qaessafty-arch/Plc/DOCUMENTATION/REPORTS/budget.md

# Estimated budget

> Generated by `ELECTRICAL/BOM/budget.py` from `bom.csv`. **Every unit price is an estimate** made without supplier quotations, except two items whose range was taken from public supplier listings seen on 2026-11-11 (marked in the `price_basis` column). No price in this project is a verified purchase price. Freight, customs, VAT and local distributor margins for Iraq are covered only by the contingency line.

Exchange rate: 1 USD = 1320 IQD (Central Bank of Iraq cash selling rate, checked 2026-11-11; the parallel market rate may differ).

| Group | 1 Educational prototype | 2 Semi-industrial machine | 3 Industrial machine |
|---|---:|---:|---:|
| Structure | 722 | 5,872 | 5,872 |
| Film | 1,115 | 2,015 | 2,805 |
| Pull | 610 | 1,980 | 1,980 |
| Seal | 1,077 | 1,127 | 1,127 |
| Pneumatic | 1,095 | 1,170 | 1,170 |
| Control | 1,320 | 2,280 | 3,160 |
| Safety | 425 | 860 | 560 |
| Power | 1,925 | 2,301 | 2,301 |
| Sensors | 374 | 694 | 694 |
| Weighing | 205 | 9,000 | 45,000 |
| Conveying | 150 | 4,400 | 4,400 |
| Options | 0 | 0 | 20,900 |
| Services | 3,150 | 14,900 | 22,600 |
| **Subtotal USD** | **12,168** | **46,599** | **112,569** |
| Contingency + freight/customs allowance | 15% = 1,825 | 20% = 9,320 | 20% = 22,514 |
| **Total USD** | **13,993** | **55,919** | **135,083** |
| **Total IQD** | **18,471,024** | **73,812,816** | **178,309,296** |
| Expected accuracy of this estimate | +/-40 % | +/-30 % | +/-35 % |

## What each configuration is

| | 1 Educational prototype | 2 Semi-industrial | 3 Industrial |
|---|---|---|---|
| Purpose | teach/prove the VFFS sequence | small factory production | continuous production with QA records |
| Frame | aluminium profile, bench size | welded 304 stainless | welded 304, hygienic detailing, documented materials |
| Film / bag | <= 250 mm web, 60-110 mm bags | 420 mm web, 80-200 mm bags | same + gusset / hole-punch options |
| Weighing | single weigh bucket + vibratory tray (self-built) | economy 10-head multihead (bought) | branded 10/14-head, approvable for trade |
| Film drive | closed-loop stepper | 0.4 kW servo | servo; servo jaws as later option |
| Control | S7-1200 1214C + 4" panel | S7-1200 1215C + KTP700 + safety relays | fail-safe S7-1200 F + KTP700 + monitoring PC |
| Quality devices | none | none (manual sampling) | checkweigher, metal detector, coder, N2 |
| Expected speed | 8-15 bags/min (theoretical) | 30-45 bags/min (theoretical) | 40-60 bags/min (theoretical) |
| Suitable for selling food? | no | only after safety validation and hygiene review | yes, after conformity assessment |

## Operating cost outline (semi-industrial, theoretical)

Energy and film per hour are in `DOCUMENTATION/ENGINEERING/03_ENGINEERING_CALCULATIONS.md` section 8. Add: 1 operator + shared loader; product give-away (simulated ~1.4 % at 40 g, see `SIMULATION/weigher_results.json`); wear parts per year - PTFE tape, 2 knives, 1 pair pull belts, 2 heater sets, thermocouples: roughly 400-700 USD [estimate]; annual weigher calibration service.

BOM lines: 77. Items with `model_status` = *verified* had their order number and key data checked against manufacturer data on 2026-11-11; *from memory - confirm* must be checked in the manufacturer catalogue before ordering; *generic* means the specification is binding and the brand is free; *to quote/select* needs a supplier offer.
