qaessafty-arch/Plc/DOCUMENTATION/ENGINEERING/03_ENGINEERING_CALCULATIONS.md

# 03 - Engineering calculations (SPM-420, rev P1 (preliminary - not released for manufacture))

> Generated by `engineering_calcs.py` from `machine_params.py`. Do not edit by hand.
> **Every number below is a theoretical design value.** Inputs marked [ASM] in `machine_params.py` are assumptions that must be replaced by measurements before the design is released.

## 1. Bag, film and forming-tube geometry

Tube circumference = 2 x flat bag width, so `D = 2W/pi`. Film width = `2W + overlap`. Maximum pillow volume uses Robin's paper-bag approximation with the unsealed length `L - 2 x seal land`. Fill ratio = product bulk volume / maximum pillow volume; the design limit is 0.65 so the jaws never close on product.
| Product | Target g | Bulk density g/L [ASM] | Bag W x L mm | Tube OD mm | Film width mm | Product L | Max pillow L | Fill ratio | Check |
|---|---|---|---|---|---|---|---|---|---|
| Potato chips 40 g | 40.0 | 60.0 | 160 x 230 | 101.9 | 340 | 0.67 | 1.13 | 0.59 | OK |
| Extruded puffs 30 g | 30.0 | 45.0 | 160 x 240 | 101.9 | 340 | 0.67 | 1.20 | 0.55 | OK |
| Crackers 100 g | 100.0 | 250.0 | 140 x 200 | 89.1 | 300 | 0.40 | 0.73 | 0.55 | OK |
| Mini biscuits 150 g | 150.0 | 350.0 | 140 x 200 | 89.1 | 300 | 0.43 | 0.73 | 0.59 | OK |
| Coated nuts / mix 200 g | 200.0 | 600.0 | 140 x 190 | 89.1 | 300 | 0.33 | 0.67 | 0.50 | OK |

Maximum bag width from the 420 mm web: (420 - 20)/2 = **200 mm**; largest forming tube OD = 127.3 mm. Each bag width needs its own forming set (collar + tube): they are format parts.

## 2. Machine cycle and theoretical speed (intermittent motion)

| Bag length mm | Pull time s | Peak film speed m/s | Mechanical cycle s | Mechanical limit bags/min |
|---|---|---|---|---|
| 100 | 0.258 | 0.77 | 1.058 | 56.7 |
| 150 | 0.321 | 0.80 | 1.121 | 53.5 |
| 200 | 0.383 | 0.80 | 1.183 | 50.7 |
| 230 | 0.421 | 0.80 | 1.221 | 49.1 |
| 300 | 0.508 | 0.80 | 1.308 | 45.9 |

Cycle = jaw close 0.15 + seal dwell 0.45 + jaw open 0.15 + film pull + settle 0.05 s. Pull uses a trapezoidal profile, a = 6.0 m/s2, vmax = 0.8 m/s [ASM: limited by belt/film friction].

**Product transfer.** Drop from weigh-hopper gate to jaw plane = 1.90 m. Leading-edge free-fall time = sqrt(2h/g) = 0.62 s (air drag ignored, so the real value is longer). Chips arrive as a string; string duration is assumed 0.35 s [ASM - measure with high-speed video]. Tail arrival = 0.97 s after the dump command. The dump is commanded when the jaws start closing, so the tail must arrive before the *next* jaw-close starts, i.e. within one cycle minus jaw-close time: 1.07 s at the mechanical limit -> OK.

Theoretical limit for the reference bag = min(mechanical 49.1, weigher 70, product string 53.5) = **49.1 bags/min**. Rated design point: **40 bags/min** (19 % margin). Validated speed: *none yet*.

## 3. Film-pull servo sizing

| Quantity | Value |
|---|---|
| Film drag (collar + unwind) [ASM] | 60 N |
| Accelerated mass (film + 2 belts) | 0.62 kg |
| Peak belt force | 63.7 N |
| Torque at drive pulleys | 1.91 N.m |
| Load inertia reflected to motor | 0.404 kg.cm2 |
| Peak motor torque (gearbox eff. 0.9) | 0.47 N.m |
| RMS motor torque at rated speed | 0.25 N.m |
| Peak motor speed | 1273 rpm |
| Selected motor rated torque / speed [VER] | 1.27 N.m / 3000 rpm |
| Torque utilisation (peak / rated) | 37 % |
| Speed utilisation | 42 % |

One 0.4 kW servo drives both pull belts through a 5:1 planetary gearbox and a cross shaft with two bevel/timing stages, so the belts cannot run at different speeds. The 0.4 kW frame is the smallest V90 PROFINET size and is deliberately oversized: the unknown is film drag, and margin costs little. Inertia ratio must be checked against the motor rotor inertia in the Siemens data sheet (not transcribed here).

Length resolution with the 2500 ppr TTL encoder (x4): 3.8 um of film per count - three orders finer than the +/-1 mm bag-length target, so accuracy is governed by belt slip and registration, not by the drive.

## 4. Sealing forces and pneumatic sizing

| Actuator | Required force N | ISO cylinder | Force at 0.6 MPa, eff. 0.9 N | Safety factor | Free air per cycle NL | NL/min at 40 bpm |
|---|---|---|---|---|---|---|
| Horizontal jaws | 2304 | dia 63 x 60 | 1683 | 0.73 | 2.46 | 98 |
| Vertical seal bar | 640 | dia 40 x 30 | 679 | 1.06 | 0.48 | 19 |
| Knife | 150 | dia 25 x 20 | 265 | 1.77 | 0.13 | 5 |

Jaw seal area counts both transverse seals (top of the finished bag and bottom of the next) = 240 x 24 mm. Knife force 150 N is an assumption for 50 um laminate with a serrated blade. Actuators total 123 NL/min; adding 30 % for leakage/tubing and 30 NL/min for the optional bag-deflate/air-blast gives **189 NL/min (0.19 m3/min) at 0.6 MPa**. Specify a compressor of at least 0.28 m3/min FAD with dryer and 0.01 um oil-removal filtration (ISO 8573-1 class 1.4.1 where air can contact product or film inside).

Maximum jaw closing force 1870 N is a crushing hazard: see the safety file - guard interlock, not force limitation, is the protective measure.

## 5. Heating

| Zone | Mass kg | Heater W | Energy to 150 C kJ | Warm-up min (80 % to metal) |
|---|---|---|---|---|
| Z1 front jaw (steel) | 2.26 | 500 | 138 | 5.8 |
| Z2 rear jaw (steel) | 2.26 | 500 | 138 | 5.8 |
| Z3 vertical bar (aluminium) | 0.65 | 300 | 73 | 5.1 |

Steady state: heat carried away by the film in the seal lands = 116 W at 40 bpm (c = 1900 J/kg.K); convective/radiative loss estimated at ~131 W (3 bars, h = 10 W/m2K, ~0.035 m2 each [ASM]). Installed 1300 W gives a duty cycle of roughly 19 %, which leaves PID authority for recovery after a stop. Each zone has a type-K thermocouple in the jaw, time-proportioned SSR control from the PLC, and an independent bimetal cut-out (manual reset, 250 C) in series with the heater contactor coil.

## 6. Throughput, elevator and weigher capacity

| Product | kg/h at 40 bpm | L/h | Elevator utilisation |
|---|---|---|---|
| Potato chips 40 g | 96 | 1600 | 31 % |
| Extruded puffs 30 g | 72 | 1600 | 31 % |
| Crackers 100 g | 240 | 960 | 19 % |
| Mini biscuits 150 g | 360 | 1029 | 20 % |
| Coated nuts / mix 200 g | 480 | 800 | 16 % |

Z-bucket elevator: 1.8 L buckets at 152.4 mm pitch, filled to 60% (fragile product must not be heaped), chain speed 0.2 m/s -> **5102 L/h**. The elevator runs on demand from the weigher infeed level sensor, so utilisation above ~70 % means the speed (VFD) must be raised for that product.

Combination count for a 10-head weigher: C(10,3) = 120, C(10,4) = 210, C(10,5) = 252; all subsets = 1023. Accuracy is evaluated by Monte-Carlo in `SIMULATION/weigher_sim.py`, not asserted here.

Per-head target charge for 40 g = target / 3.5 = 11.4 g = 0.19 L -> 12 % of the 1.6 L hopper (must stay below ~70 % for chips so gates close cleanly).

## 7. Electrical load, protection and cable sizing

| Load | Input kW | Phase | PF [ASM] | Current A | Note |
|---|---|---|---|---|---|
| Multihead weigher (OEM cabinet) | 1.50 | L1 | 0.9 | 7.2 | own internal protection |
| Heaters Z1+Z2+Z3 | 1.30 | L2 | 1.0 | 5.7 | 3 SSR zones |
| 24 V DC power supply 240 W | 0.27 | L2 | 0.95 | 1.2 | PLC, HMI, valves, sensors |
| Film servo drive 0.4 kW | 0.47 | L3 | 0.7 | 2.9 | peak 3x for <0.3 s |
| Elevator VFD 0.37 kW | 0.49 | L3 | 0.7 | 3.1 | 1AC in / 3AC 230 V out |
| Take-off VFD 0.18 kW | 0.26 | L3 | 0.7 | 1.6 |  |
| Infeed vibratory feeder | 0.10 | L1 | 0.6 | 0.7 | thyristor controller |
| Date coder / service socket allowance | 0.30 | L1 | 0.9 | 1.4 |  |

Connected load **4.69 kW**; phase currents L1 9.4 A, L2 6.9 A, L3 7.6 A (arithmetic sum, conservative). Estimated running demand at 0.7 diversity: 3.3 kW.

* Main protective device: 16 A 4-pole C-curve MCB (>= 1.25 x 9.4 A), 10 kA; upstream short-circuit level must be confirmed on site.
* Supply disconnector: 4-pole, lockable in OFF, AC-23 >= 25 A, red/yellow handle (IEC 60204-1 5.3).
* Supply cable: 5G4 mm2 Cu (PVC, 30 C, method B2 ~ 27 A) for a 16 A device; voltage drop at 30 m = 2.8 V (0.69 %).
* Residual-current protection: servo drive and VFDs produce DC-component leakage; if an RCD is required by the installation use type B, 300 mA, and keep the 30 mA type A device for the service socket only.
| 24 V DC consumer | A |
|---|---|
| CPU 1215C + SM 1223 + SM 1231 logic | 0.75 |
| KTP700 HMI [VER 0.23 A] | 0.23 |
| Sensors, 16 x 25 mA | 0.40 |
| Solenoid valves, 6 x 2.5 W simultaneous | 0.63 |
| SSR inputs 3 x 15 mA | 0.05 |
| Safety relays 2 x 2.5 W | 0.21 |
| Stack light + buzzer | 0.20 |
| Interface relays 8 x 0.4 W | 0.14 |
| Ethernet switch | 0.25 |
| Servo/VFD control 24 V | 1.00 |
| **Total** | **3.86** |

Selected supply 24 V / 10 A (load 39 %). Split into fused branches: F10 PLC/HMI 4 A, F11 sensors 2 A, F12 outputs via safety relay 4 A, F13 drives control 2 A.

## 8. Consumables and operating cost (theoretical)

| Item | Value |
|---|---|
| Net output at 85 % efficiency [ASM] | 2040 bags/h = 82 kg/h |
| Film per bag | 782 cm2 = 3.56 g |
| Film per hour | 7.26 kg |
| Length on a full 400 mm roll | 2397 m |
| Running time per roll | 261 min |
| Electrical energy incl. compressor share | 4.4 kWh/h |
| Energy + film cost | 25.84 USD/h = 34,114 IQD/h |
| Energy + film per 1000 bags | 12.67 USD = 16,722 IQD |

Tariff 0.1 USD/kWh and film 3.5 USD/kg are placeholders [ASM]. Labour, product give-away, maintenance and depreciation are in `DOCUMENTATION/REPORTS/budget.md`.

## 9. Footprint derivation

| Bagger dimension | Build-up | Result mm | Adopted mm |
|---|---|---|---|
| Width (X) | roller face 450 + side plates/bearings 110 + frame tubes 100 + drive bay 140 + pneumatic/cable bay 200 | 1000 | 1000 |
| Depth (Y) | front guard-to-tube 350 + pull-belt carriage 200 + dancer/festoon 250 + roll 400 + 100 | 1300 | 1300 |
| Height (Z) | jaw plane 700 (take-off conveyor 350 + max bag 300 + 50) ; belts 800-1050 ; collar top 1450 ; frame top | 1500 | 1500 |

| Line envelope | mm | Governed by |
|---|---|---|
| Length (X) | 4450 | elevator infeed hopper to end of take-off conveyor |
| Width (Y) | 1900 | weigher access platform |
| Height (Z) | 3900 | weigher base + weigher + elevator discharge head |
| Bagger only | 1000 x 1300 x 1700 | frame + infeed funnel |

| Clearance | mm | Reason |
|---|---|---|
| Front (operator, HMI, jaw doors) | 1200 | operator zone, door swing 600 + 600 standing |
| Rear (film roll change) | 1000 | roll trolley / lift access |
| Left and right ends | 800 | product loading at elevator hopper, bag collection |
| Cabinet door | 800 | IEC 60204-1 access, door 600 wide opens >= 95 deg |
| Overhead | 500 | weigher hopper removal for cleaning |

**Required floor area: 6050 x 4100 mm = 24.8 m2; minimum clear ceiling 4400 mm.** These are PRELIMINARY dimensions derived from the selected components; none is a validated manufacturing dimension until the weigher and elevator supplier drawings are frozen.

## 10. Structural checks (first order)

| Check | Value |
|---|---|
| Platform design load (weigher + deck + 2 persons) | 7161 N |
| Leg section | SHS 80 x 80 x 3, 1.4301 (304) |
| Axial stress per leg, load factor 1.5 | 2.9 MPa (yield 210 MPa) |
| Slenderness (K=1) | 64 |
| Euler buckling load per leg, K=2 (unbraced cantilever) | 109 kN vs demand 2.7 kN |

Stress is not the governing criterion; **stiffness is**. A multihead weigher needs a platform whose first natural frequency is well above the feeder excitation and the weigh-cell filter band (suppliers typically ask for > 15 Hz and floor vibration < 0.1 g). The platform therefore gets diagonal bracing on three sides and floor anchors, and the bagger is NOT bolted to it - the jaw impact must not reach the load cells. A modal FEA of the welded platform is an open action before release.
