qaessafty-arch/Plc/CAD/DRAWINGS/GA-002_floor_layout.pdf

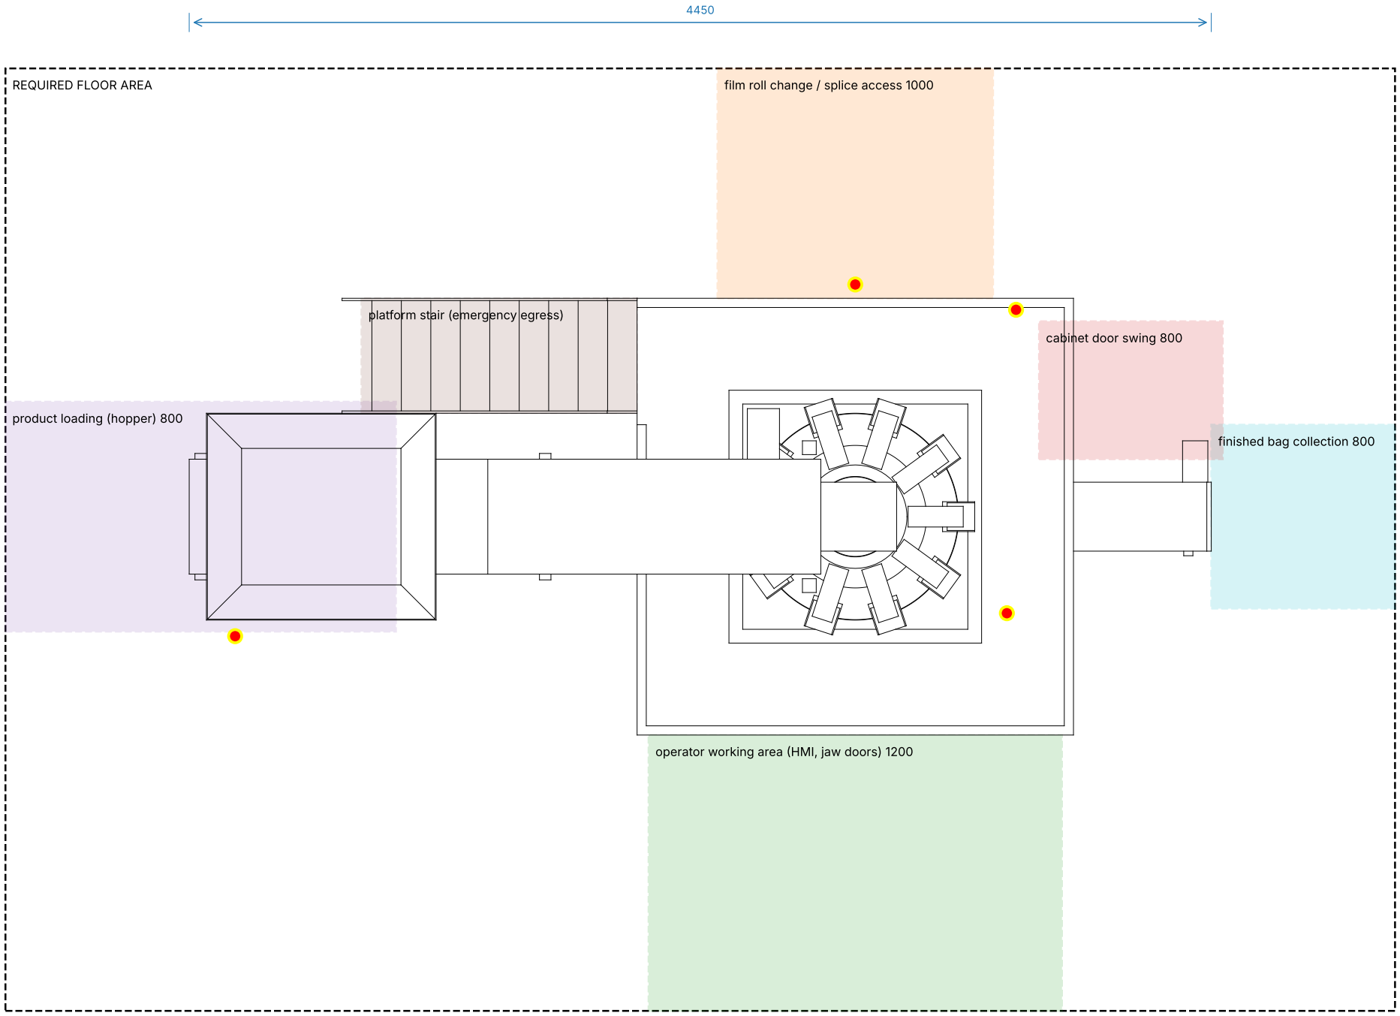
[picture p16: figure]
REQUIRED FLOOR AREA; film roll change / splice access 1000; product loading (hopper) 800; finished bag collection 800; cabinet door swing 800; platform stair (emergency egress)

operator working area (HMI, jaw doors) 1200

6050

4100

1900

FLOOR LAYOUT required area 6050 x 4100 mm = 24.8 m2, min. clear ceiling 4400 mm. Emergency stops: HMI station, rear film side, platform, elevator infeed.

PRELIMINARY - NOT FOR MANUFACTURE | SPM-420 | GA-002 | Floor layout and access zones | rev P1 (preliminary - not released for manufacture) | units mm | red dots = E-stop devices
