qaessafty-arch/Plc/CAD/EXPLODED/SPM-420_exploded.png

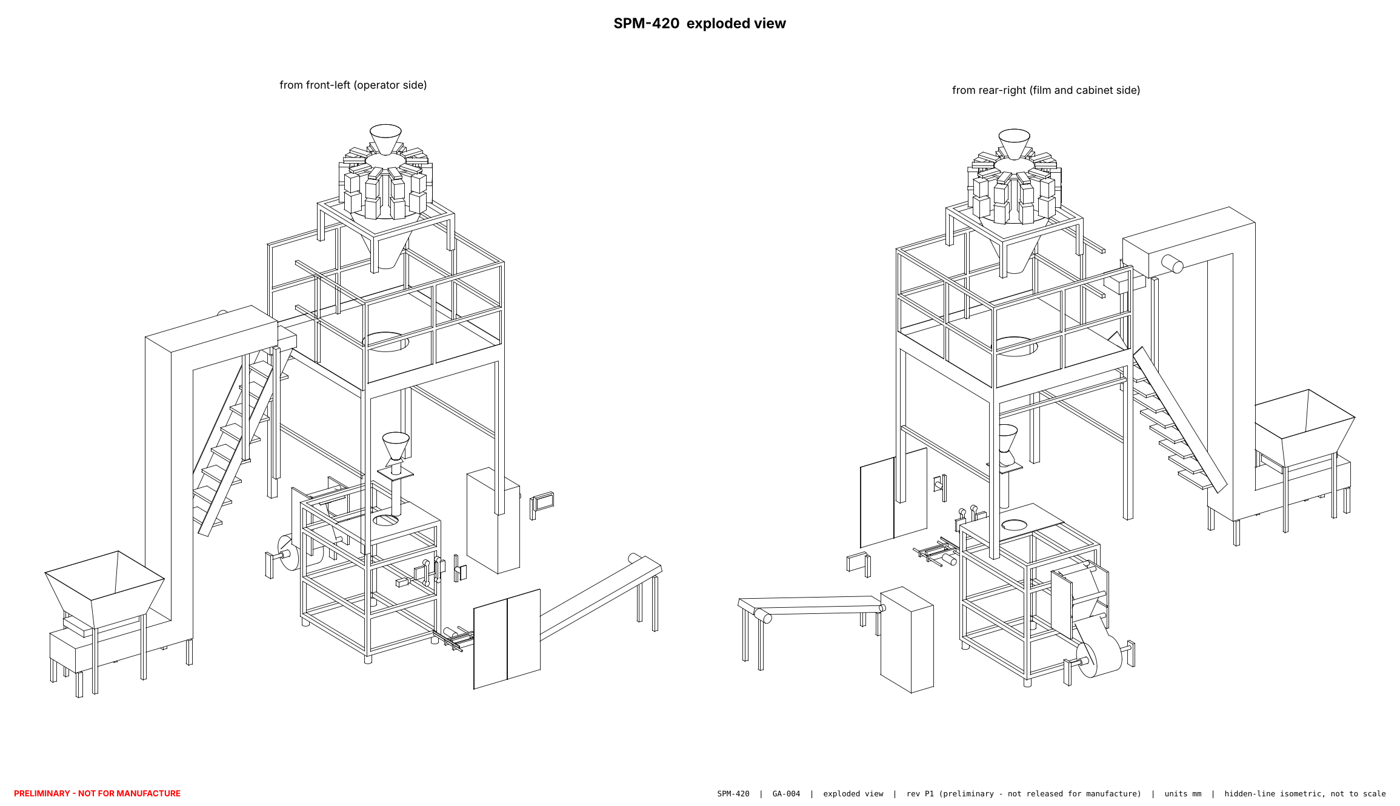
CAD/EXPLODED/SPM-420_exploded.png
