qaessafty-arch/Plc/WEB3D/downloads/CD-000_component_drawings.pdf

## B01_main_frame

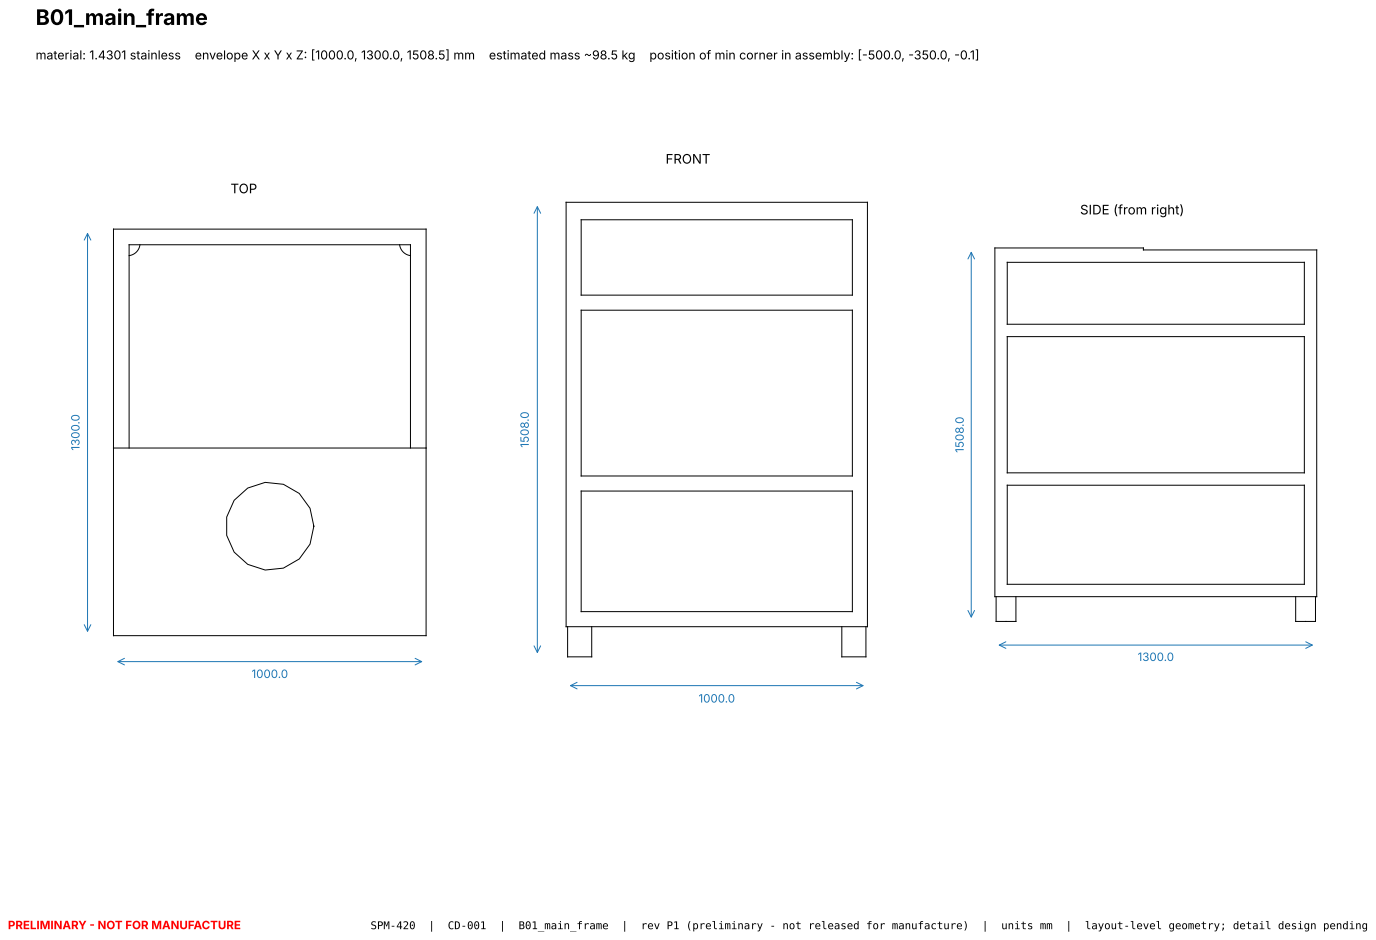
[picture p18: page 1]
TOP; FRONT; PRELIMINARY - NOT FOR MANUFACTURE; SPM-420 | CD-001 | B01_main_frame | rev P1 (preliminary - not released for manufacture) | units mm | layout-level geometry; detail design pending

material: 1.4301 stainless envelope X x Y x Z: [1000.0, 1300.0, 1508.5] mm estimated mass ~98.5 kg position of min corner in assembly: [-500.0, -350.0, -0.1]

SIDE (from right)

## B02_film_roll

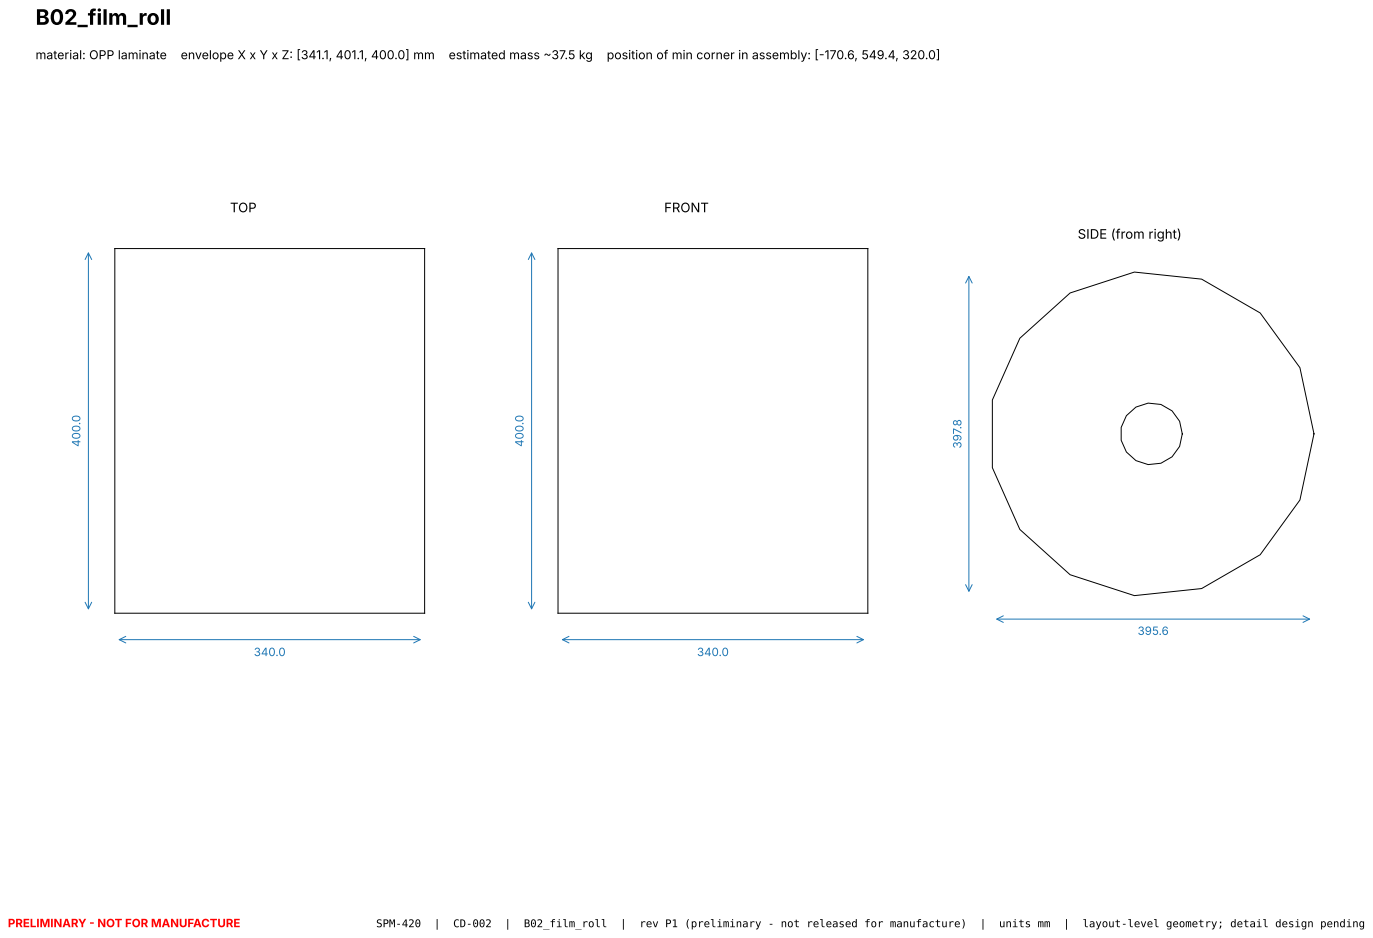
[picture p19: page 2]
TOP; FRONT; PRELIMINARY - NOT FOR MANUFACTURE; SPM-420 | CD-002 | B02_film_roll | rev P1 (preliminary - not released for manufacture) | units mm | layout-level geometry; detail design pending

material: OPP laminate envelope X x Y x Z: [341.1, 401.1, 400.0] mm estimated mass ~37.5 kg position of min corner in assembly: [-170.6, 549.4, 320.0]

SIDE (from right)

## B03_unwind_shaft

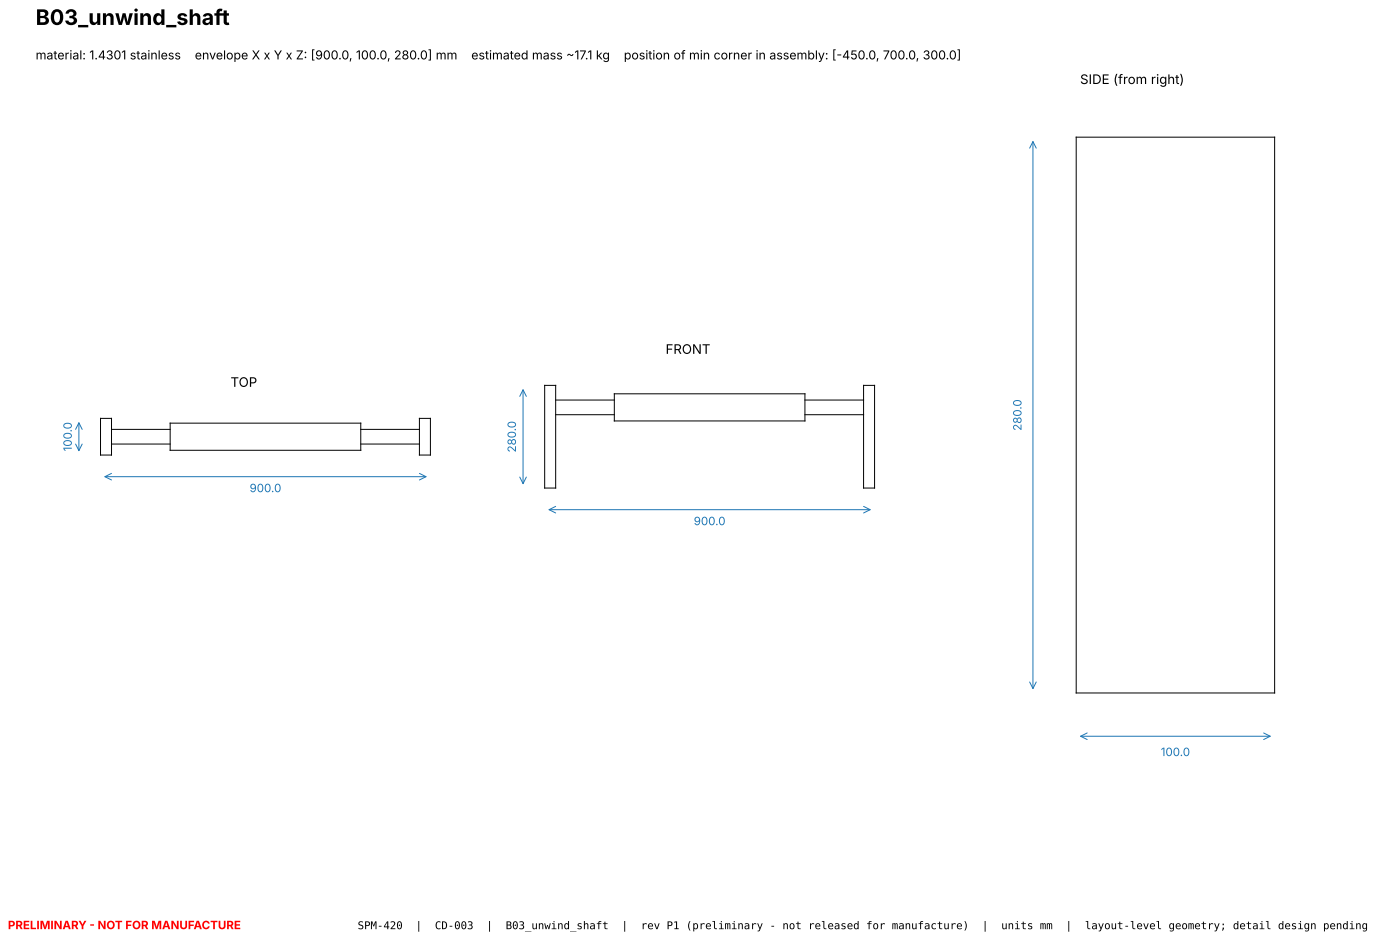
[picture p20: page 3]
TOP; FRONT; PRELIMINARY - NOT FOR MANUFACTURE; SPM-420 | CD-003 | B03_unwind_shaft | rev P1 (preliminary - not released for manufacture) | units mm | layout-level geometry; detail design pending

material: 1.4301 stainless envelope X x Y x Z: [900.0, 100.0, 280.0] mm estimated mass ~17.1 kg position of min corner in assembly: [-450.0, 700.0, 300.0]

SIDE (from right)

## B04_guide_rollers

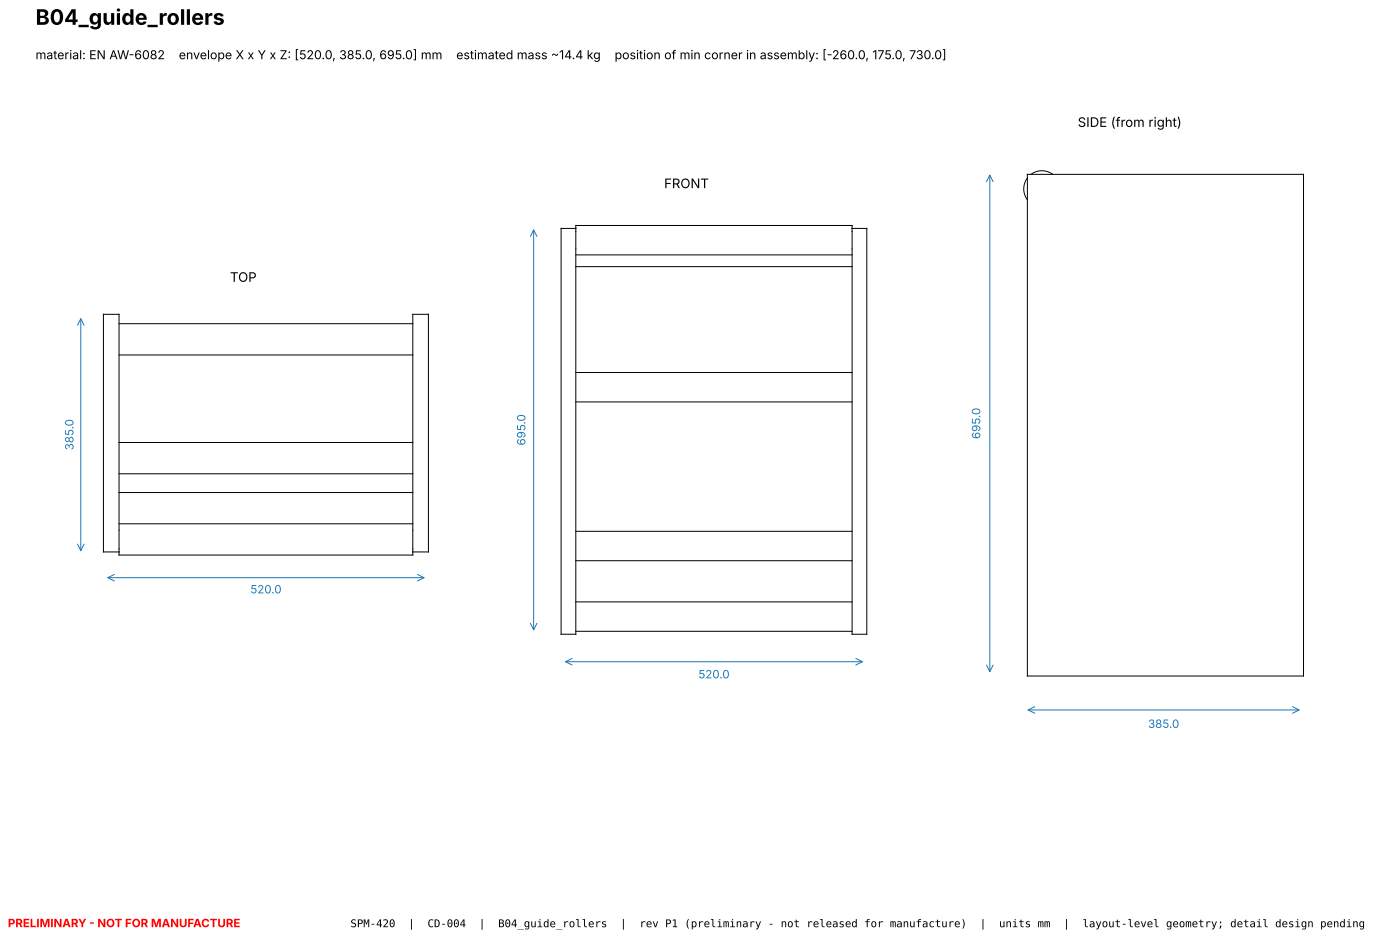
[picture p21: page 4]
TOP; FRONT; PRELIMINARY - NOT FOR MANUFACTURE; SPM-420 | CD-004 | B04_guide_rollers | rev P1 (preliminary - not released for manufacture) | units mm | layout-level geometry; detail design pending

material: EN AW-6082 envelope X x Y x Z: [520.0, 385.0, 695.0] mm estimated mass ~14.4 kg position of min corner in assembly: [-260.0, 175.0, 730.0]

SIDE (from right)

## B05_dancer_arm

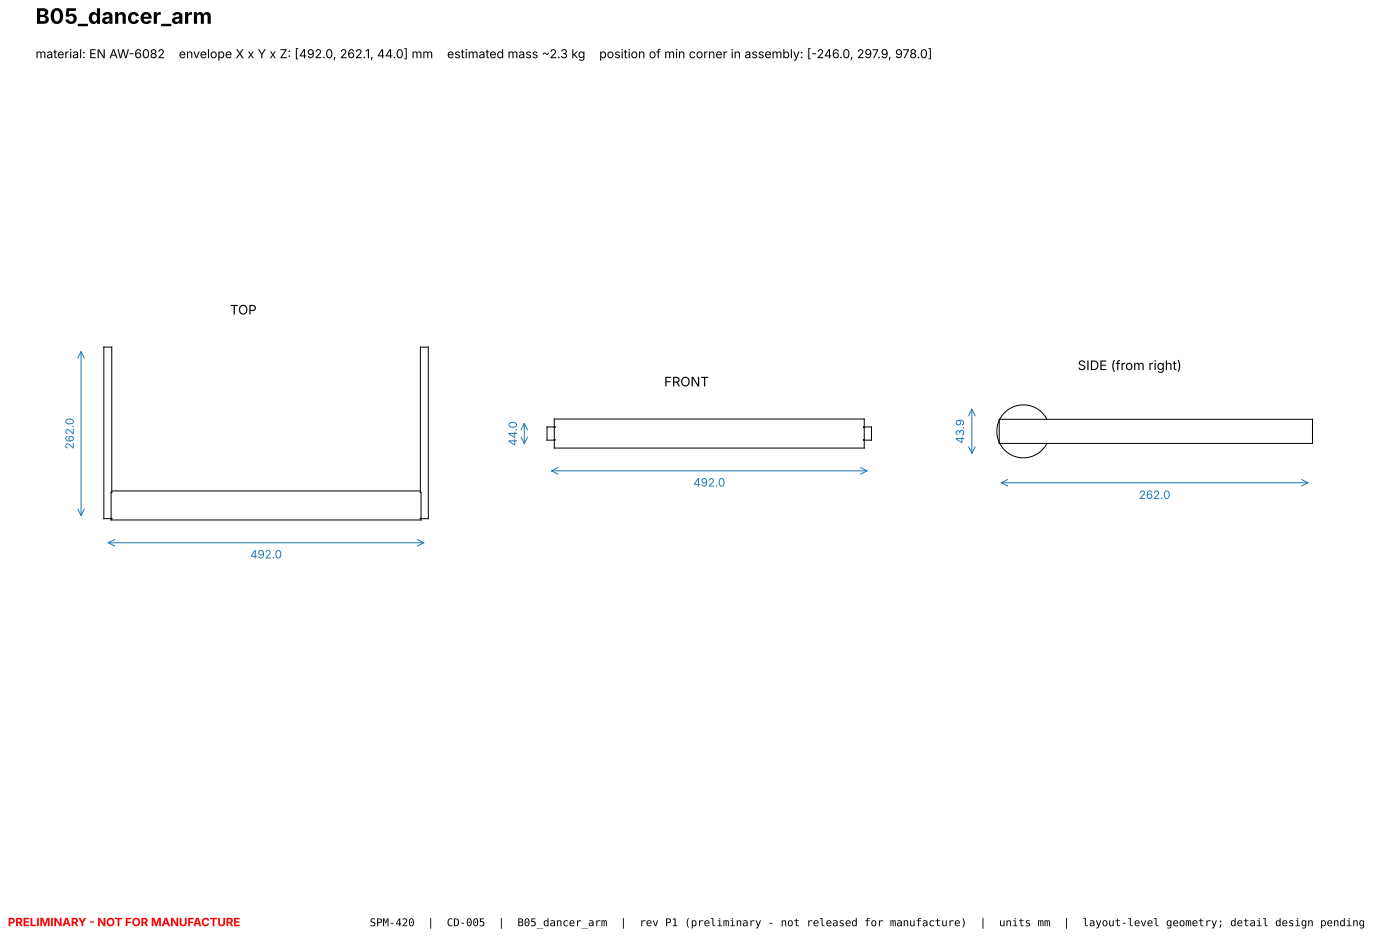
[picture p22: page 5]
TOP; FRONT; PRELIMINARY - NOT FOR MANUFACTURE; SPM-420 | CD-005 | B05_dancer_arm | rev P1 (preliminary - not released for manufacture) | units mm | layout-level geometry; detail design pending

material: EN AW-6082 envelope X x Y x Z: [492.0, 262.1, 44.0] mm estimated mass ~2.3 kg position of min corner in assembly: [-246.0, 297.9, 978.0]

SIDE (from right)

## B06_forming_tube

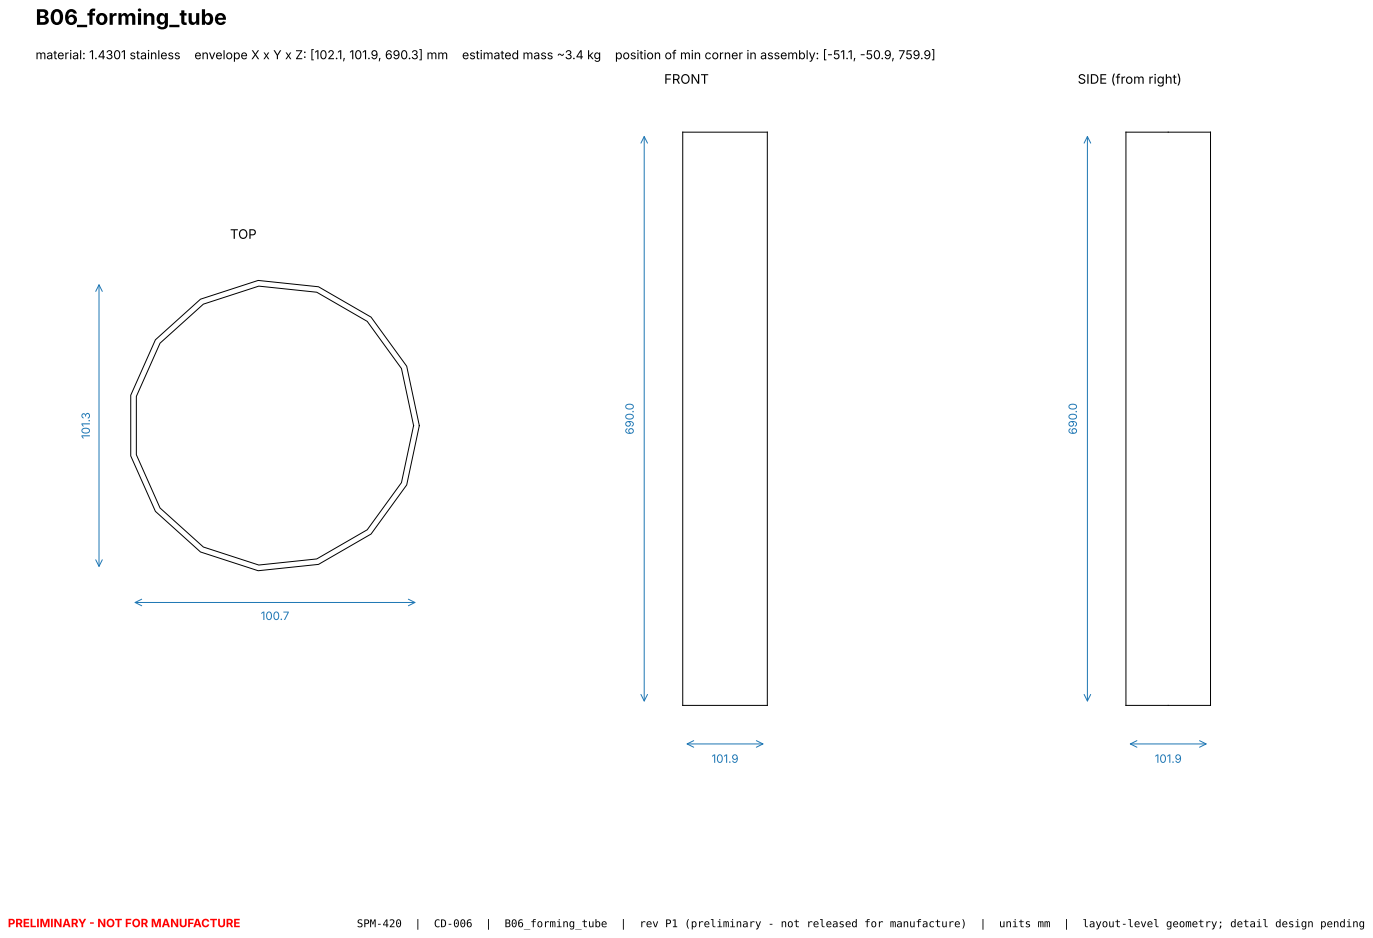
[picture p23: page 6]
TOP; FRONT; PRELIMINARY - NOT FOR MANUFACTURE; SPM-420 | CD-006 | B06_forming_tube | rev P1 (preliminary - not released for manufacture) | units mm | layout-level geometry; detail design pending

material: 1.4301 stainless envelope X x Y x Z: [102.1, 101.9, 690.3] mm estimated mass ~3.4 kg position of min corner in assembly: [-51.1, -50.9, 759.9]

SIDE (from right)

## B07_forming_collar

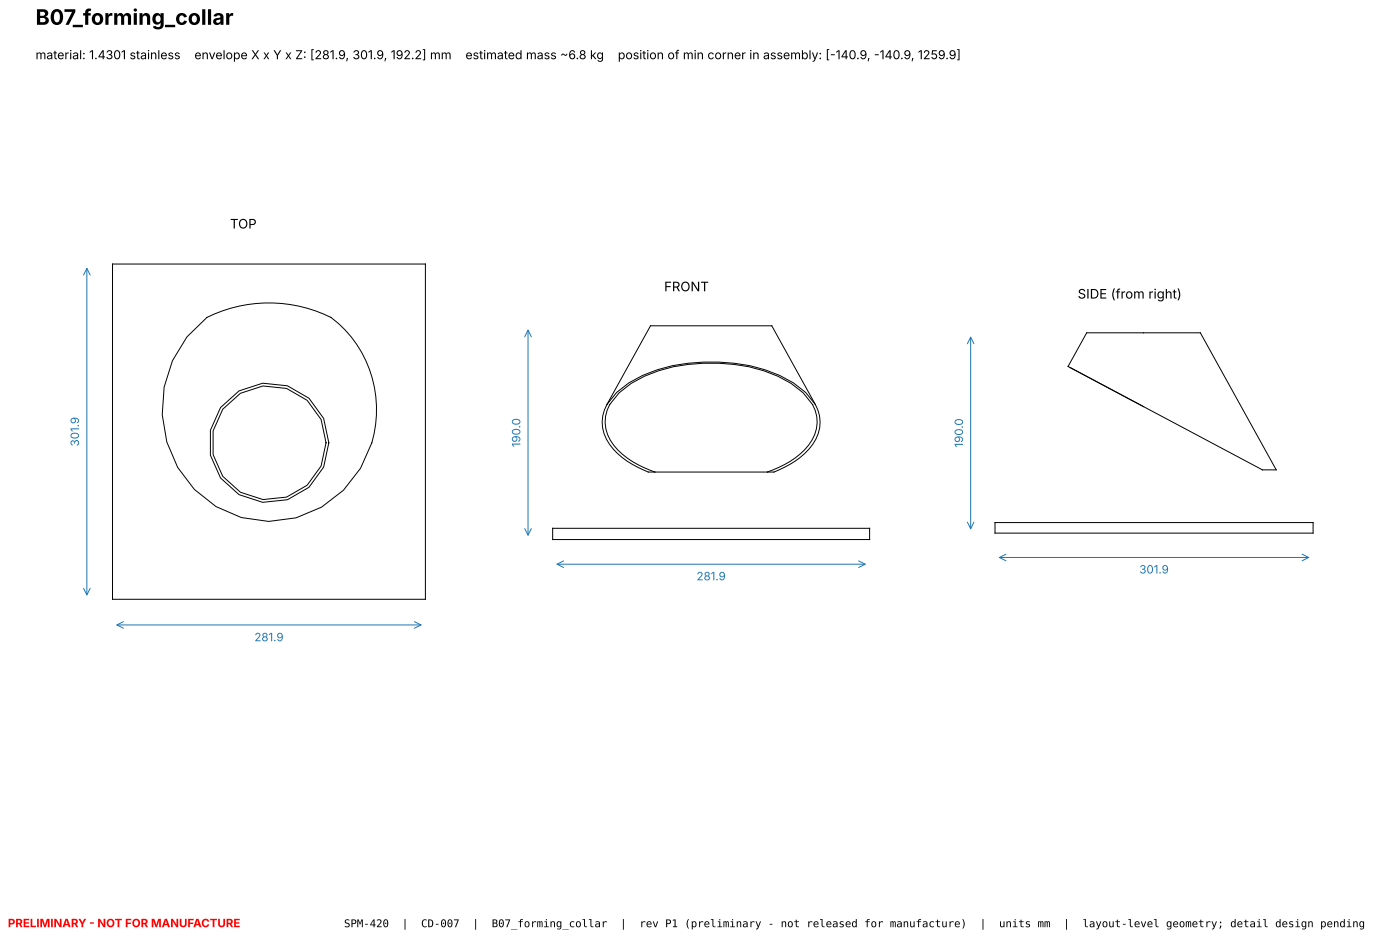
[picture p24: page 7]
TOP; FRONT; PRELIMINARY - NOT FOR MANUFACTURE; SPM-420 | CD-007 | B07_forming_collar | rev P1 (preliminary - not released for manufacture) | units mm | layout-level geometry; detail design pending

material: 1.4301 stainless envelope X x Y x Z: [281.9, 301.9, 192.2] mm estimated mass ~6.8 kg position of min corner in assembly: [-140.9, -140.9, 1259.9]

SIDE (from right)

## B08_infeed_funnel

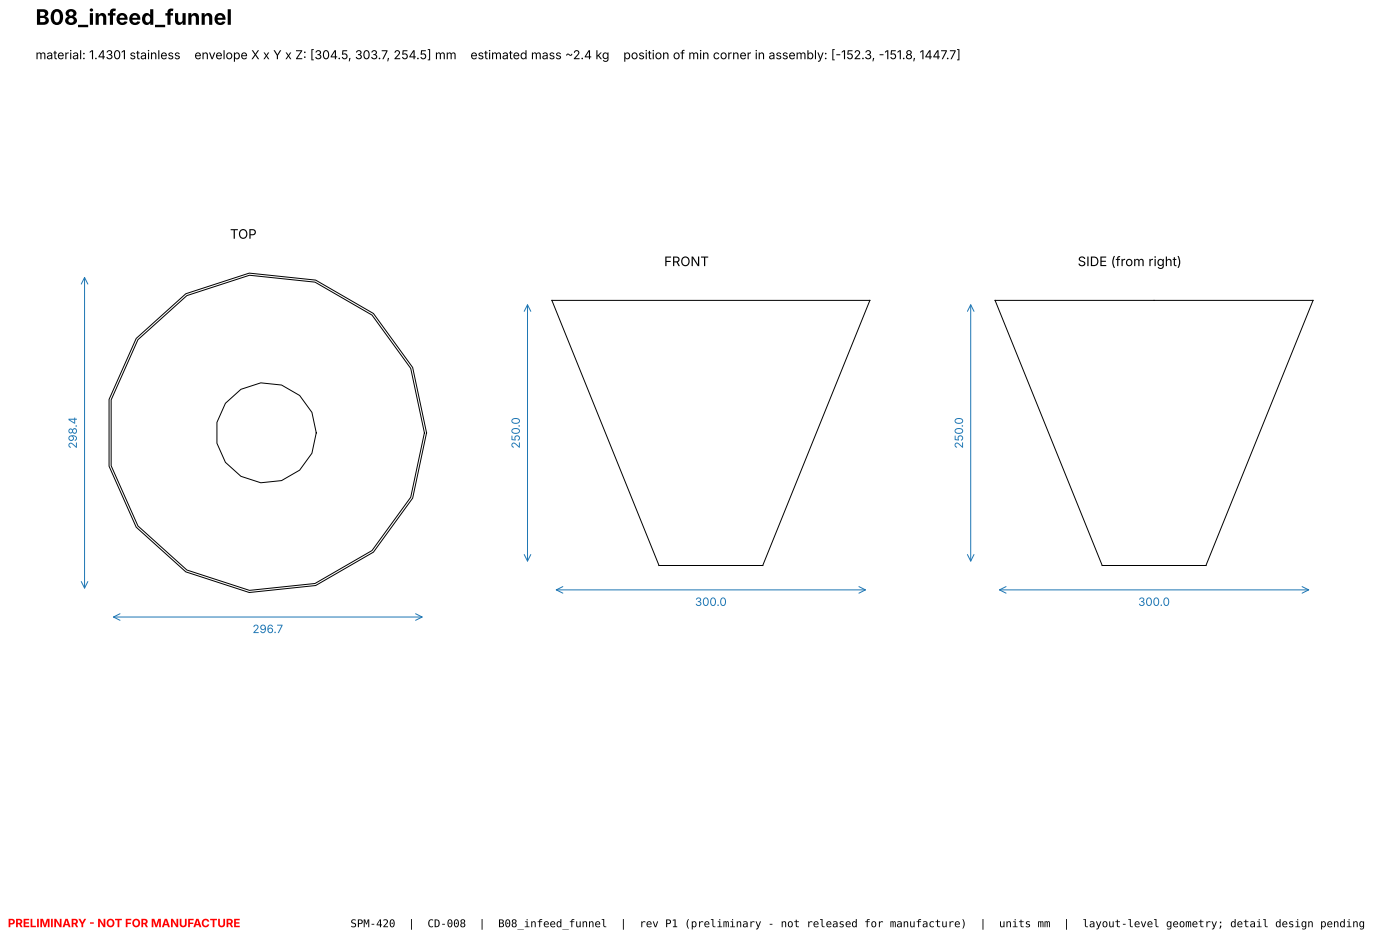
[picture p25: page 8]
TOP; FRONT; PRELIMINARY - NOT FOR MANUFACTURE; SPM-420 | CD-008 | B08_infeed_funnel | rev P1 (preliminary - not released for manufacture) | units mm | layout-level geometry; detail design pending

material: 1.4301 stainless envelope X x Y x Z: [304.5, 303.7, 254.5] mm estimated mass ~2.4 kg position of min corner in assembly: [-152.3, -151.8, 1447.7]

SIDE (from right)

## B09_pull_belt_left

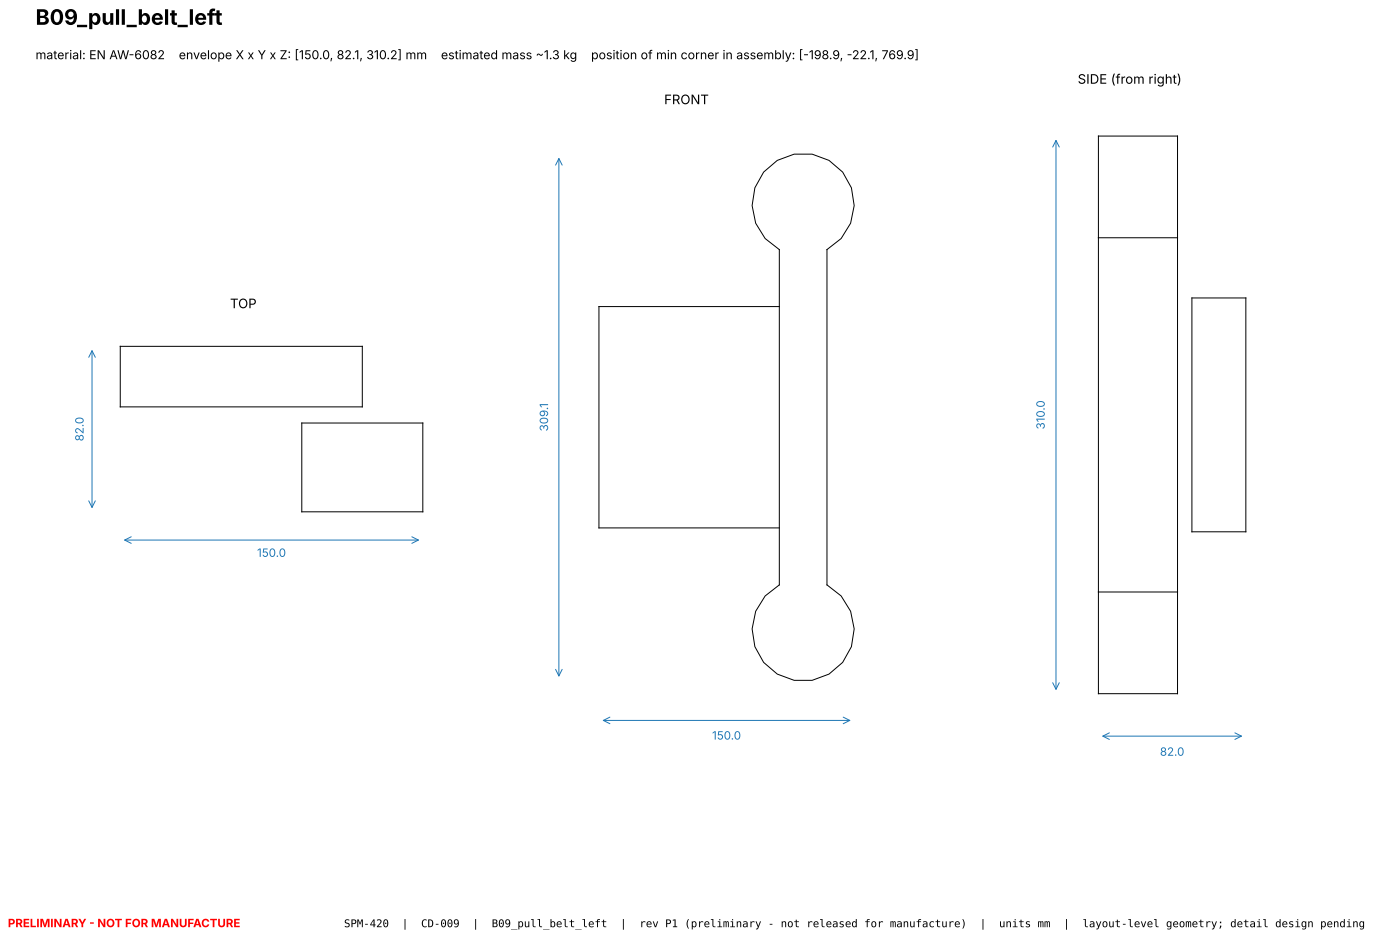
[picture p26: page 9]
TOP; FRONT; PRELIMINARY - NOT FOR MANUFACTURE; SPM-420 | CD-009 | B09_pull_belt_left | rev P1 (preliminary - not released for manufacture) | units mm | layout-level geometry; detail design pending

material: EN AW-6082 envelope X x Y x Z: [150.0, 82.1, 310.2] mm estimated mass ~1.3 kg position of min corner in assembly: [-198.9, -22.1, 769.9]

SIDE (from right)

## B10_pull_belt_right

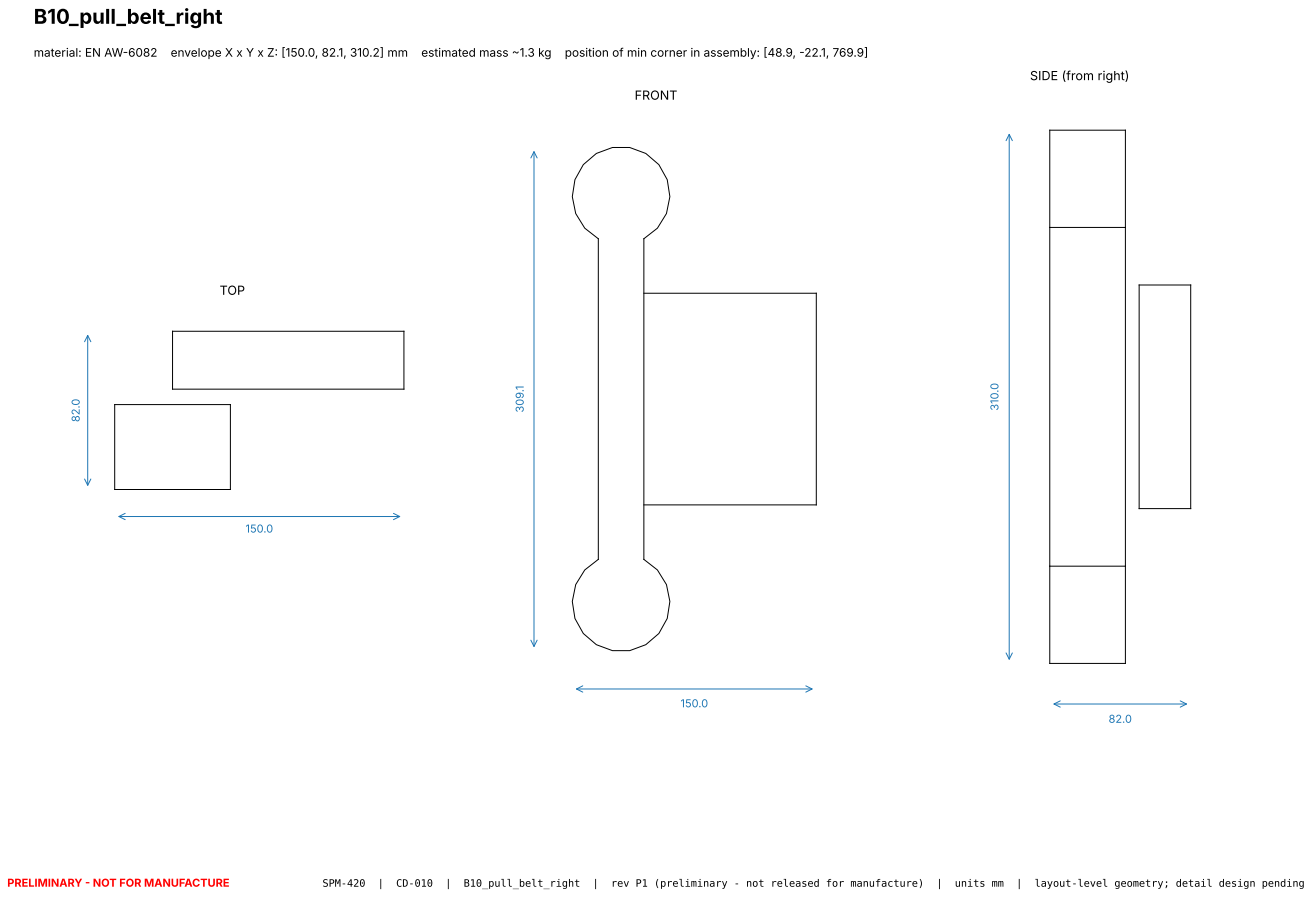
[picture p27: page 10]
TOP; FRONT; PRELIMINARY - NOT FOR MANUFACTURE; SPM-420 | CD-010 | B10_pull_belt_right | rev P1 (preliminary - not released for manufacture) | units mm | layout-level geometry; detail design pending

material: EN AW-6082 envelope X x Y x Z: [150.0, 82.1, 310.2] mm estimated mass ~1.3 kg position of min corner in assembly: [48.9, -22.1, 769.9]

SIDE (from right)

## B11_belt_servo_drive

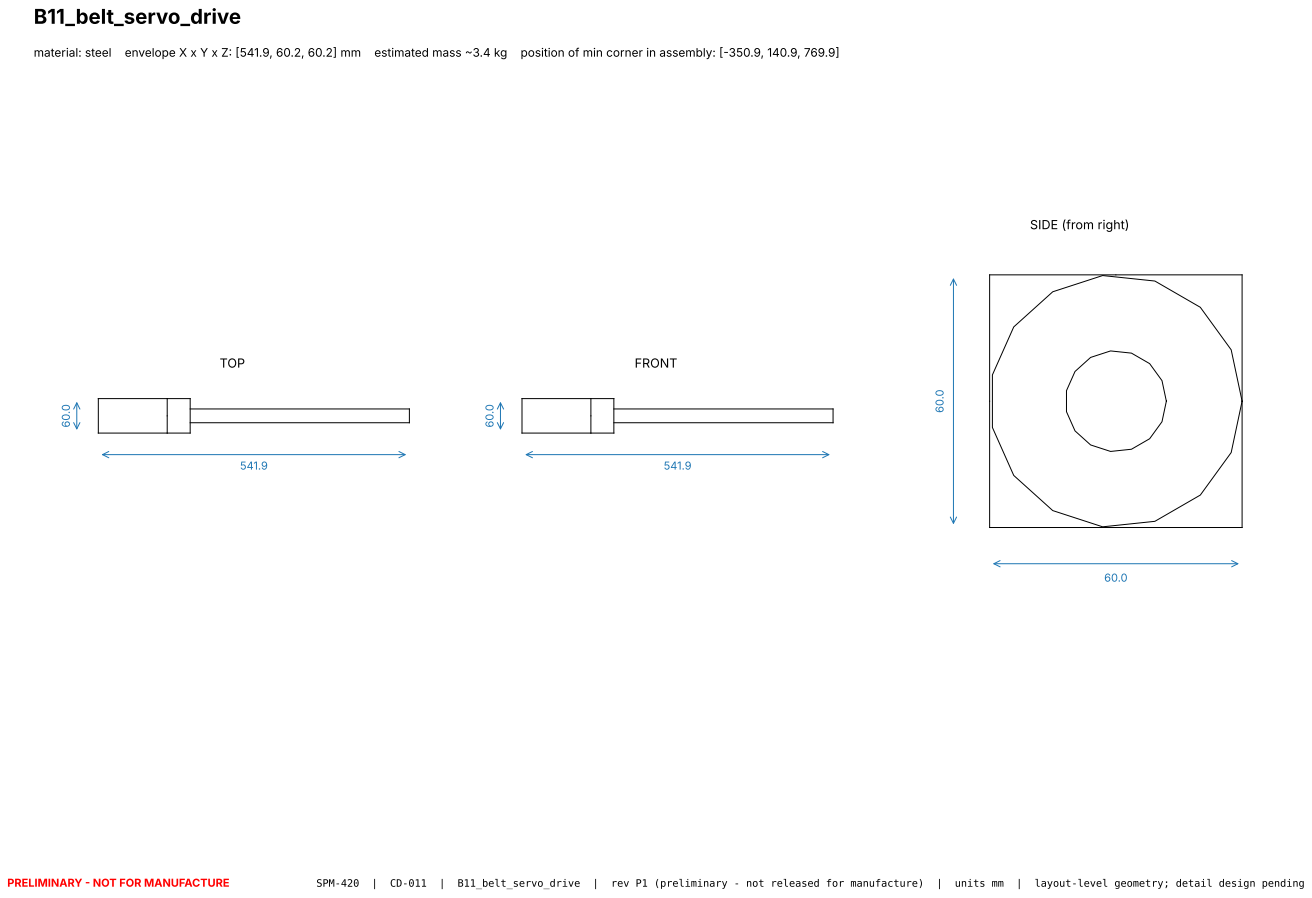
[picture p28: page 11]
TOP; FRONT; PRELIMINARY - NOT FOR MANUFACTURE; SPM-420 | CD-011 | B11_belt_servo_drive | rev P1 (preliminary - not released for manufacture) | units mm | layout-level geometry; detail design pending

material: steel envelope X x Y x Z: [541.9, 60.2, 60.2] mm estimated mass ~3.4 kg position of min corner in assembly: [-350.9, 140.9, 769.9]

SIDE (from right)

## B12_vertical_seal

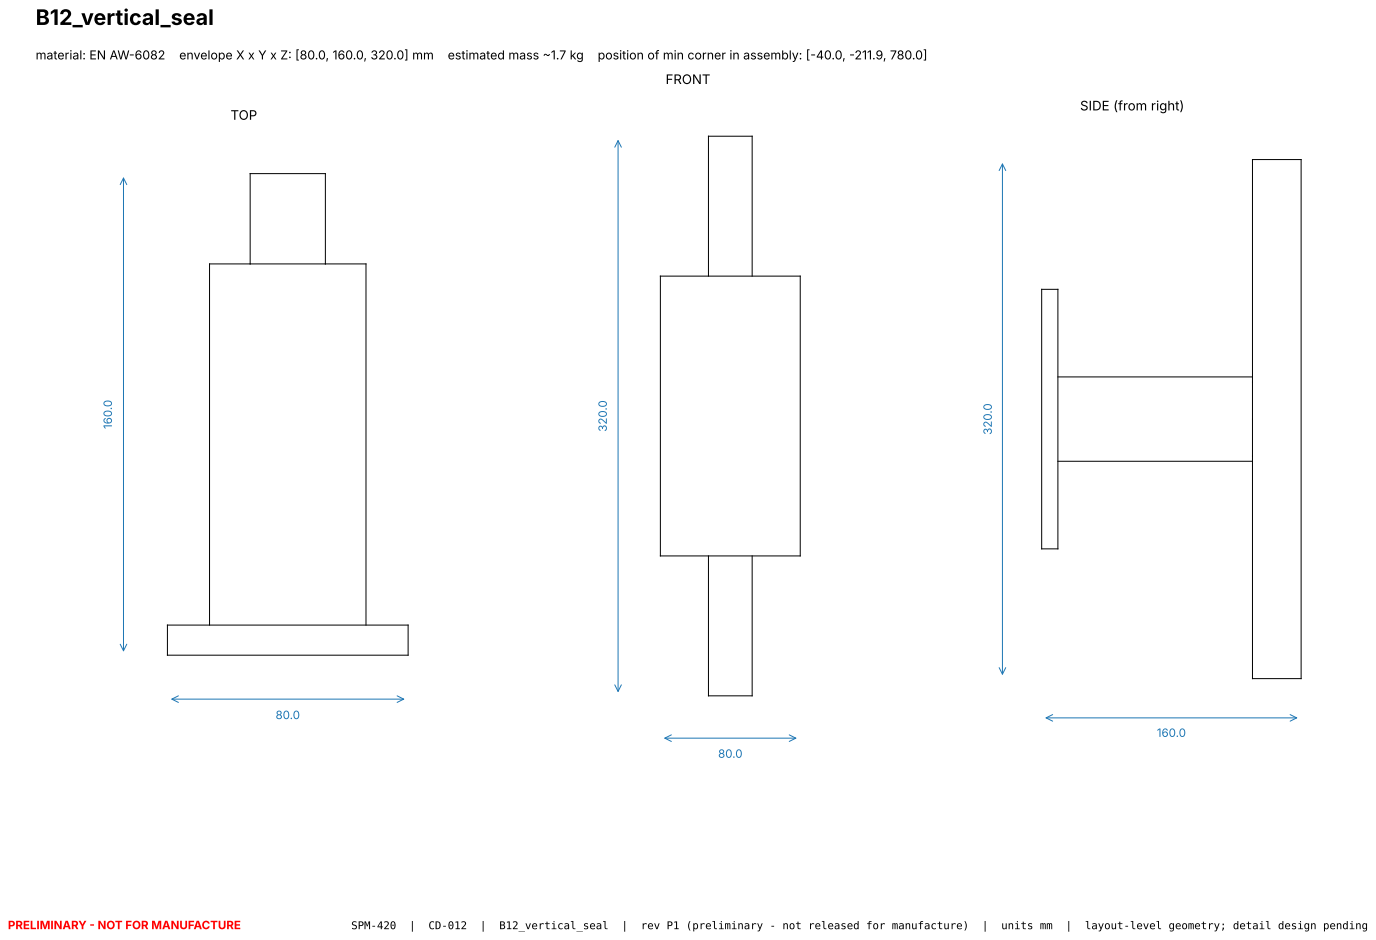
[picture p29: page 12]
TOP; FRONT; PRELIMINARY - NOT FOR MANUFACTURE; SPM-420 | CD-012 | B12_vertical_seal | rev P1 (preliminary - not released for manufacture) | units mm | layout-level geometry; detail design pending

material: EN AW-6082 envelope X x Y x Z: [80.0, 160.0, 320.0] mm estimated mass ~1.7 kg position of min corner in assembly: [-40.0, -211.9, 780.0]

SIDE (from right)

## B13_jaw_assembly

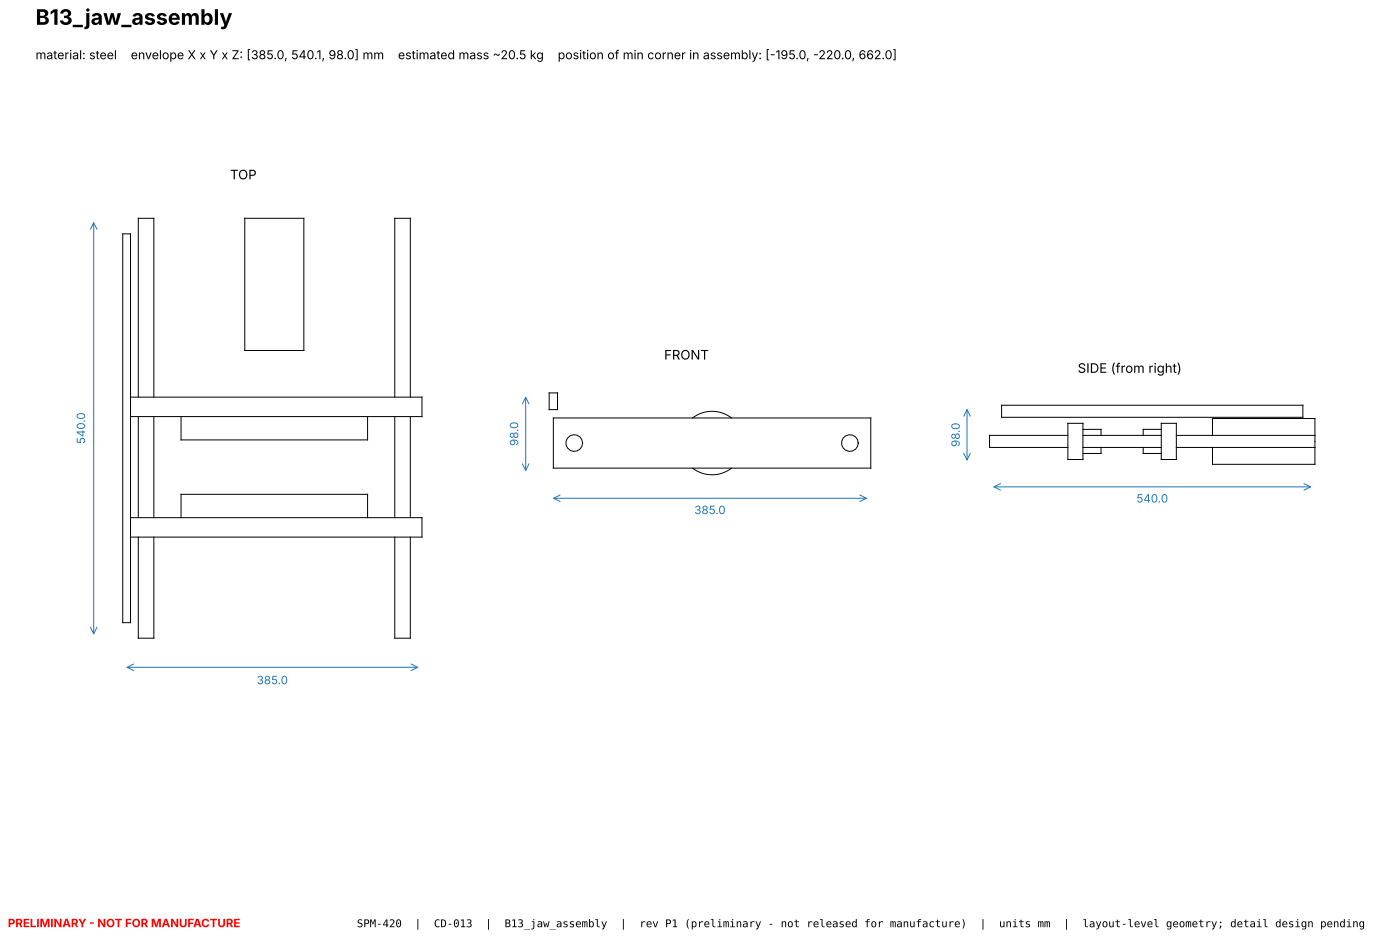
[picture p30: page 13]
TOP; FRONT; PRELIMINARY - NOT FOR MANUFACTURE; SPM-420 | CD-013 | B13_jaw_assembly | rev P1 (preliminary - not released for manufacture) | units mm | layout-level geometry; detail design pending

material: steel envelope X x Y x Z: [385.0, 540.1, 98.0] mm estimated mass ~20.5 kg position of min corner in assembly: [-195.0, -220.0, 662.0]

SIDE (from right)

## B14_guard_doors

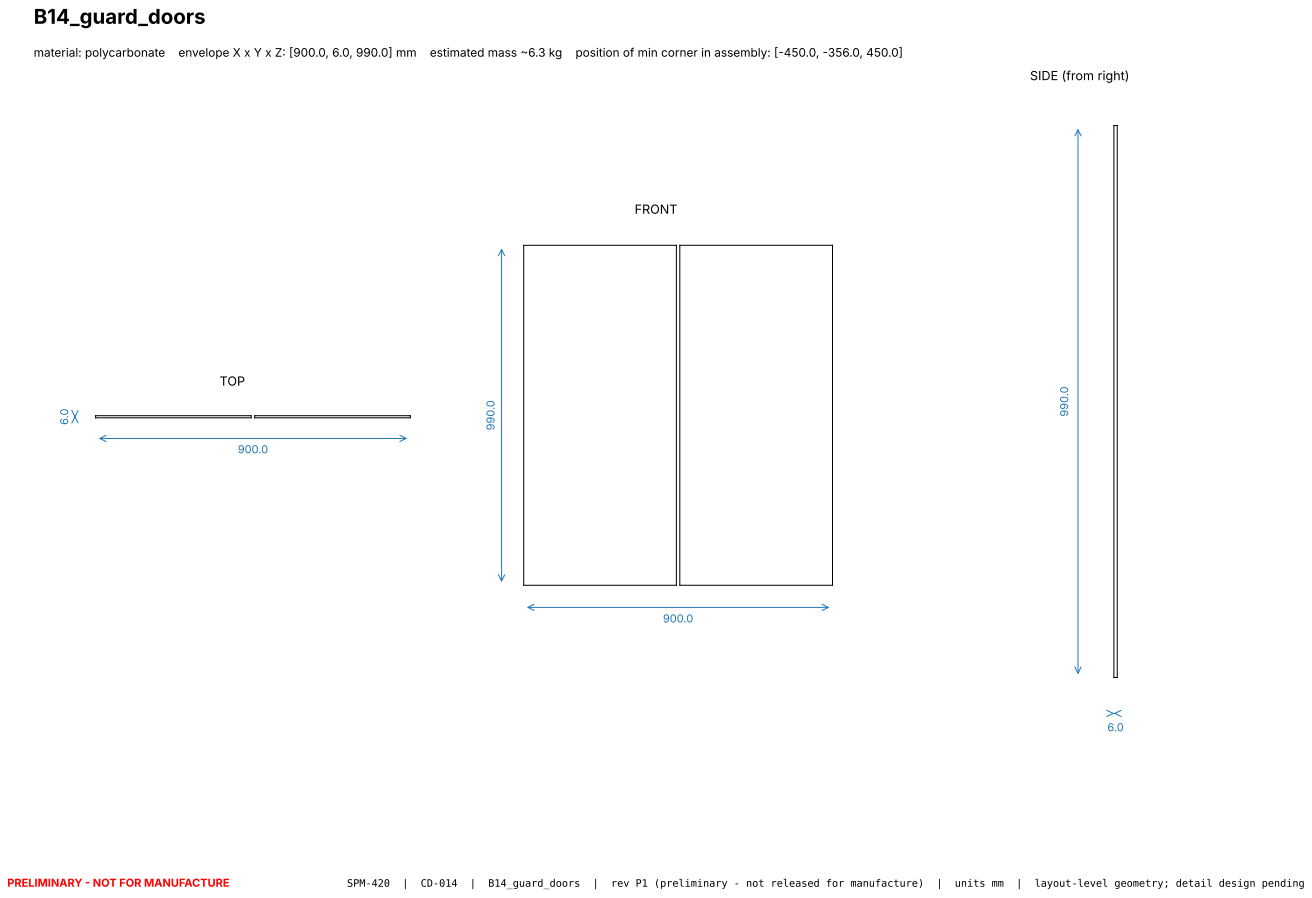
[picture p31: page 14]
TOP; FRONT; PRELIMINARY - NOT FOR MANUFACTURE; SPM-420 | CD-014 | B14_guard_doors | rev P1 (preliminary - not released for manufacture) | units mm | layout-level geometry; detail design pending

material: polycarbonate envelope X x Y x Z: [900.0, 6.0, 990.0] mm estimated mass ~6.3 kg position of min corner in assembly: [-450.0, -356.0, 450.0]

SIDE (from right)

## B15_electrical_cabinet

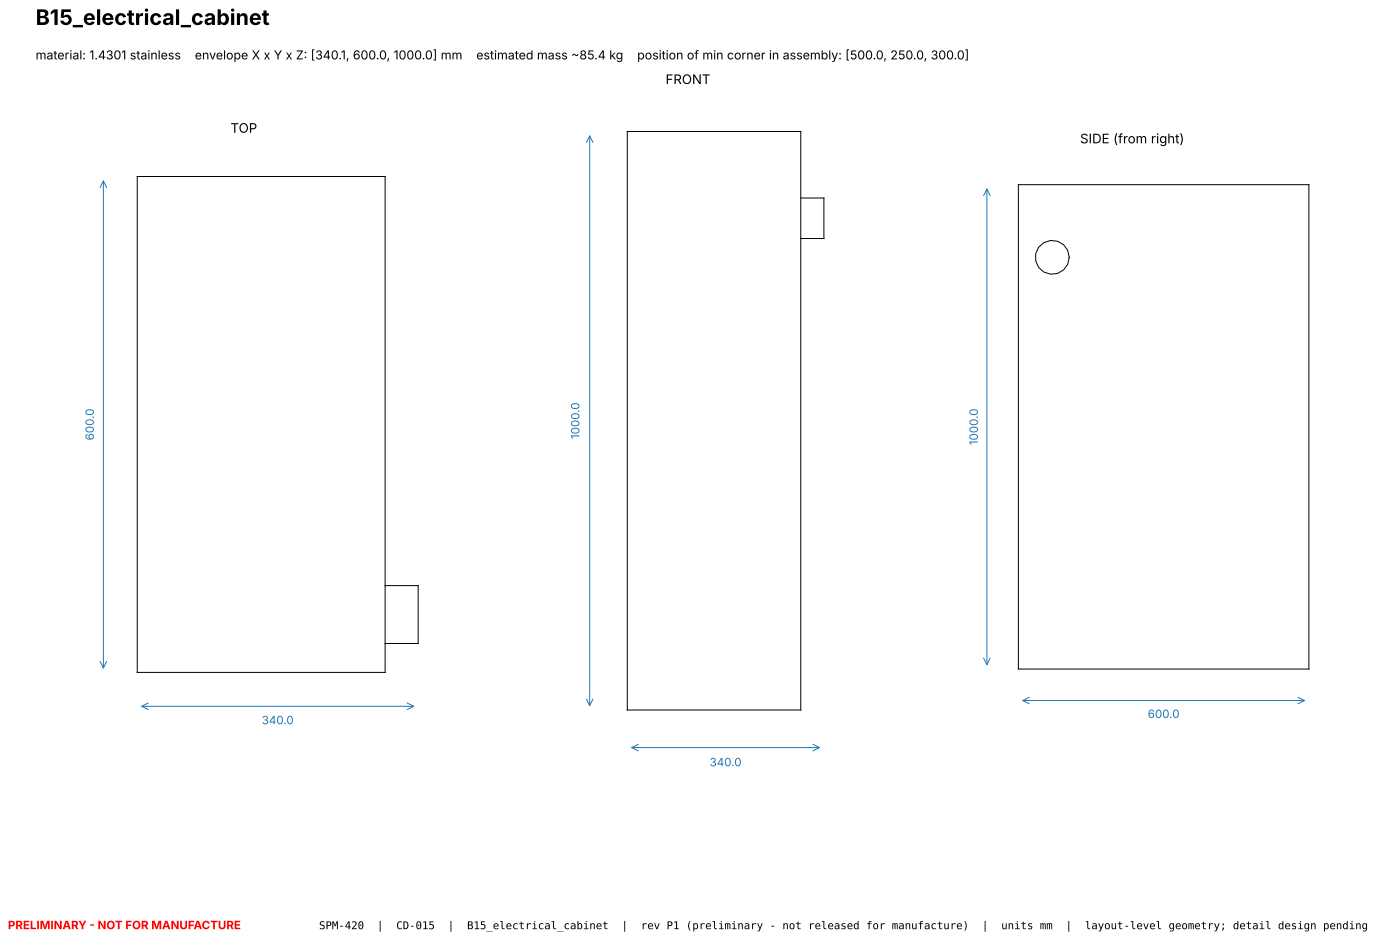
[picture p32: page 15]
TOP; FRONT; PRELIMINARY - NOT FOR MANUFACTURE; SPM-420 | CD-015 | B15_electrical_cabinet | rev P1 (preliminary - not released for manufacture) | units mm | layout-level geometry; detail design pending

material: 1.4301 stainless envelope X x Y x Z: [340.1, 600.0, 1000.0] mm estimated mass ~85.4 kg position of min corner in assembly: [500.0, 250.0, 300.0]

SIDE (from right)

## B16_hmi_station

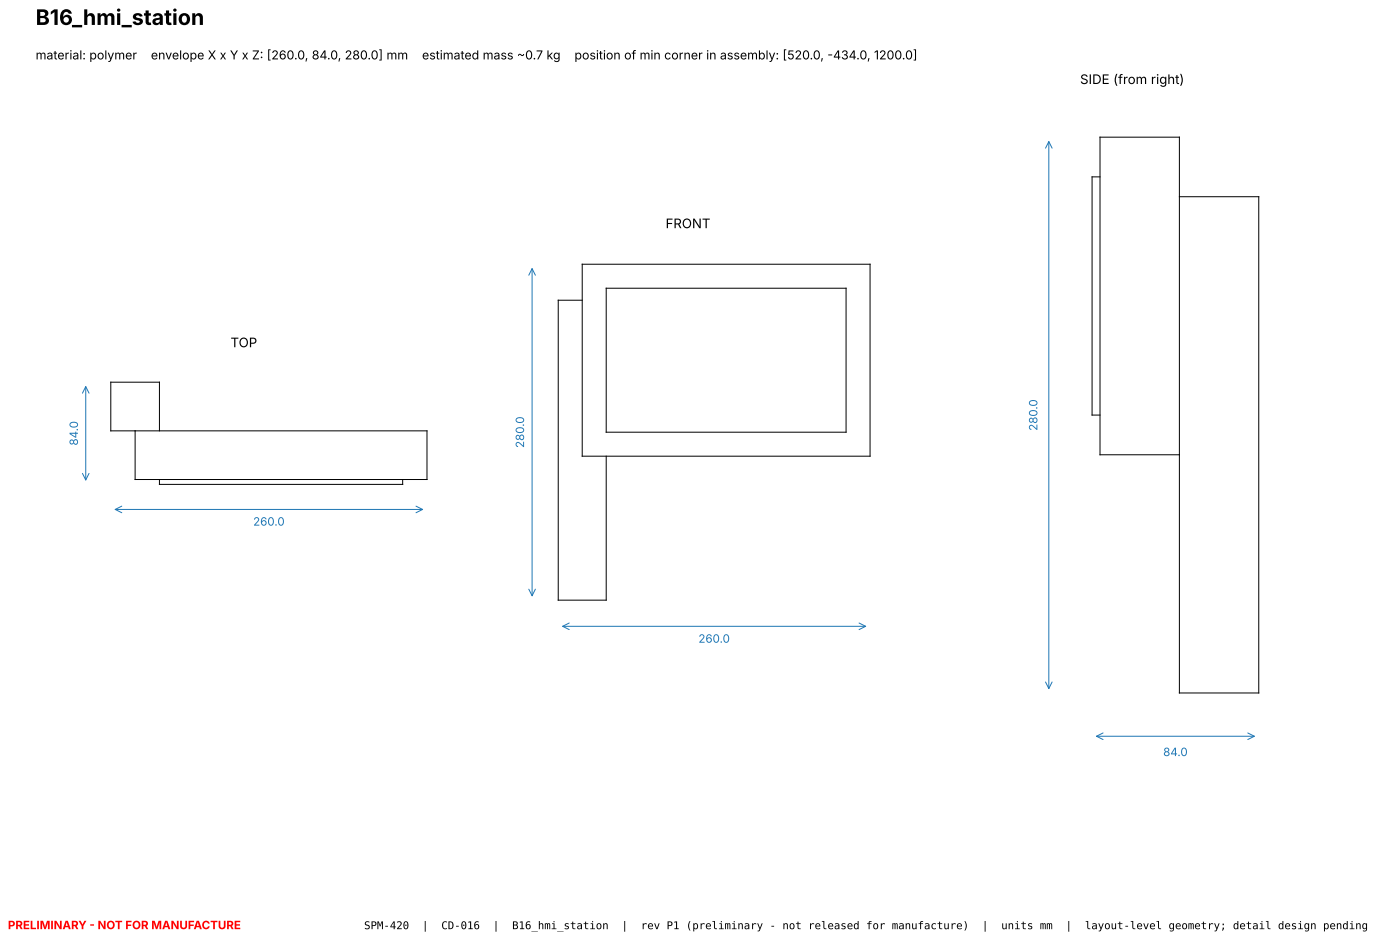
[picture p33: page 16]
TOP; FRONT; PRELIMINARY - NOT FOR MANUFACTURE; SPM-420 | CD-016 | B16_hmi_station | rev P1 (preliminary - not released for manufacture) | units mm | layout-level geometry; detail design pending

material: polymer envelope X x Y x Z: [260.0, 84.0, 280.0] mm estimated mass ~0.7 kg position of min corner in assembly: [520.0, -434.0, 1200.0]

SIDE (from right)

## B17_film_web

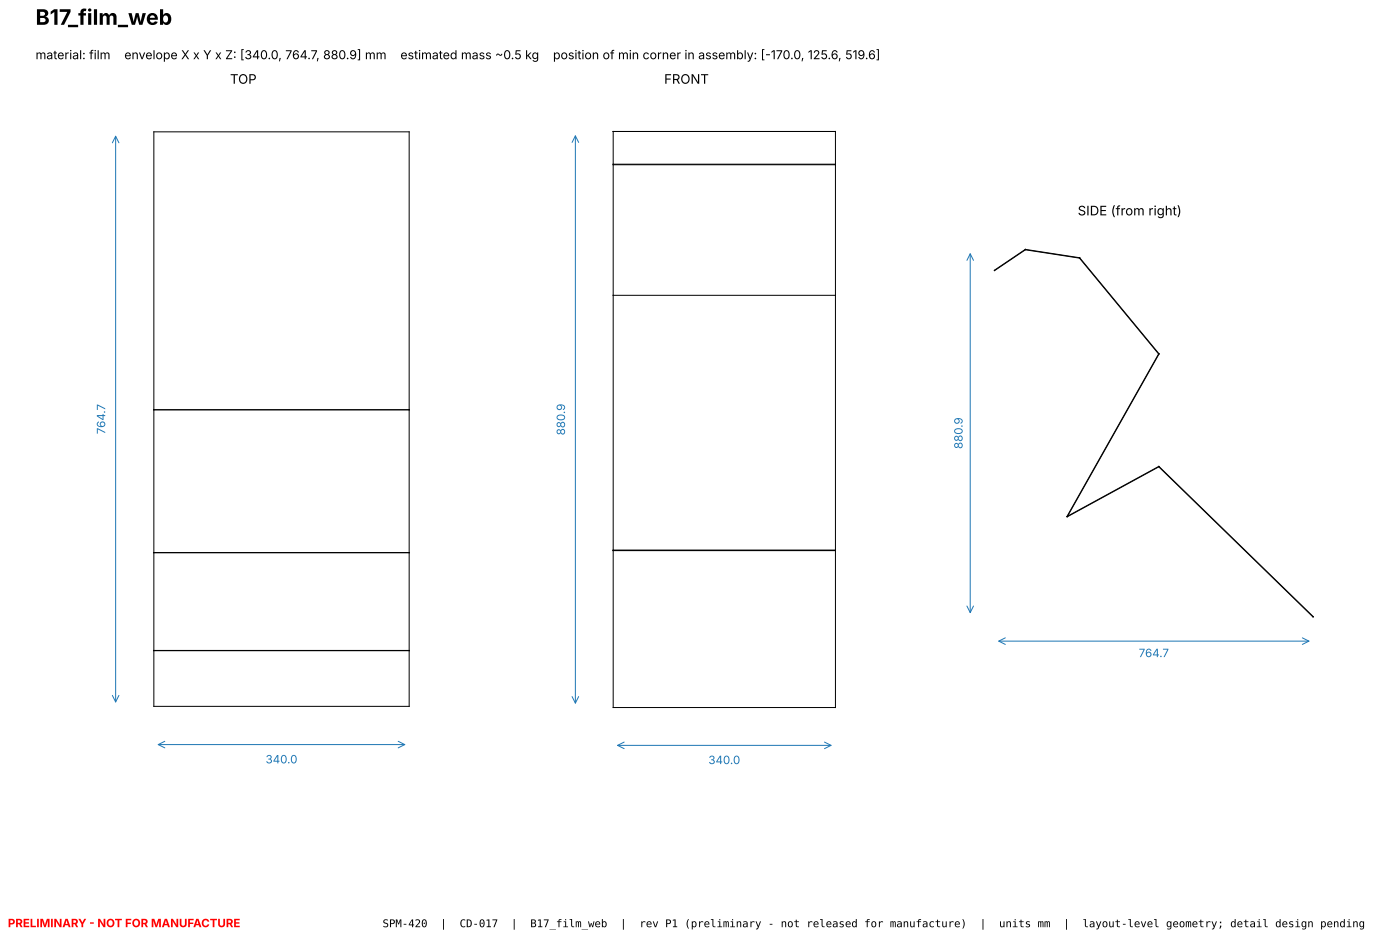
[picture p34: page 17]
TOP; FRONT; PRELIMINARY - NOT FOR MANUFACTURE; SPM-420 | CD-017 | B17_film_web | rev P1 (preliminary - not released for manufacture) | units mm | layout-level geometry; detail design pending

material: film envelope X x Y x Z: [340.0, 764.7, 880.9] mm estimated mass ~0.5 kg position of min corner in assembly: [-170.0, 125.6, 519.6]

SIDE (from right)

## C01_takeoff_conveyor

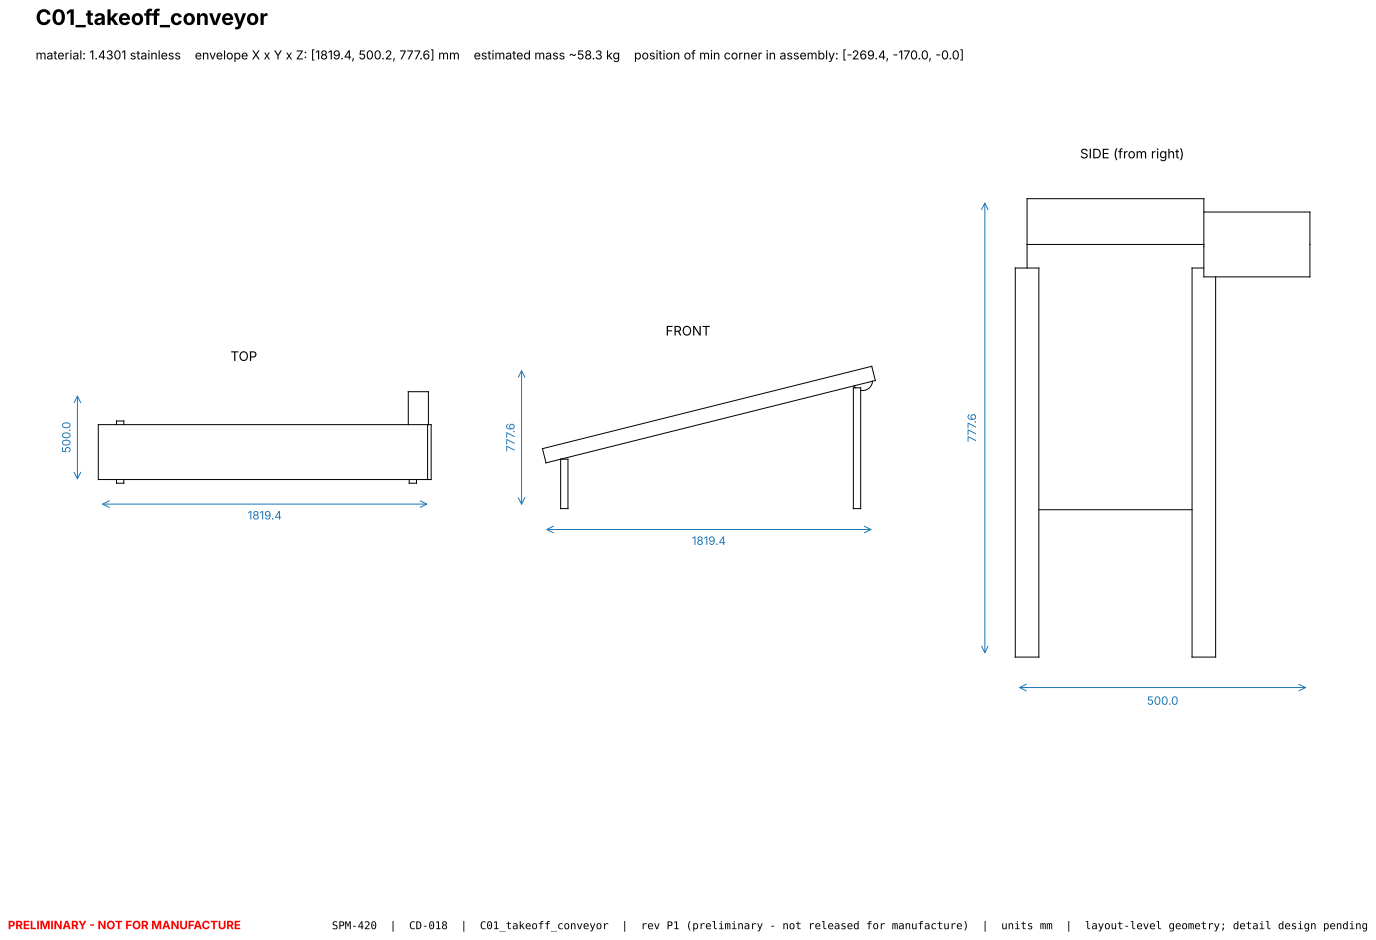
[picture p35: page 18]
TOP; FRONT; PRELIMINARY - NOT FOR MANUFACTURE; SPM-420 | CD-018 | C01_takeoff_conveyor | rev P1 (preliminary - not released for manufacture) | units mm | layout-level geometry; detail design pending

material: 1.4301 stainless envelope X x Y x Z: [1819.4, 500.2, 777.6] mm estimated mass ~58.3 kg position of min corner in assembly: [-269.4, -170.0, -0.0]

SIDE (from right)

## P01_weigher_platform

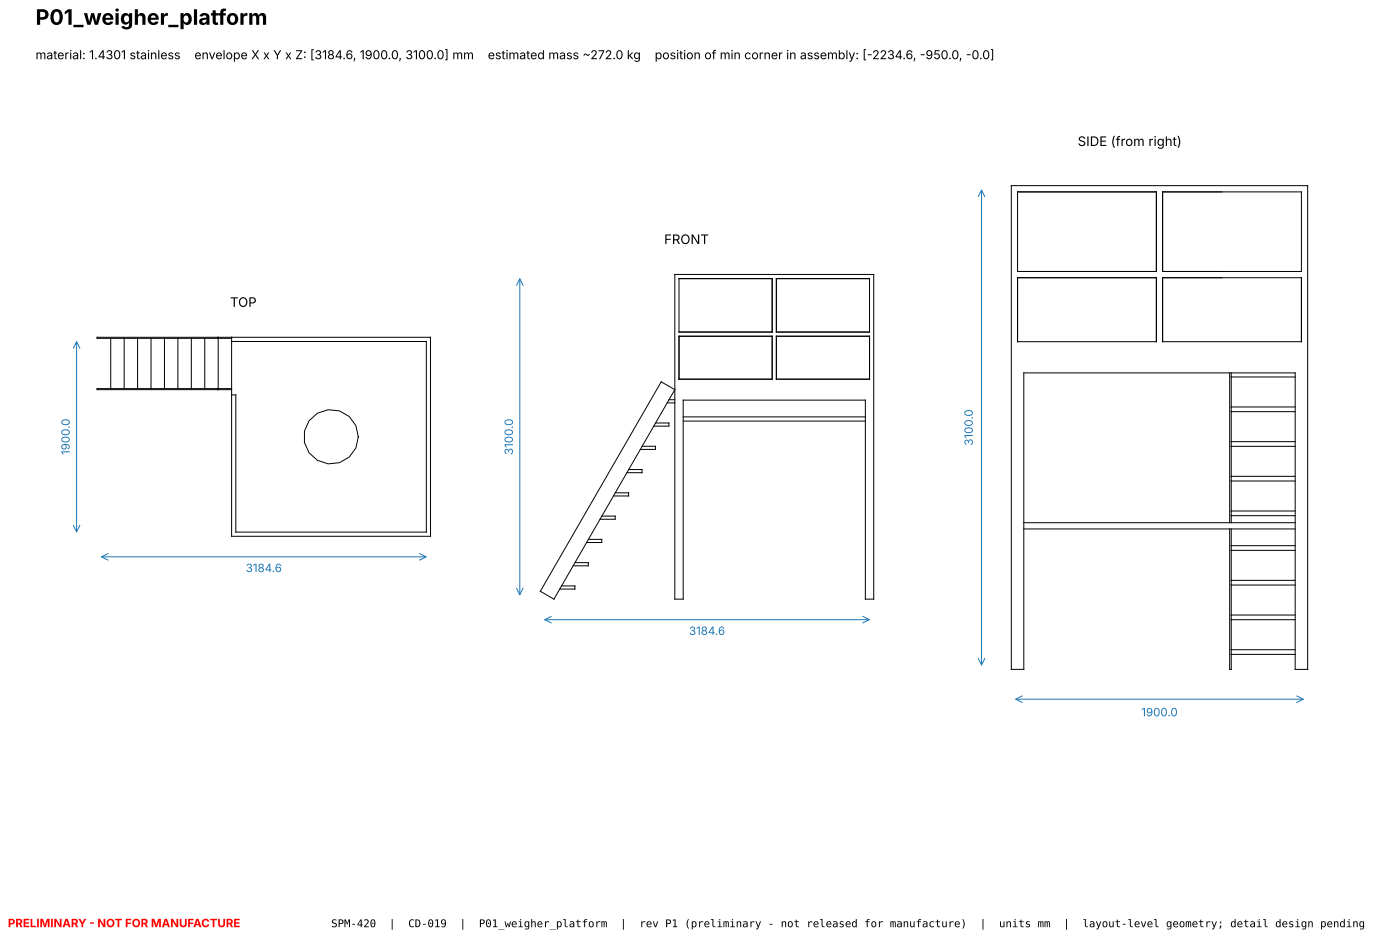
[picture p36: page 19]
TOP; FRONT; PRELIMINARY - NOT FOR MANUFACTURE; SPM-420 | CD-019 | P01_weigher_platform | rev P1 (preliminary - not released for manufacture) | units mm | layout-level geometry; detail design pending

material: 1.4301 stainless envelope X x Y x Z: [3184.6, 1900.0, 3100.0] mm estimated mass ~272.0 kg position of min corner in assembly: [-2234.6, -950.0, -0.0]

SIDE (from right)

## W01_multihead_weigher

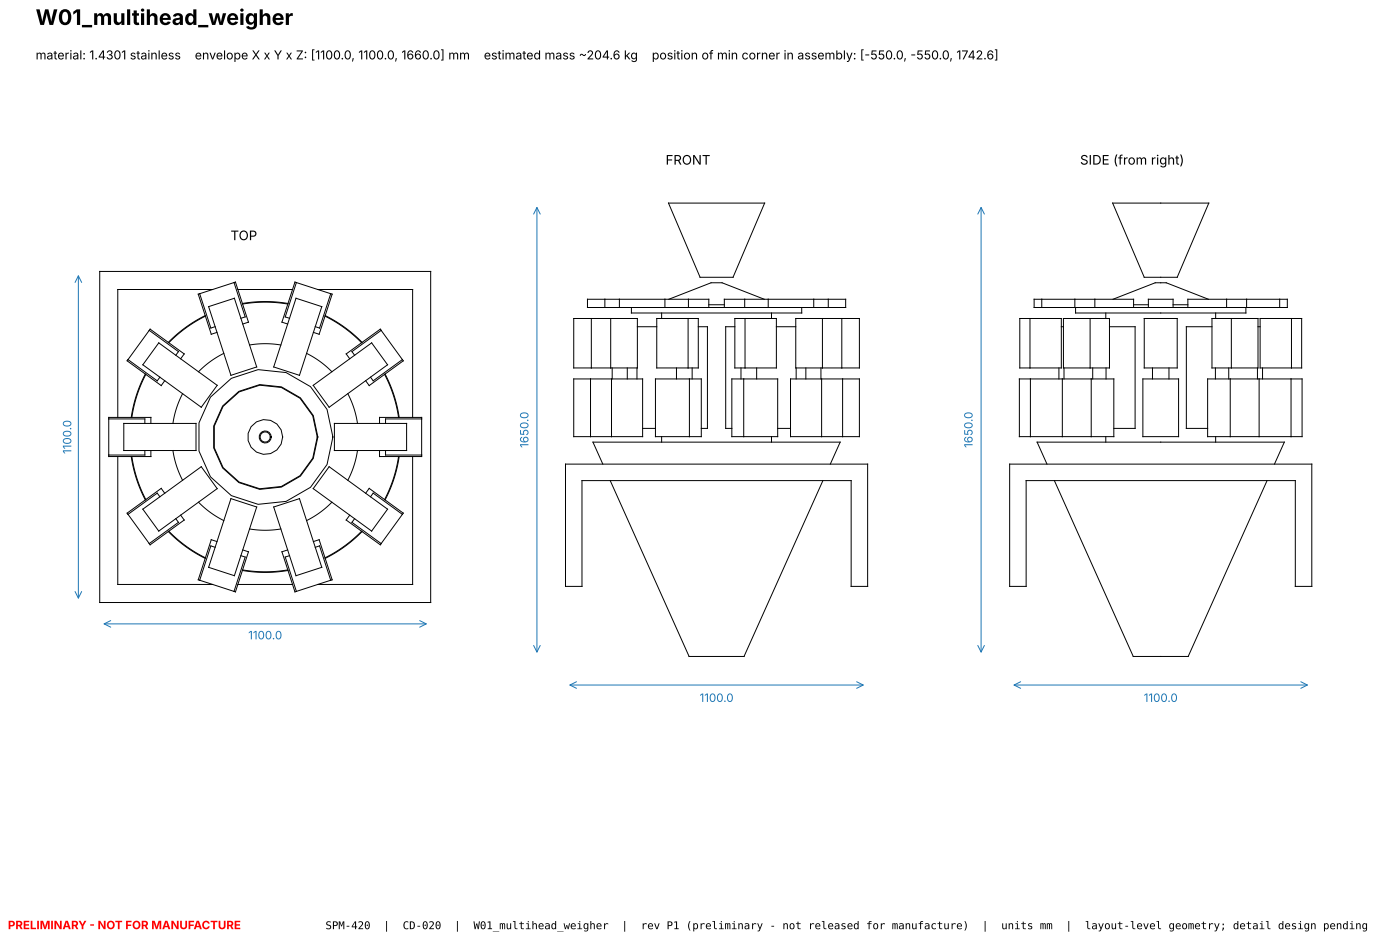
[picture p37: page 20]
TOP; FRONT; PRELIMINARY - NOT FOR MANUFACTURE; SPM-420 | CD-020 | W01_multihead_weigher | rev P1 (preliminary - not released for manufacture) | units mm | layout-level geometry; detail design pending

material: 1.4301 stainless envelope X x Y x Z: [1100.0, 1100.0, 1660.0] mm estimated mass ~204.6 kg position of min corner in assembly: [-550.0, -550.0, 1742.6]

SIDE (from right)

## E01_z_bucket_elevator

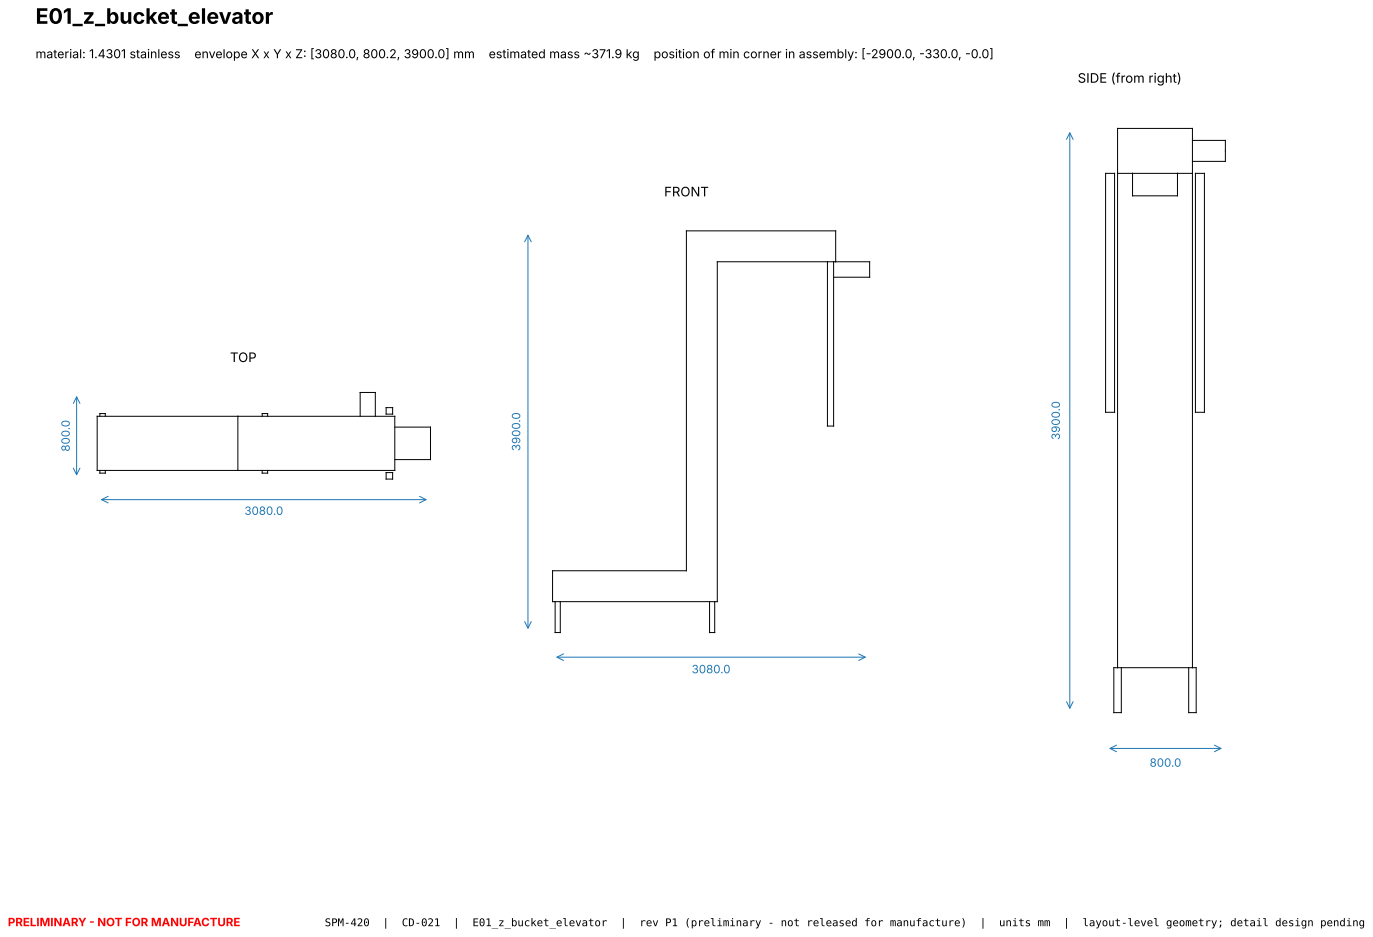
[picture p38: page 21]
TOP; FRONT; PRELIMINARY - NOT FOR MANUFACTURE; SPM-420 | CD-021 | E01_z_bucket_elevator | rev P1 (preliminary - not released for manufacture) | units mm | layout-level geometry; detail design pending

material: 1.4301 stainless envelope X x Y x Z: [3080.0, 800.2, 3900.0] mm estimated mass ~371.9 kg position of min corner in assembly: [-2900.0, -330.0, -0.0]

SIDE (from right)

## E02_infeed_hopper

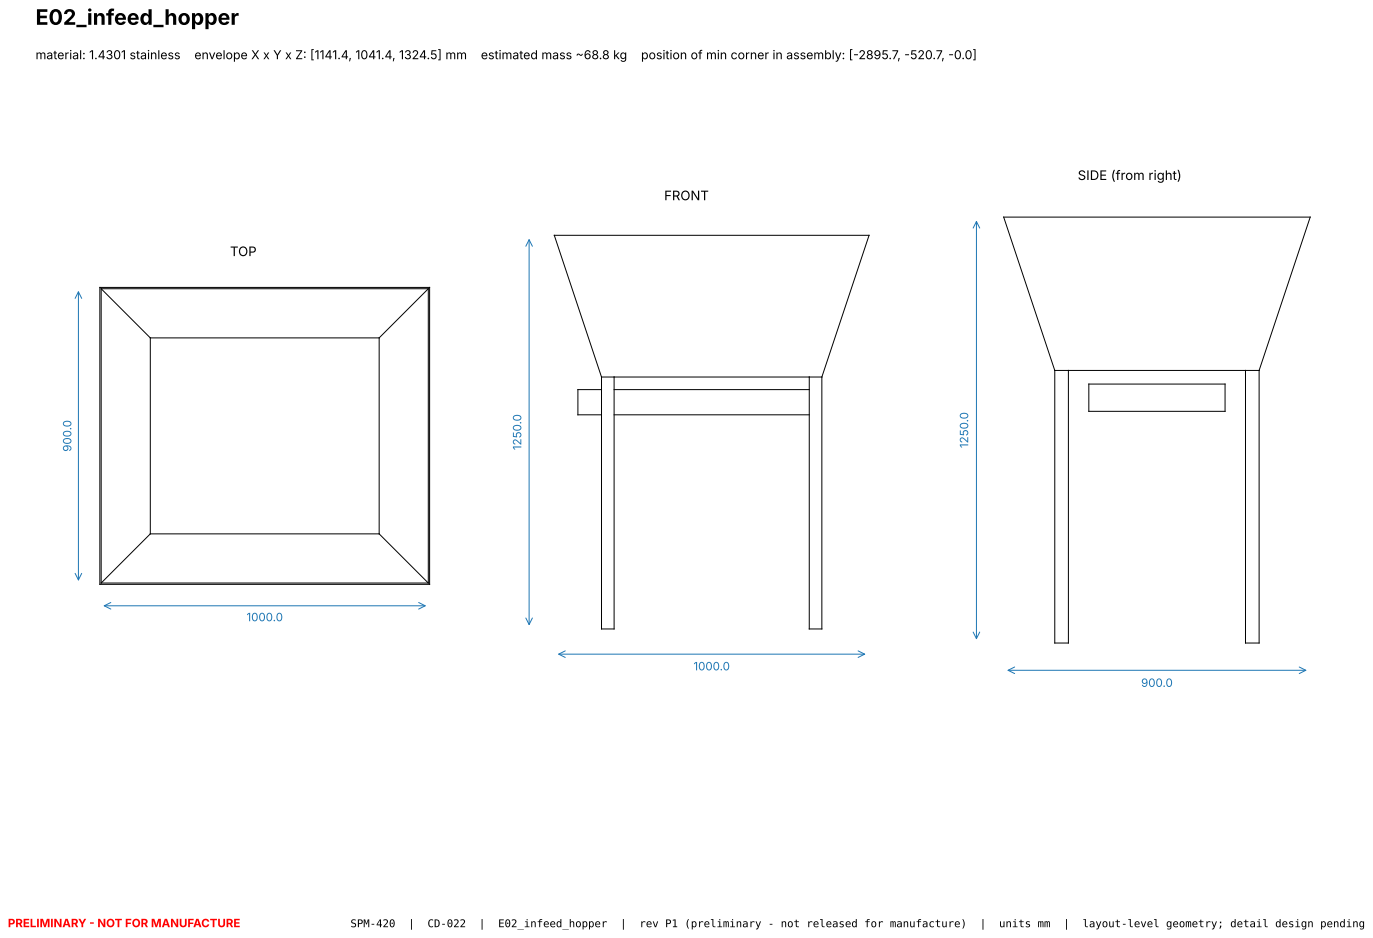
[picture p39: page 22]
TOP; FRONT; PRELIMINARY - NOT FOR MANUFACTURE; SPM-420 | CD-022 | E02_infeed_hopper | rev P1 (preliminary - not released for manufacture) | units mm | layout-level geometry; detail design pending

material: 1.4301 stainless envelope X x Y x Z: [1141.4, 1041.4, 1324.5] mm estimated mass ~68.8 kg position of min corner in assembly: [-2895.7, -520.7, -0.0]

SIDE (from right)
