qaessafty-arch/Plc/CAD/ASSEMBLY/SPM-420_assembly.step

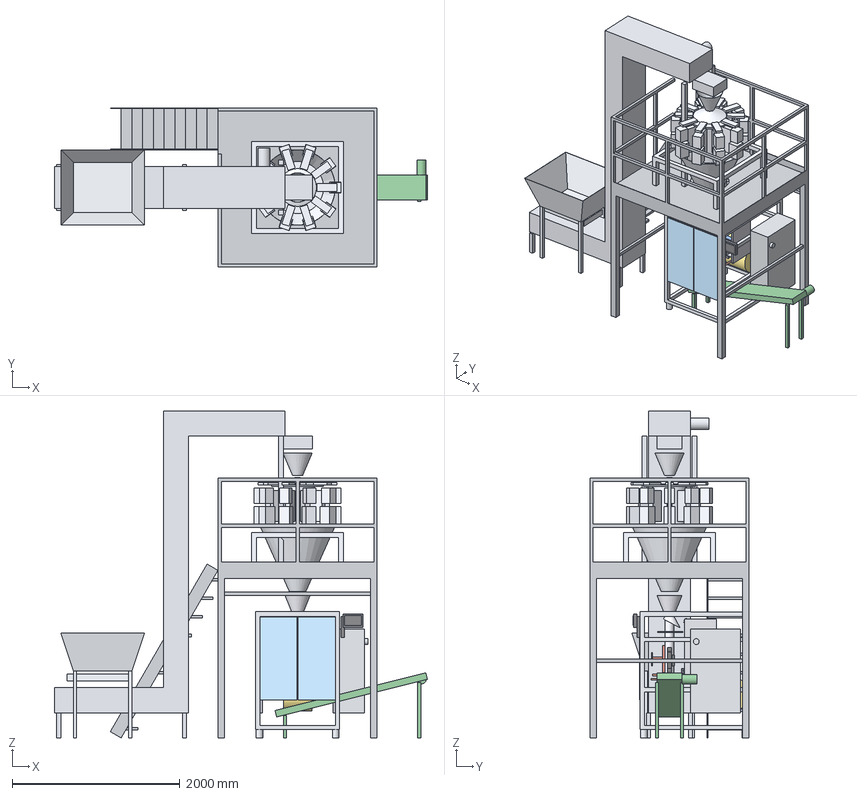
[picture p40: CAD file, 2026-11-11]
CAD/ASSEMBLY/SPM-420_assembly.step
4450.0 x 1900.0 x 3900.0 mm
B01_main_frame
B02_film_roll
B03_unwind_shaft
B04_guide_rollers
B05_dancer_arm
B06_forming_tube
B07_forming_collar
B08_infeed_funnel
B09_pull_belt_left
B10_pull_belt_right
B11_belt_servo_drive
B12_vertical_seal
B13_jaw_assembly
B14_guard_doors
B15_electrical_cabinet
B16_hmi_station
B17_film_web
C01_takeoff_conveyor
P01_weigher_platform
W01_multihead_weigher
E01_z_bucket_elevator
E02_infeed_hopper
