qaessafty-arch/Plc/CAD/DRAWINGS/components/B01_main_frame.dxf

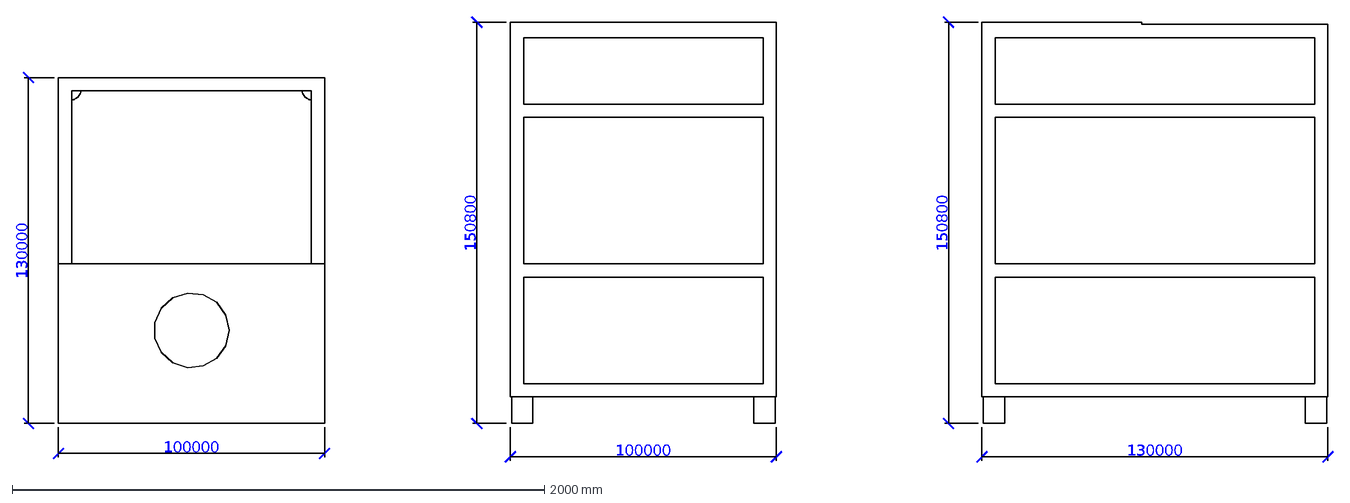
[picture p41: CAD file, 2026-11-11]
CAD/DRAWINGS/components/B01_main_frame.dxf
100000
130000
150800
