qaessafty-arch/Plc/CAD/COMPONENTS/B13_jaw_assembly.step

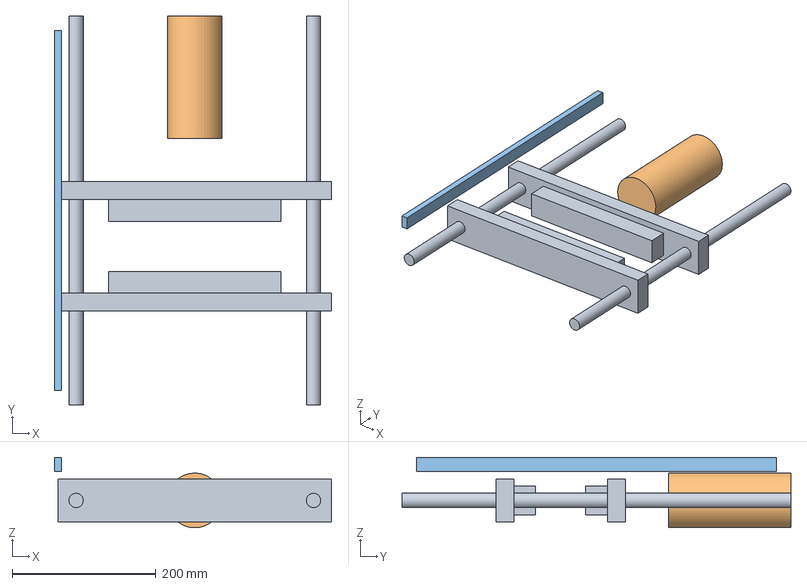
[picture p42: CAD file, 2026-11-11]
CAD/COMPONENTS/B13_jaw_assembly.step
385.0 x 540.0 x 98.0 mm
