qaessafty-arch/Plc/CAD/COMPONENTS/B01_main_frame.step

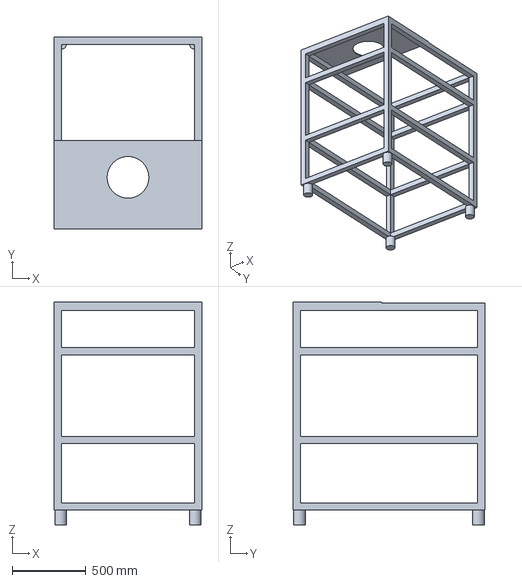
[picture p43: CAD file, 2026-11-11]
CAD/COMPONENTS/B01_main_frame.step
1000.0 x 1300.0 x 1508.0 mm
