qaessafty-arch/Plc/CAD/DRAWINGS/components/B13_jaw_assembly.dxf

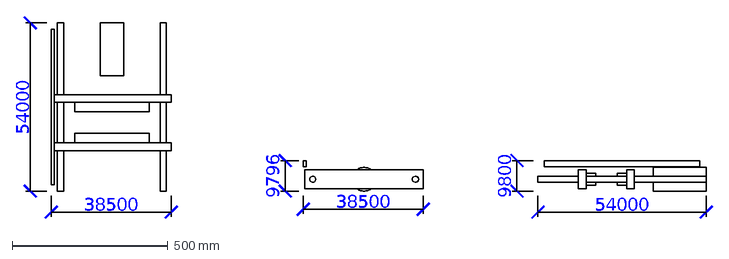
[picture p44: CAD file, 2026-11-11]
CAD/DRAWINGS/components/B13_jaw_assembly.dxf
38500
54000
9796
9800
