qaessafty-arch/Plc/CAD/COMPONENTS/B12_vertical_seal.step

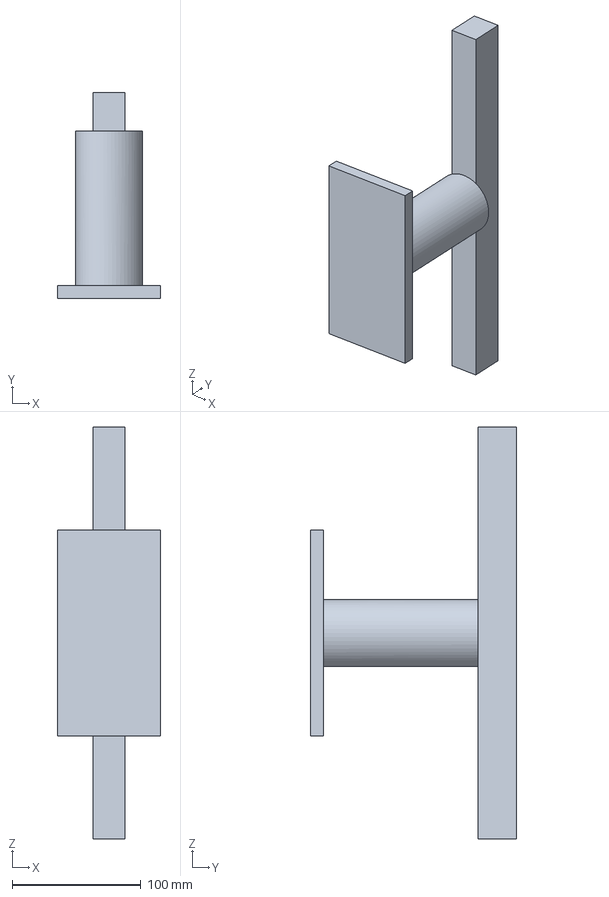
[picture p45: CAD file, 2026-11-11]
CAD/COMPONENTS/B12_vertical_seal.step
80.0 x 160.0 x 320.0 mm
