qaessafty-arch/Plc/CAD/DRAWINGS/components/B04_guide_rollers.dxf

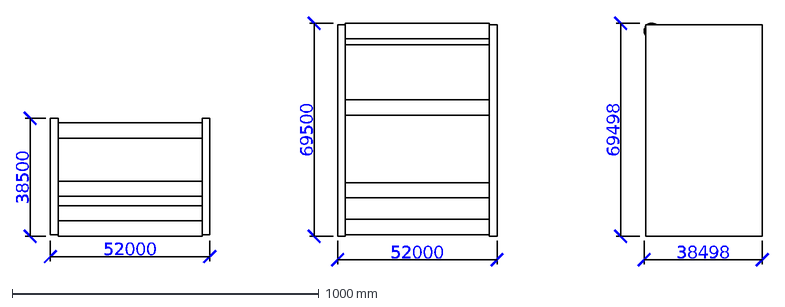
[picture p46: CAD file, 2026-11-11]
CAD/DRAWINGS/components/B04_guide_rollers.dxf
52000
38500
69500
38498
69498
