qaessafty-arch/Plc/CAD/DRAWINGS/GA-001_general_arrangement.dxf

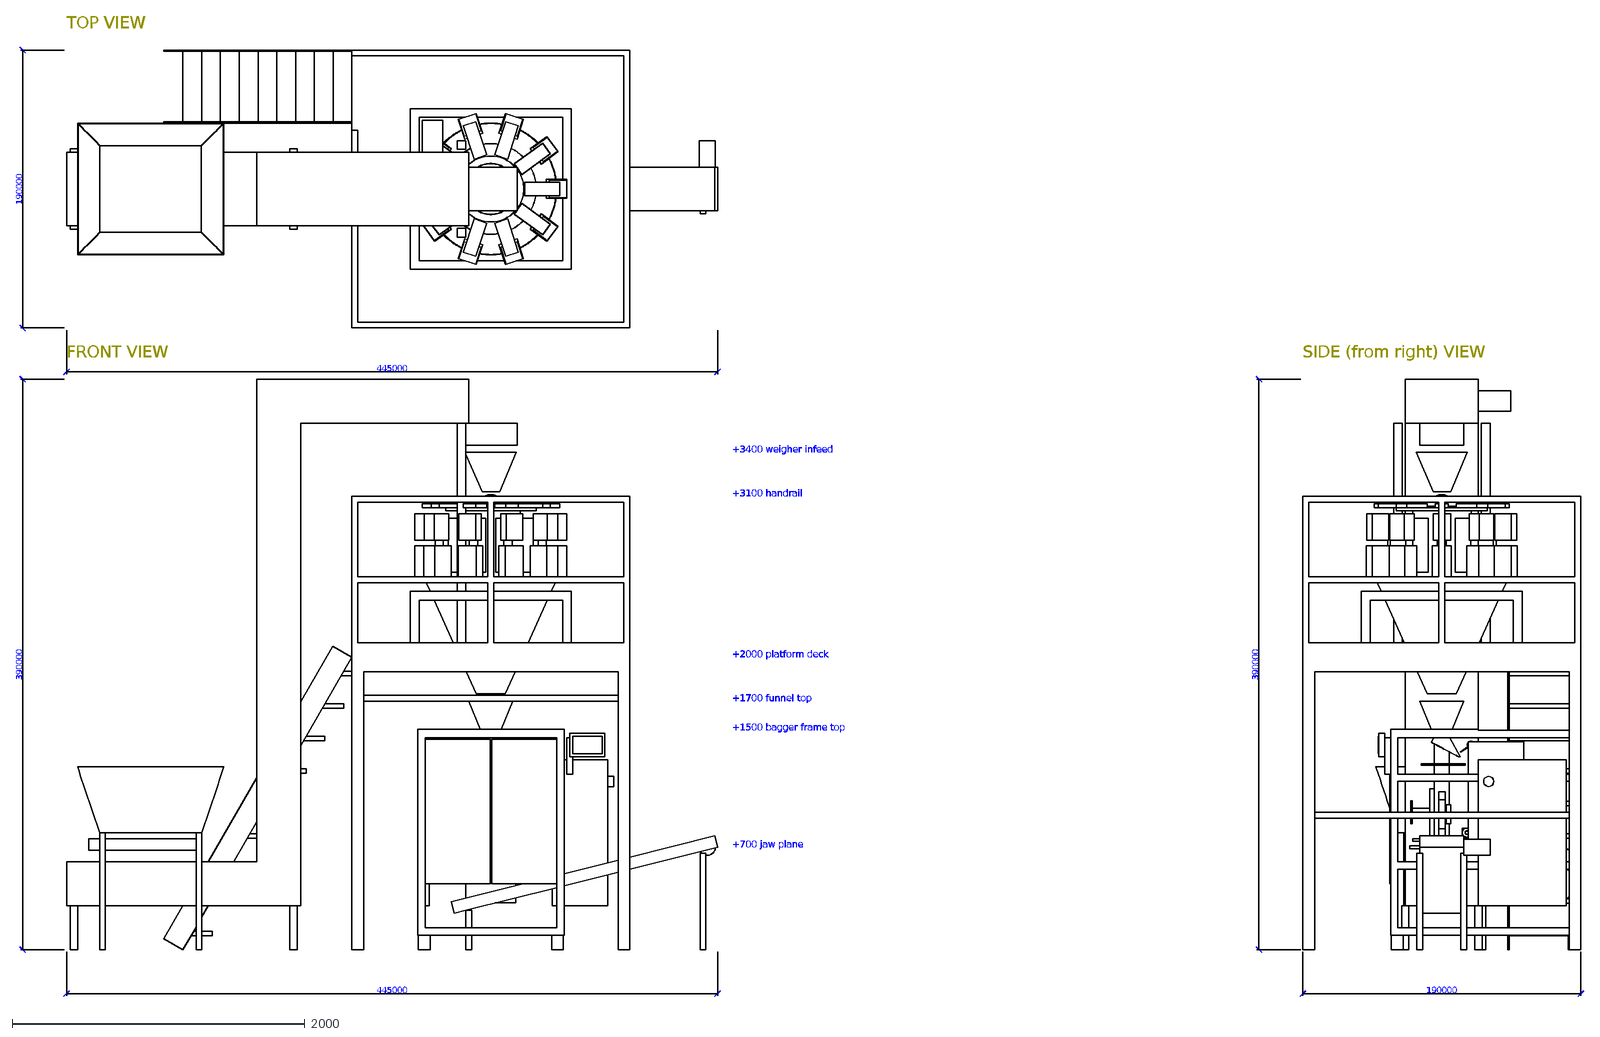
[picture p47: CAD file, 2026-11-11]
CAD/DRAWINGS/GA-001_general_arrangement.dxf
445000
190000
TOP VIEW
390000
FRONT VIEW
+700 jaw plane
+1500 bagger frame top
+1700 funnel top
+2000 platform deck
+3100 handrail
+3400 weigher infeed
SIDE (from right) VIEW
