qaessafty-arch/Plc/CAD/COMPONENTS/B04_guide_rollers.step

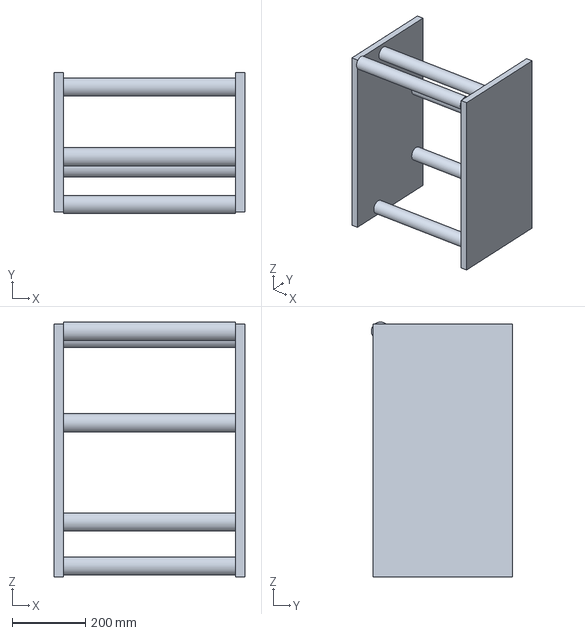
[picture p49: CAD file, 2026-11-11]
CAD/COMPONENTS/B04_guide_rollers.step
520.0 x 385.0 x 695.0 mm
