qaessafty-arch/Plc/CAD/DRAWINGS/components/B12_vertical_seal.dxf

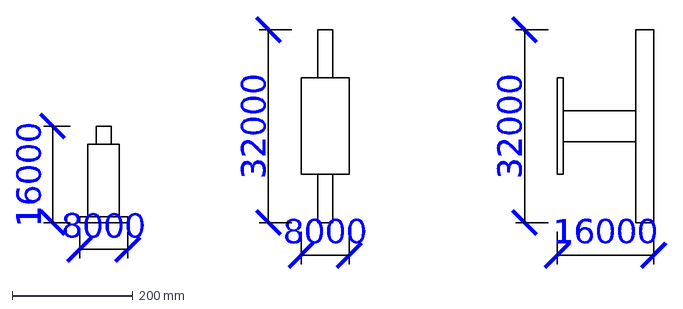
[picture p50: CAD file, 2026-11-11]
CAD/DRAWINGS/components/B12_vertical_seal.dxf
8000
16000
32000
