qaessafty-arch/Plc/CAD/DRAWINGS/GA-002_floor_layout.dxf

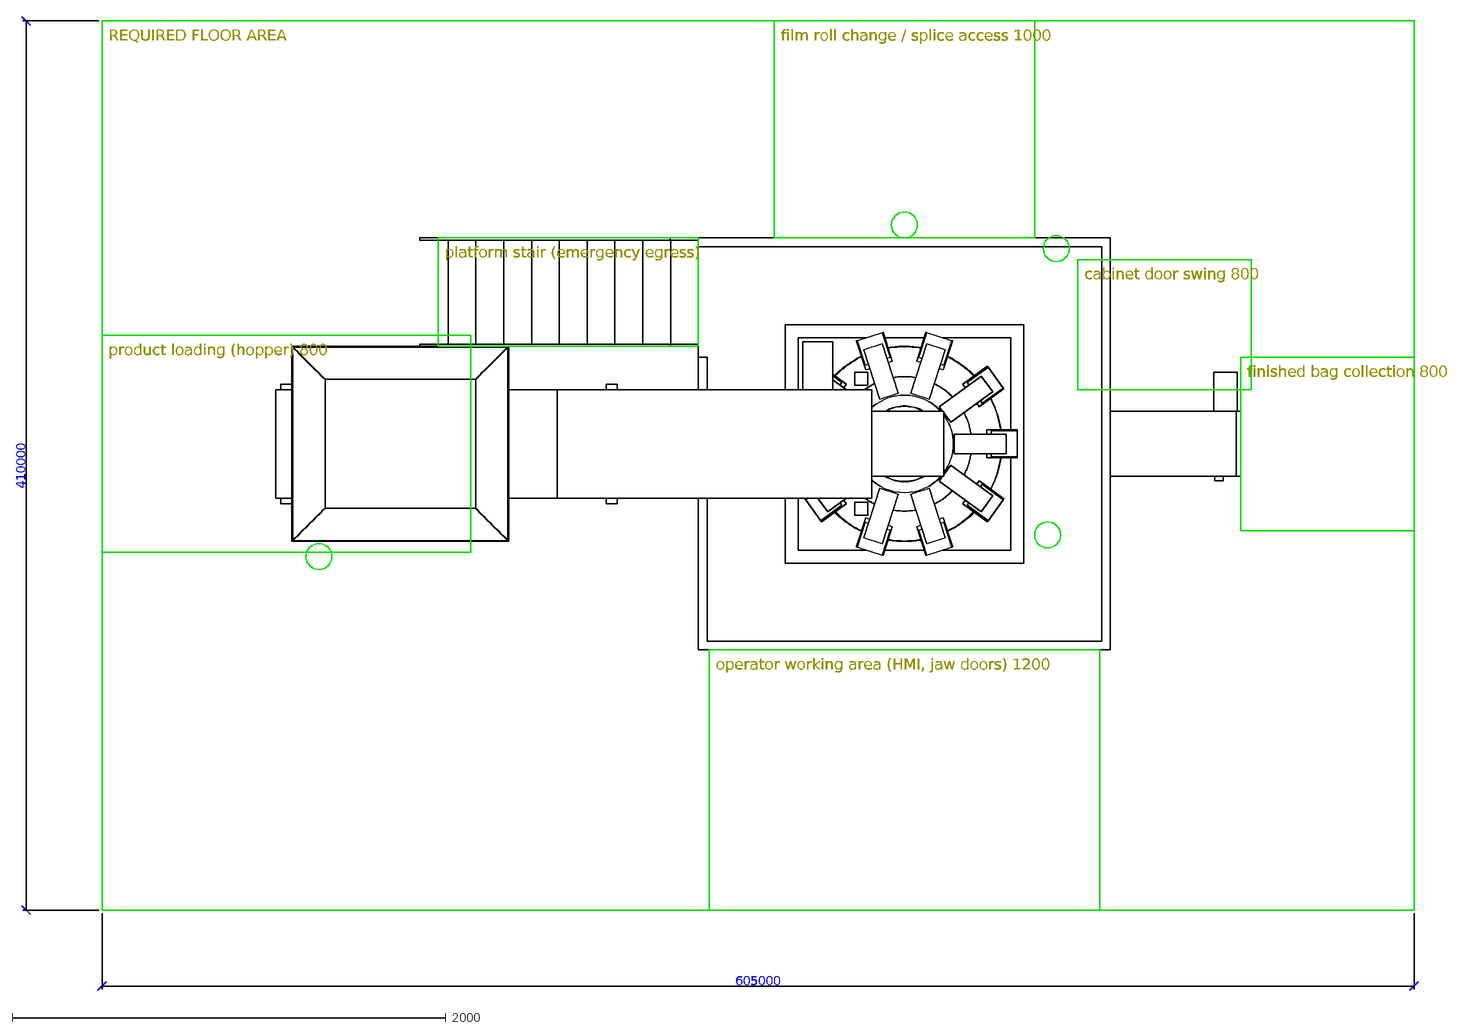
[picture p51: CAD file, 2026-11-11]
CAD/DRAWINGS/GA-002_floor_layout.dxf
REQUIRED FLOOR AREA
operator working area (HMI, jaw doors) 1200
film roll change / splice access 1000
product loading (hopper) 800
finished bag collection 800
cabinet door swing 800
platform stair (emergency egress)
605000
410000
