qaessafty-arch/Plc/CAD/COMPONENTS/C01_takeoff_conveyor.step

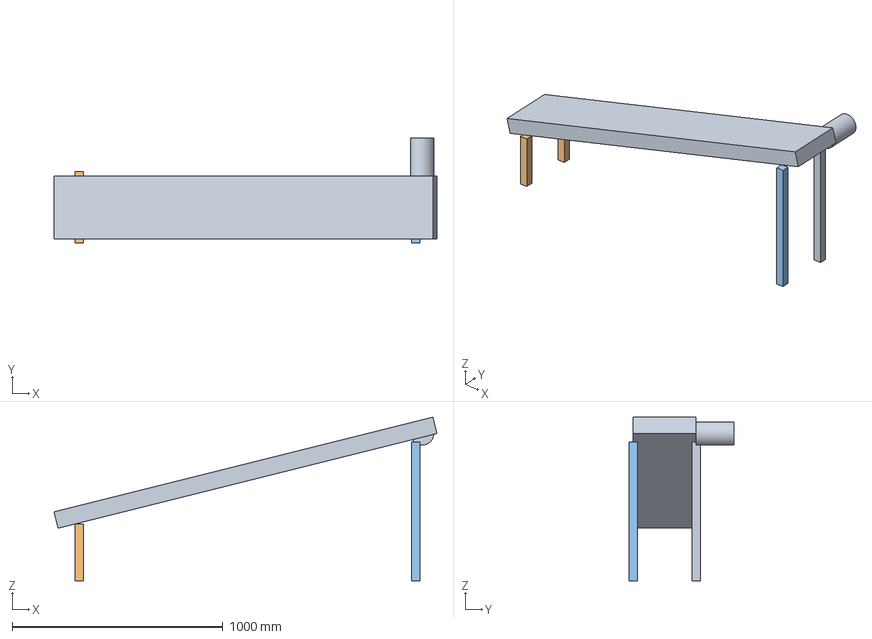
[picture p52: CAD file, 2026-11-11]
CAD/COMPONENTS/C01_takeoff_conveyor.step
1819.4 x 500.0 x 777.6 mm
