qaessafty-arch/Plc/CAD/DRAWINGS/components/B11_belt_servo_drive.dxf

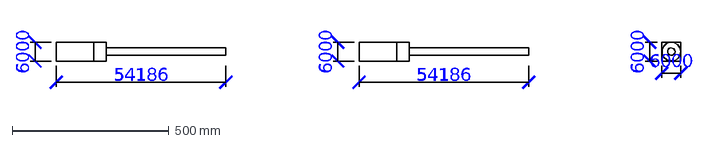
[picture p53: CAD file, 2026-11-11]
CAD/DRAWINGS/components/B11_belt_servo_drive.dxf
54186
6000
