qaessafty-arch/Plc/CAD/COMPONENTS/B03_unwind_shaft.step

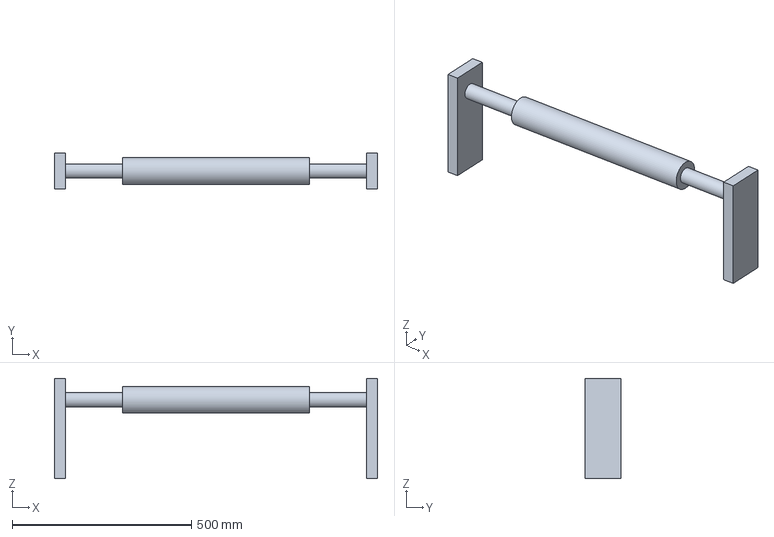
[picture p54: CAD file, 2026-11-11]
CAD/COMPONENTS/B03_unwind_shaft.step
900.0 x 100.0 x 280.0 mm
