qaessafty-arch/Plc/CAD/DRAWINGS/components/C01_takeoff_conveyor.dxf

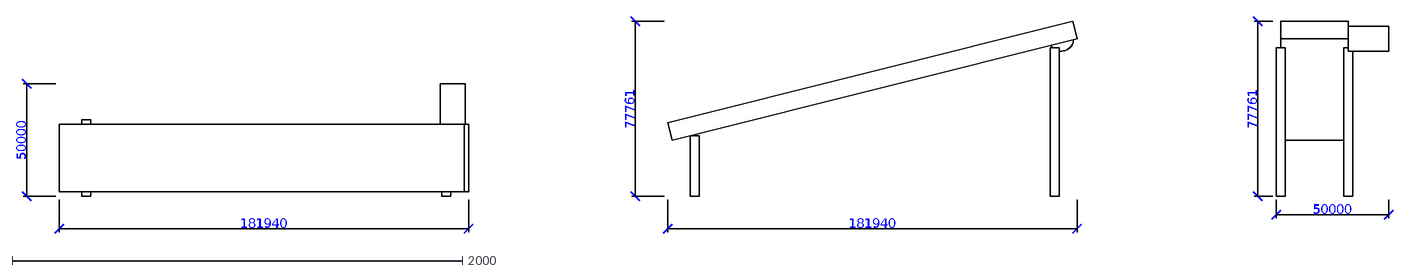
[picture p55: CAD file, 2026-11-11]
CAD/DRAWINGS/components/C01_takeoff_conveyor.dxf
181940
50000
77761
