qaessafty-arch/Plc/CAD/COMPONENTS/E02_infeed_hopper.step

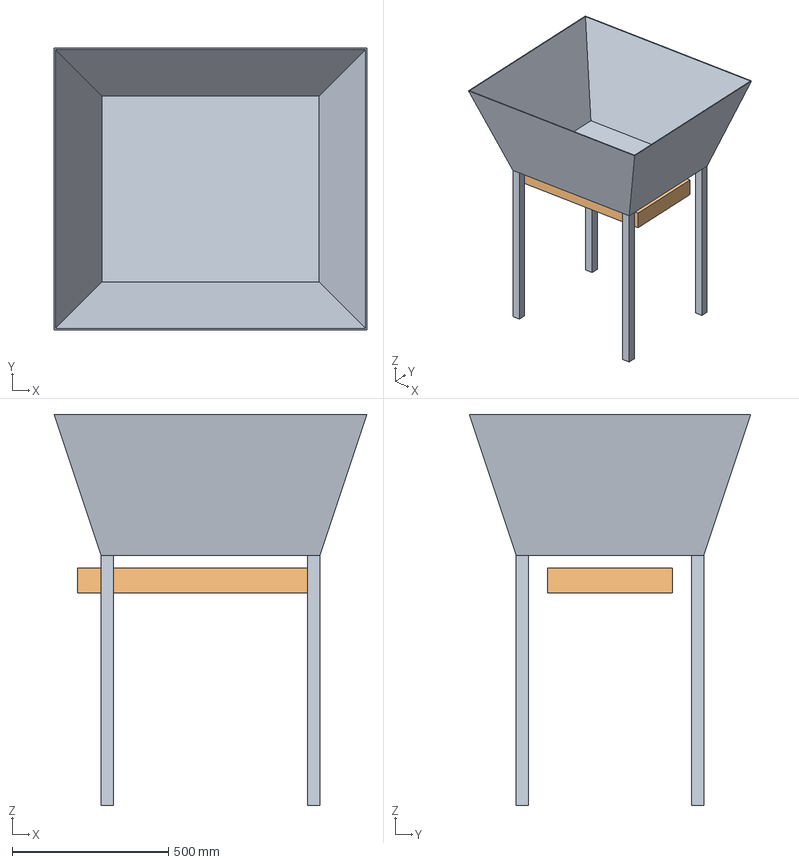
[picture p56: CAD file, 2026-11-11]
CAD/COMPONENTS/E02_infeed_hopper.step
1000.0 x 900.0 x 1250.0 mm
