qaessafty-arch/Plc/CAD/DRAWINGS/components/B10_pull_belt_right.dxf

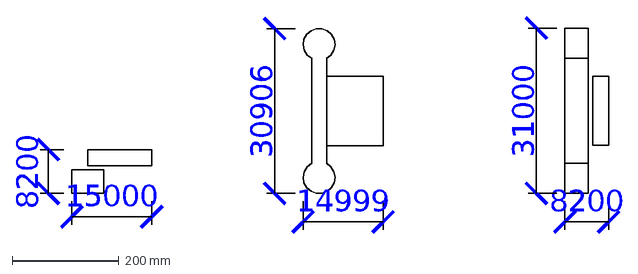
[picture p57: CAD file, 2026-11-11]
CAD/DRAWINGS/components/B10_pull_belt_right.dxf
15000
8200
14999
30906
31000
