qaessafty-arch/Plc/CAD/COMPONENTS/B11_belt_servo_drive.step

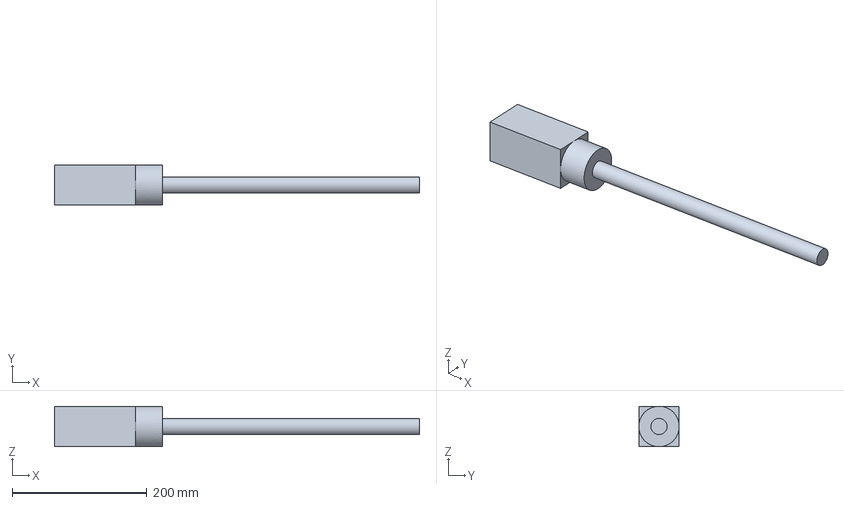
[picture p58: CAD file, 2026-11-11]
CAD/COMPONENTS/B11_belt_servo_drive.step
541.9 x 60.0 x 60.0 mm
