qaessafty-arch/Plc/CAD/DRAWINGS/components/W01_multihead_weigher.dxf

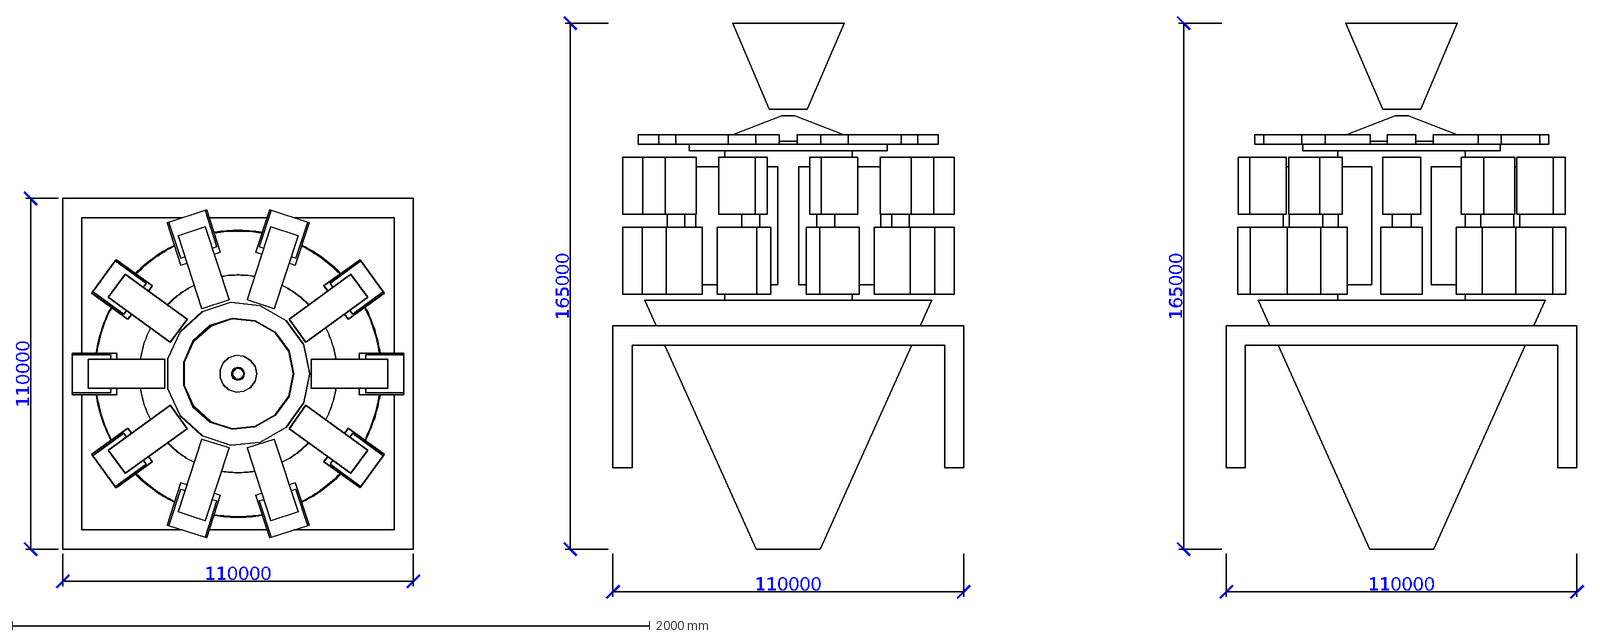
[picture p59: CAD file, 2026-11-11]
CAD/DRAWINGS/components/W01_multihead_weigher.dxf
110000
165000
