qaessafty-arch/Plc/CAD/COMPONENTS/B15_electrical_cabinet.step

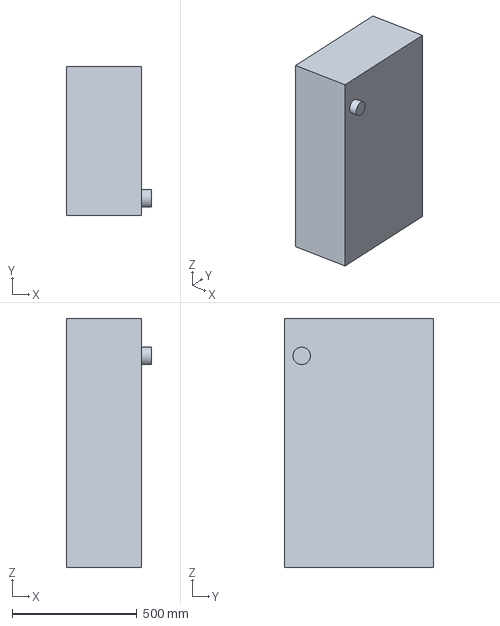
[picture p60: CAD file, 2026-11-11]
CAD/COMPONENTS/B15_electrical_cabinet.step
340.0 x 600.0 x 1000.0 mm
