qaessafty-arch/Plc/CAD/DRAWINGS/components/B03_unwind_shaft.dxf

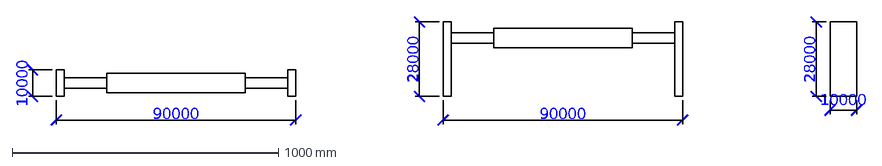
[picture p61: CAD file, 2026-11-11]
CAD/DRAWINGS/components/B03_unwind_shaft.dxf
90000
10000
28000
