qaessafty-arch/Plc/CAD/COMPONENTS/P01_weigher_platform.step

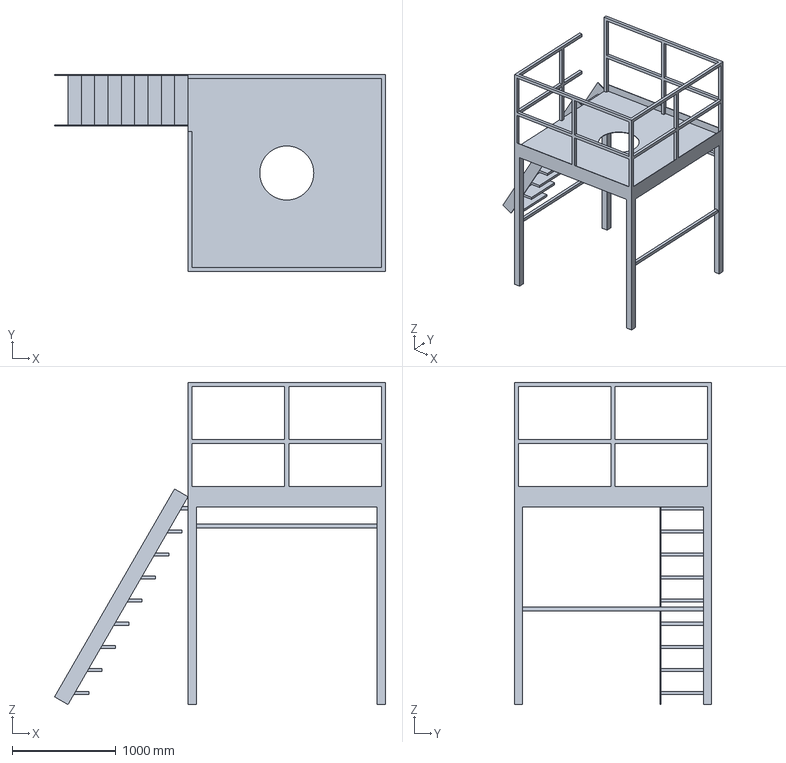
[picture p62: CAD file, 2026-11-11]
CAD/COMPONENTS/P01_weigher_platform.step
3184.6 x 1900.0 x 3100.0 mm
