qaessafty-arch/Plc/CAD/COMPONENTS/B07_forming_collar.step

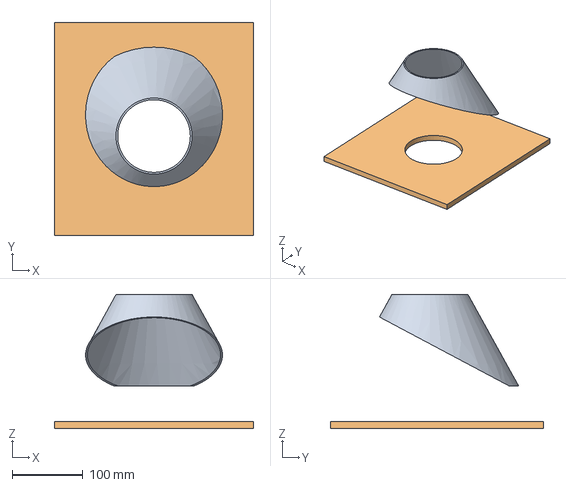
[picture p63: CAD file, 2026-11-11]
CAD/COMPONENTS/B07_forming_collar.step
281.9 x 301.9 x 190.0 mm
