qaessafty-arch/Plc/CAD/COMPONENTS/E01_z_bucket_elevator.step

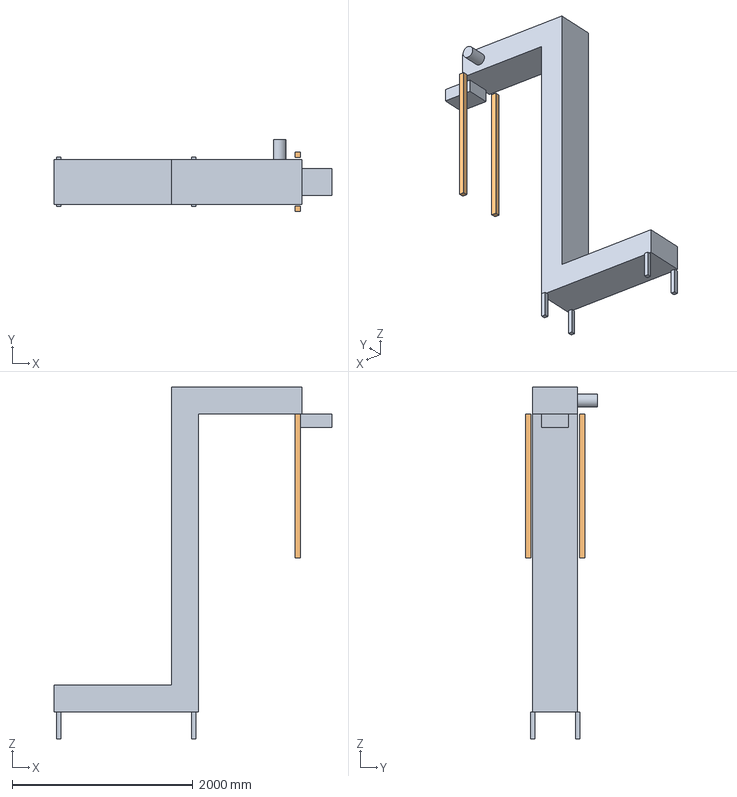
[picture p64: CAD file, 2026-11-11]
CAD/COMPONENTS/E01_z_bucket_elevator.step
3080.0 x 800.0 x 3900.0 mm
