qaessafty-arch/Plc/CAD/DRAWINGS/components/B07_forming_collar.dxf

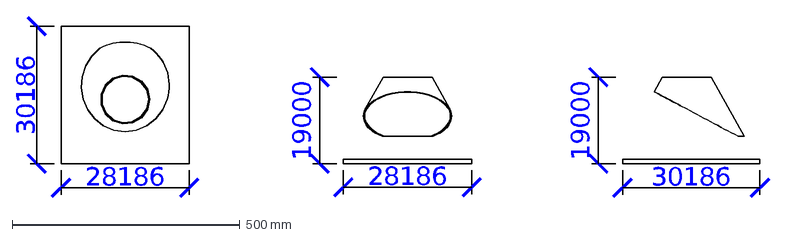
[picture p65: CAD file, 2026-11-11]
CAD/DRAWINGS/components/B07_forming_collar.dxf
28186
30186
19000
