qaessafty-arch/Plc/CAD/COMPONENTS/B09_pull_belt_left.step

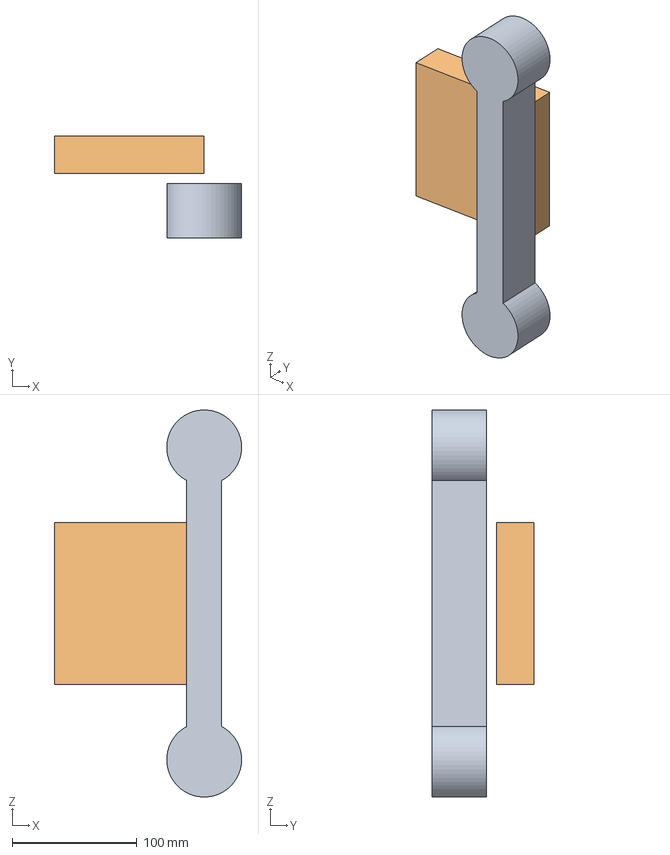
[picture p66: CAD file, 2026-11-11]
CAD/COMPONENTS/B09_pull_belt_left.step
150.0 x 82.0 x 309.9 mm
