qaessafty-arch/Plc/CAD/DRAWINGS/components/B02_film_roll.dxf

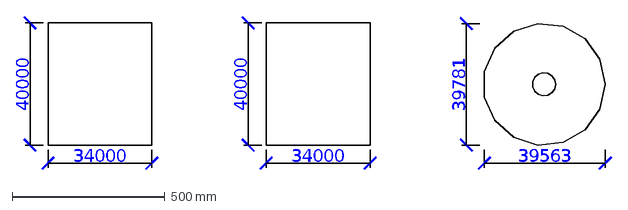
[picture p67: CAD file, 2026-11-11]
CAD/DRAWINGS/components/B02_film_roll.dxf
34000
40000
39563
39781
