qaessafty-arch/Plc/CAD/DRAWINGS/components/B05_dancer_arm.dxf

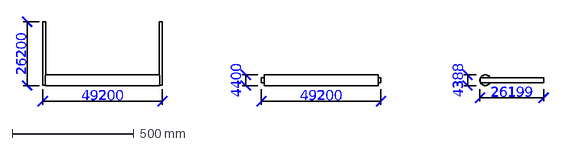
[picture p68: CAD file, 2026-11-11]
CAD/DRAWINGS/components/B05_dancer_arm.dxf
49200
26200
4400
26199
4388
