qaessafty-arch/Plc/CAD/COMPONENTS/B02_film_roll.step

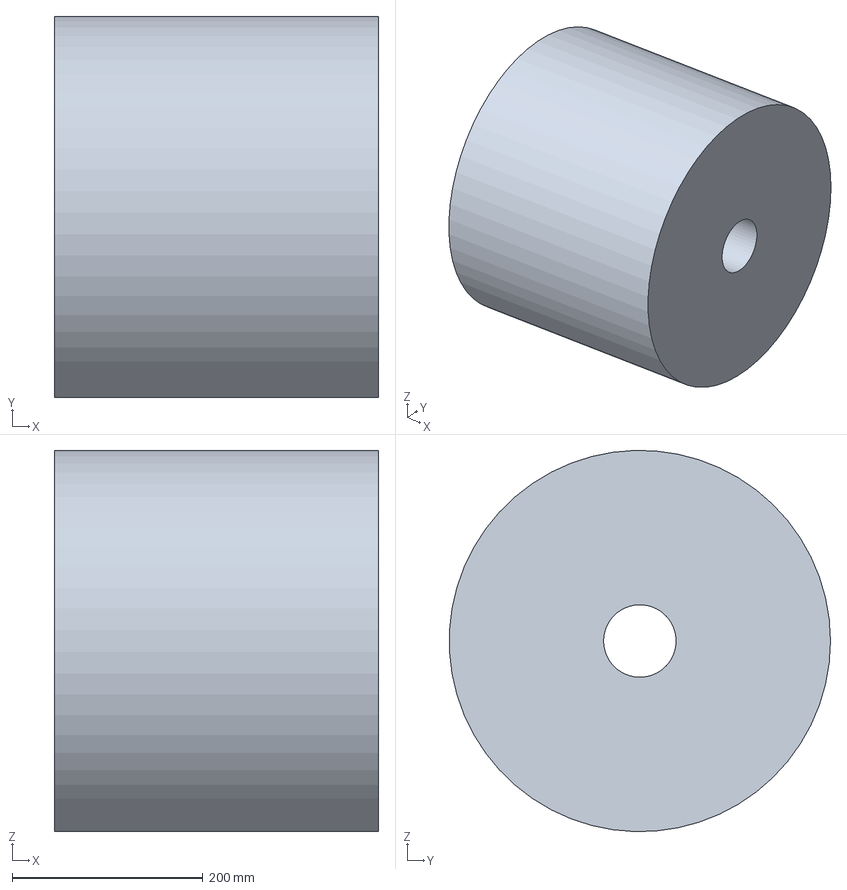
[picture p69: CAD file, 2026-11-11]
CAD/COMPONENTS/B02_film_roll.step
340.0 x 399.7 x 399.8 mm
