qaessafty-arch/Plc/CAD/DRAWINGS/components/B17_film_web.dxf

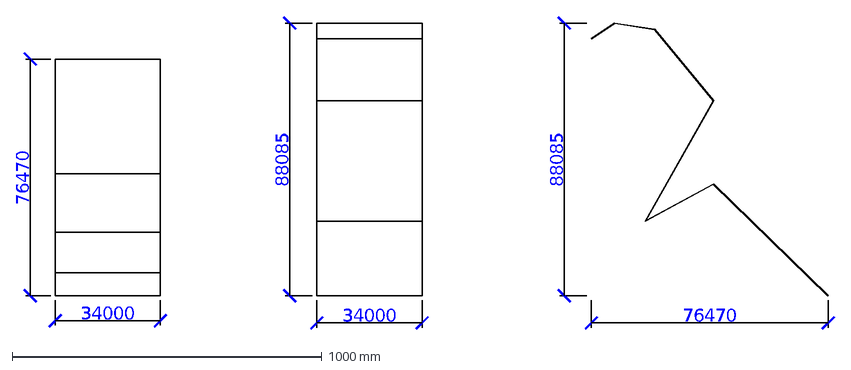
[picture p70: CAD file, 2026-11-11]
CAD/DRAWINGS/components/B17_film_web.dxf
34000
76470
88085
