qaessafty-arch/Plc/CAD/DRAWINGS/components/B06_forming_tube.dxf

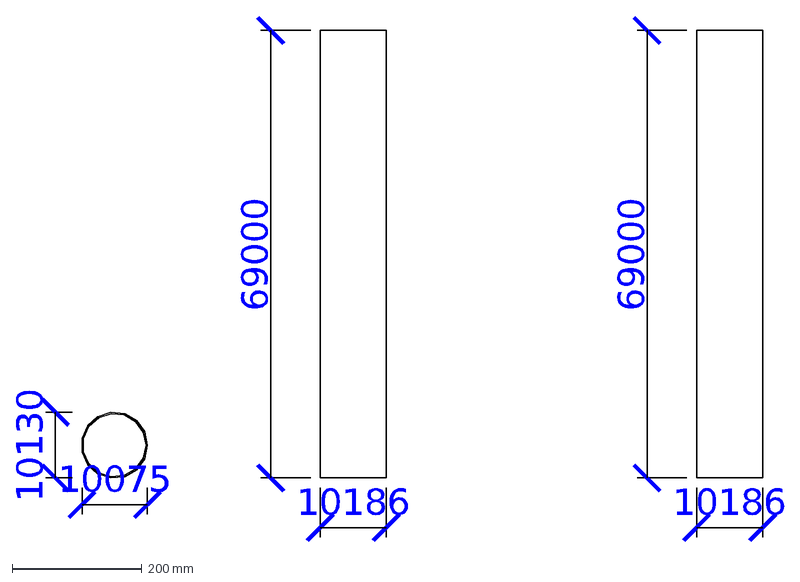
[picture p71: CAD file, 2026-11-11]
CAD/DRAWINGS/components/B06_forming_tube.dxf
10075
10130
10186
69000
