qaessafty-arch/Plc/CAD/COMPONENTS/B05_dancer_arm.step

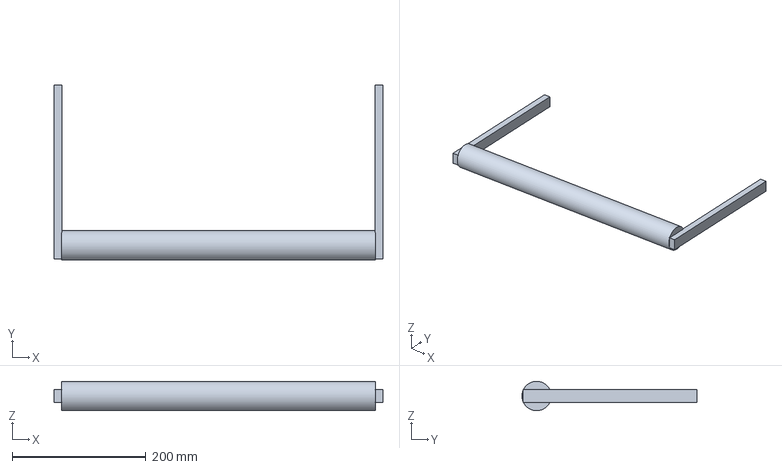
[picture p72: CAD file, 2026-11-11]
CAD/COMPONENTS/B05_dancer_arm.step
492.0 x 262.0 x 44.0 mm
