qaessafty-arch/Plc/CAD/COMPONENTS/W01_multihead_weigher.step

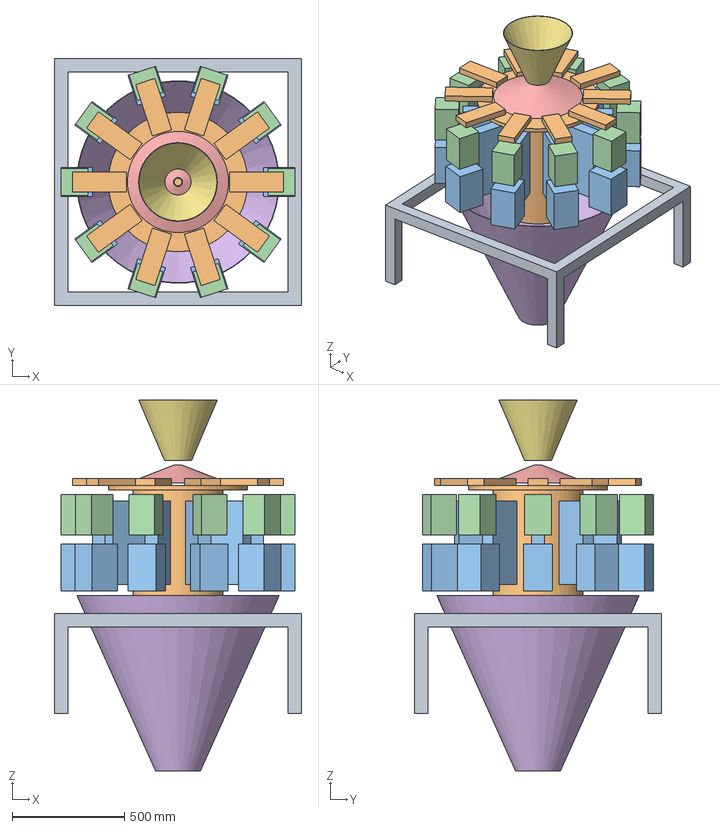
[picture p73: CAD file, 2026-11-11]
CAD/COMPONENTS/W01_multihead_weigher.step
1100.0 x 1100.0 x 1650.0 mm
