qaessafty-arch/Plc/CAD/DRAWINGS/components/B09_pull_belt_left.dxf

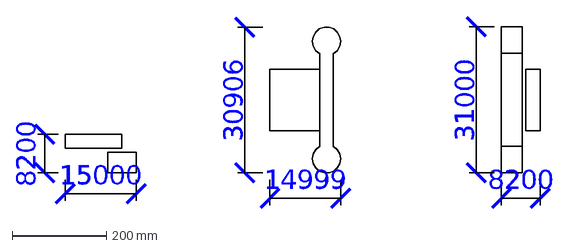
[picture p74: CAD file, 2026-11-11]
CAD/DRAWINGS/components/B09_pull_belt_left.dxf
15000
8200
14999
30906
31000
