qaessafty-arch/Plc/CAD/COMPONENTS/B14_guard_doors.step

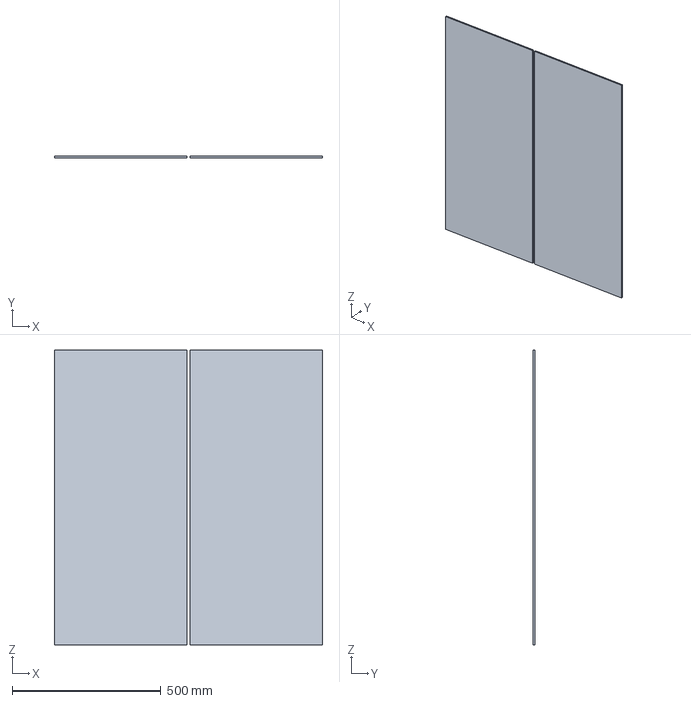
[picture p75: CAD file, 2026-11-11]
CAD/COMPONENTS/B14_guard_doors.step
900.0 x 6.00 x 990.0 mm
