qaessafty-arch/Plc/CAD/DRAWINGS/components/B15_electrical_cabinet.dxf

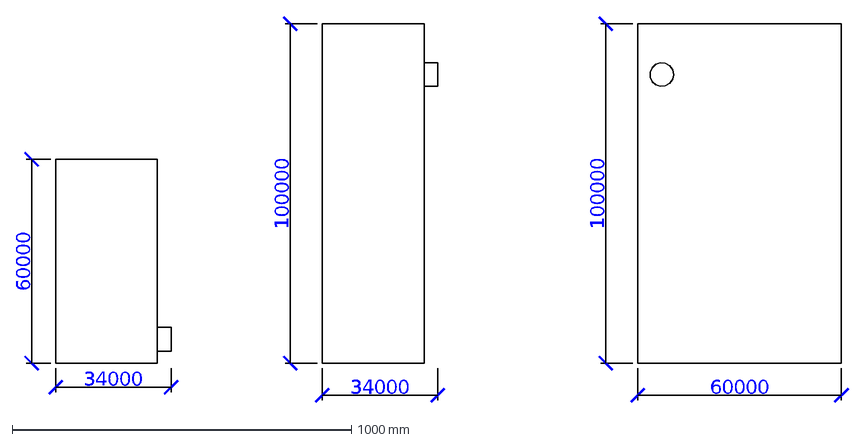
[picture p76: CAD file, 2026-11-11]
CAD/DRAWINGS/components/B15_electrical_cabinet.dxf
34000
60000
100000
