qaessafty-arch/Plc/CAD/COMPONENTS/B08_infeed_funnel.step

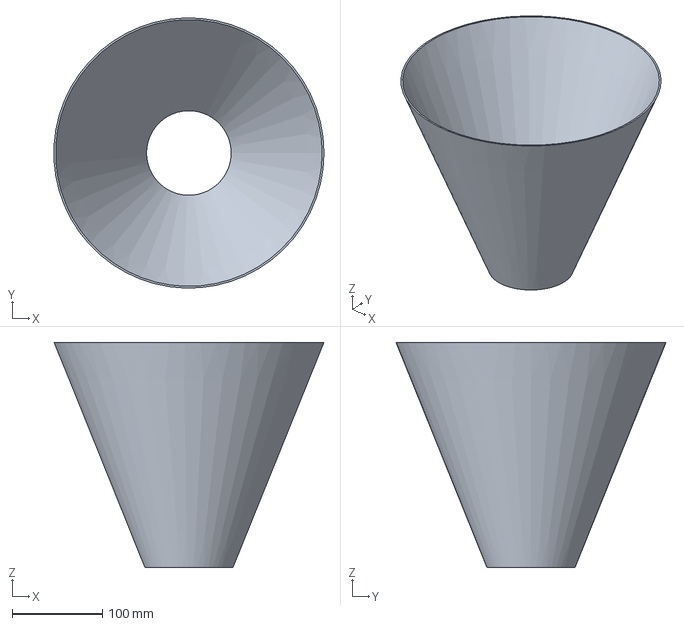
[picture p77: CAD file, 2026-11-11]
CAD/COMPONENTS/B08_infeed_funnel.step
299.8 x 299.9 x 250.0 mm
