qaessafty-arch/Plc/CAD/DRAWINGS/components/E02_infeed_hopper.dxf

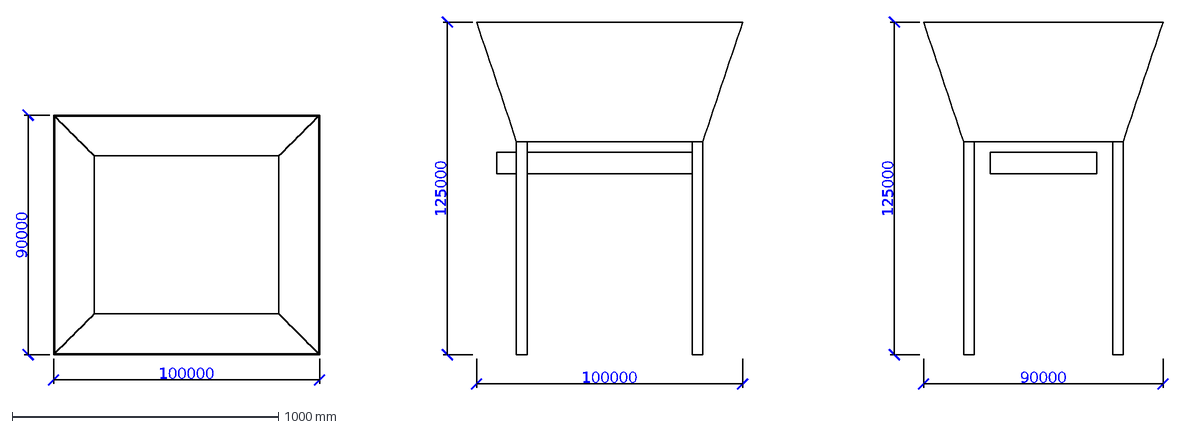
[picture p78: CAD file, 2026-11-11]
CAD/DRAWINGS/components/E02_infeed_hopper.dxf
100000
90000
125000
