qaessafty-arch/Plc/CAD/COMPONENTS/B06_forming_tube.step

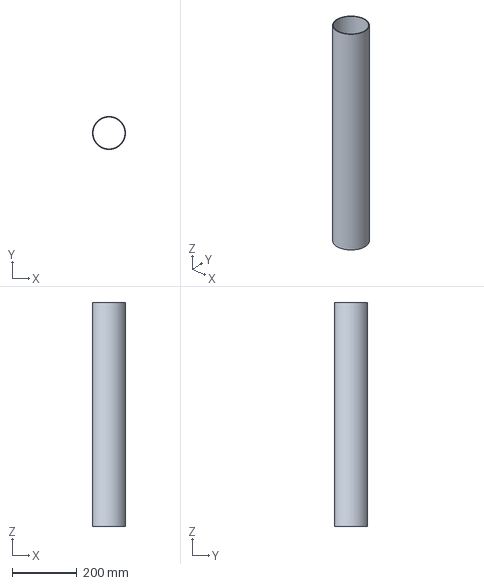
[picture p79: CAD file, 2026-11-11]
CAD/COMPONENTS/B06_forming_tube.step
101.8 x 101.8 x 690.0 mm
