qaessafty-arch/Plc/CAD/DRAWINGS/components/B16_hmi_station.dxf

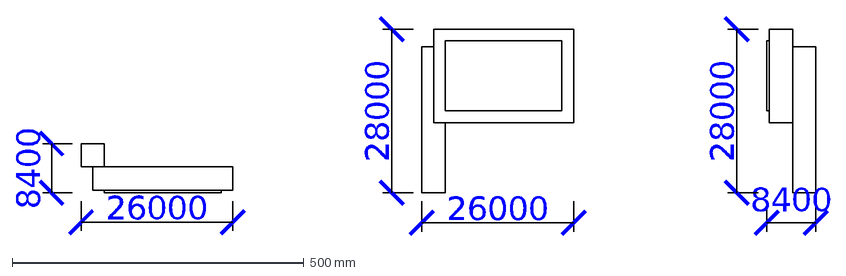
[picture p80: CAD file, 2026-11-11]
CAD/DRAWINGS/components/B16_hmi_station.dxf
26000
8400
28000
