qaessafty-arch/Plc/CAD/COMPONENTS/B17_film_web.step

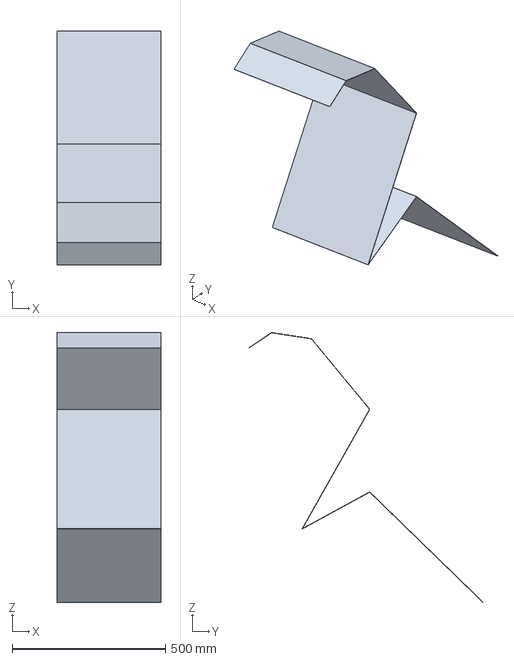
[picture p81: CAD file, 2026-11-11]
CAD/COMPONENTS/B17_film_web.step
340.0 x 764.7 x 880.9 mm
