qaessafty-arch/Plc/CAD/DRAWINGS/components/B08_infeed_funnel.dxf

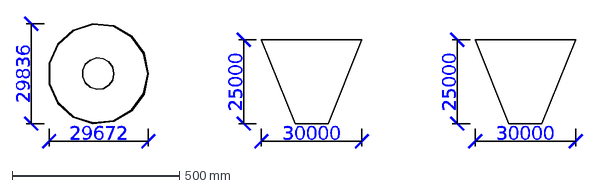
[picture p82: CAD file, 2026-11-11]
CAD/DRAWINGS/components/B08_infeed_funnel.dxf
29672
29836
30000
25000
