qaessafty-arch/Plc/CAD/COMPONENTS/B16_hmi_station.step

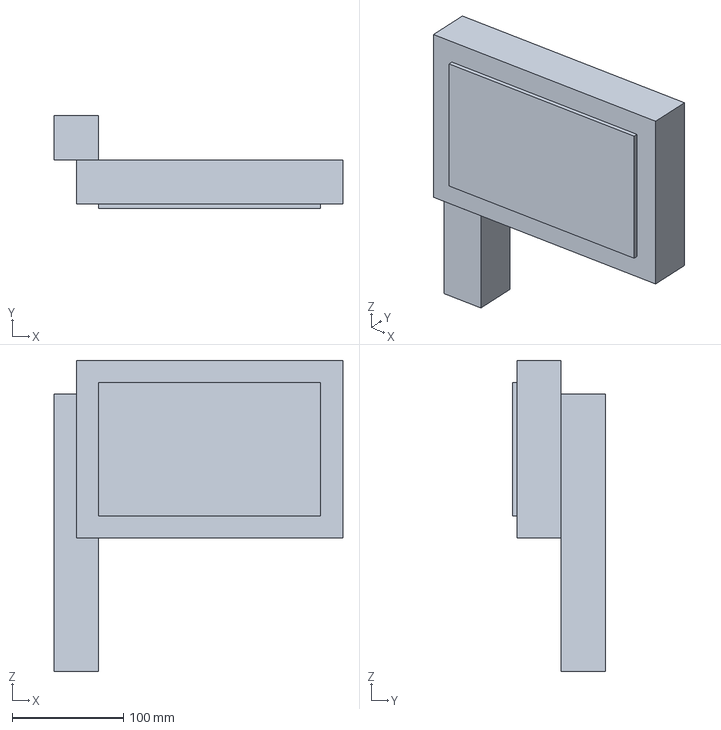
[picture p83: CAD file, 2026-11-11]
CAD/COMPONENTS/B16_hmi_station.step
260.0 x 84.0 x 280.0 mm
