qaessafty-arch/Plc/CAD/DRAWINGS/components/B14_guard_doors.dxf

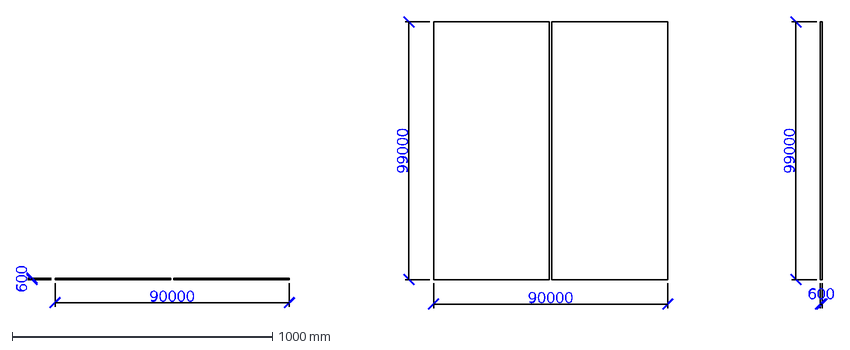
[picture p84: CAD file, 2026-11-11]
CAD/DRAWINGS/components/B14_guard_doors.dxf
90000
600
99000
