qaessafty-arch/Plc/(list of files, cad)

Other CAD files:
WEB3D/downloads/SPM-420_assembly.step
CAD/DRAWINGS/components/P01_weigher_platform.dxf
CAD/DRAWINGS/components/E01_z_bucket_elevator.dxf
CAD/COMPONENTS/B10_pull_belt_right.step
CAD/ASSEMBLY/SPM-420_assembly.stl
CAD/COMPONENTS/B01_main_frame.stl
CAD/COMPONENTS/B02_film_roll.stl
CAD/COMPONENTS/B03_unwind_shaft.stl
CAD/COMPONENTS/B04_guide_rollers.stl
CAD/COMPONENTS/B05_dancer_arm.stl
CAD/COMPONENTS/B06_forming_tube.stl
CAD/COMPONENTS/B07_forming_collar.stl
CAD/COMPONENTS/B08_infeed_funnel.stl
CAD/COMPONENTS/B09_pull_belt_left.stl
CAD/COMPONENTS/B10_pull_belt_right.stl
CAD/COMPONENTS/B11_belt_servo_drive.stl
CAD/COMPONENTS/B12_vertical_seal.stl
CAD/COMPONENTS/B13_jaw_assembly.stl
CAD/COMPONENTS/B14_guard_doors.stl
CAD/COMPONENTS/B15_electrical_cabinet.stl
CAD/COMPONENTS/B16_hmi_station.stl
CAD/COMPONENTS/B17_film_web.stl
CAD/COMPONENTS/C01_takeoff_conveyor.stl
CAD/COMPONENTS/E01_z_bucket_elevator.stl
CAD/COMPONENTS/E02_infeed_hopper.stl
CAD/COMPONENTS/P01_weigher_platform.stl
CAD/COMPONENTS/W01_multihead_weigher.stl
CAD/EXPLODED/SPM-420_exploded.stl
