qaessafty-arch/Plc/SIMULATION/RESULTS.md

# Simulation results (model-in-the-loop)

> Generated by `run_simulation.py`. **These are results of a software model** (Python port of the PLC sequence + assumed plant physics). They show that the sequence design behaves as intended against the assumptions; they are not measurements and do not validate machine performance.

**51 of 51 checks passed.**

## S01 normal automatic production

| Check | Result |
|---|---|
| PLC bag count equals filled bags in plant (+/-1 in flight) | PASS |
| no product caught in the seal | PASS |
| every piece lands while the jaws are closed and support the new seal | PASS |
| all filled bags within +/-10 % of target | PASS |
| speed is paced to the 40 bags/min recipe value (+/-0.5) | PASS |
| speed reported by the PLC matches the real speed (+/-0.5) | PASS |
| bag length 230 +/-1 mm | PASS |
| no alarm (warnings 21/26/32 allowed) | PASS |
| exactly one empty leader bag | PASS |

```json
{
 "sim_seconds": 120,
 "bags_plc": 78,
 "bags_plant_filled": 78,
 "empty_plc": 1,
 "mean_period_s": 1.504,
 "speed_bpm": 39.9,
 "plc_reported_speed_bpm": 39.9,
 "weights": {
  "n": 78,
  "mean": 40.41,
  "sd": 0.48,
  "min": 39.57,
  "max": 42.49,
  "within_10pct": 100.0
 },
 "bag_length_mm": [
  230.0,
  230.0
 ],
 "product_in_seal_events": 0,
 "pieces_landed_jaws_closed": 948,
 "pieces_landed_jaws_open": 0,
 "alarms": [],
 "state": 3
}
```

## S02 cold start / warm-up

| Check | Result |
|---|---|
| reaches RUNNING without alarm 16 | PASS |
| overshoot below 15 K | PASS |
| no bag made before temperatures in band | PASS |

```json
{
 "time_to_running_min": 4.9,
 "peak_temp_C": 154.5,
 "setpoints": [
  150.0,
  150.0,
  140.0
 ],
 "bags_after_60s": 38
}
```

## S03 empty product hopper

| Check | Result |
|---|---|
| starved warning 21 raised | PASS |
| machine waits: no film pulled while starved | PASS |
| stays in RUNNING (no fault) | PASS |
| resumes by itself after refill | PASS |
| no empty bags produced while starved | PASS |

```json
{
 "bags_before": 6,
 "bags_during_starvation": 1,
 "alarms_during": [
  21
 ],
 "amber_lamp": true,
 "film_wasted_mm": 0.0,
 "bags_after_refill": 6,
 "state": 3
}
```

## S04 missing packaging film

| Check | Result |
|---|---|
| alarm 4 film end | PASS |
| machine stopped (STOPPED) | PASS |
| jaws open, cycle idle | PASS |
| reset returns to STOPPED, no automatic restart | PASS |

```json
{
 "alarms": [
  4
 ],
 "state_after": 0,
 "cycle_step": 0,
 "jaws_open": true,
 "state_after_reset": 0,
 "bags": 14,
 "charged_open_bag": true
}
```

## S05 incorrect product weight

| Check | Result |
|---|---|
| FINDING: bagger PLC cannot see weight errors (no alarm, still RUNNING) | PASS |
| bags are under weight in the plant | PASS |

```json
{
 "weights_after_bias": {
  "n": 11,
  "mean": 32.23,
  "sd": 0.39,
  "min": 31.57,
  "max": 32.88,
  "within_10pct": 0.0
 },
 "alarms": [],
 "state": 3
}
```

## S06 jammed discharge / conveyor overload

| Check | Result |
|---|---|
| alarm 22 bag jam | PASS |
| stops within 3 bags of the jam | PASS |
| FAULT state, jaws open | PASS |
| take-off overload -> alarm 25 and FAULT within 0.2 s | PASS |

```json
{
 "bag_jam_alarms": [
  22
 ],
 "state": 5,
 "bags_made_into_jam": 3,
 "jaws_open": true,
 "conveyor_overload_alarms": [
  25
 ],
 "conveyor_state": 5,
 "conveyor_reaction_s": 0.2
}
```

## S07 film-pull servo fault

| Check | Result |
|---|---|
| alarm 18 or 19 | PASS |
| FAULT, jaws open | PASS |
| after reset: STOPPED and no motion until START | PASS |

```json
{
 "alarms": [
  18
 ],
 "state": 5,
 "jaws_open": true,
 "state_after_reset": 0,
 "bags_after_reset": 6
}
```

## S08 excessive sealing temperature (SSR short)

| Check | Result |
|---|---|
| alarm 10 over-temperature | PASS |
| heater contactor dropped | PASS |
| peak stays below cut-out 250 C | PASS |
| machine in FAULT | PASS |

```json
{
 "alarm_time_after_short_s": 223.6,
 "alarms": [
  10,
  16
 ],
 "peak_temp_C": 221.0,
 "heater_contactor": false,
 "independent_cutout_tripped": false,
 "state": 5
}
```

## S09 sensor failure (thermocouple, jaw sensor)

| Check | Result |
|---|---|
| thermocouple break -> alarm 14, zone output 0 % | PASS |
| FAULT on TC break | PASS |
| jaw not closing -> alarm 6 and FAULT | PASS |
| valves de-energised | PASS |
| one RESET press clears alarm and returns to STOPPED | PASS |

```json
{
 "tc_break_alarms": [
  14
 ],
 "tc_state": 5,
 "zone2_output_pct": 0.0,
 "jaw_stuck_alarms": [
  6
 ],
 "jaw_state": 5,
 "valves_off": true,
 "alarms_after_single_reset": [],
 "state_after_single_reset": 0
}
```

## S10 power interruption

| Check | Result |
|---|---|
| alarm 30 power restart | PASS |
| no automatic restart | PASS |
| production resumes only after RESET + START | PASS |

```json
{
 "alarms_after_restart": [
  30
 ],
 "state_after_restart": 0,
 "bags_made_without_start": 0,
 "jaws_open": false,
 "bags_before_start_pressed": 0,
 "bags_after_restart": 10
}
```

## S11 emergency stop during sealing

| Check | Result |
|---|---|
| PLC outputs off within 2 scans (hardware is faster and independent) | PASS |
| state ESTOP | PASS |
| jaws open, heaters off | PASS |
| releasing the button does not restart | PASS |
| reset alone does not restart | PASS |
| START resumes production | PASS |

```json
{
 "outputs_one_scan_after": {
  "JawClose": false,
  "Knife": false,
  "HeaterCont": false
 },
 "state": 6,
 "jaws_open_after_1s": true,
 "heaters_off": true,
 "state_after_release": 6,
 "state_after_reset": 0,
 "bags_after_start": 6
}
```

## S12 air loss / guard door

| Check | Result |
|---|---|
| air loss -> alarm 3, FAULT | PASS |
| guard open -> alarm 2, FAULT, jaws open | PASS |
| heaters stay on with guard open (hot-surface hazard handled by guarding/labels) | PASS |

```json
{
 "air_alarms": [
  3
 ],
 "air_state": 5,
 "guard_alarms": [
  2
 ],
 "guard_state": 5,
 "guard_heaters_kept": true,
 "guard_jaws_open": true
}
```
