qaessafty-arch/Plc/CAD/ASSEMBLY/SPM-420_isometric.pdf

from front-left (operator side) | from rear-right (film and cabinet side)

# SPM-420 assembly

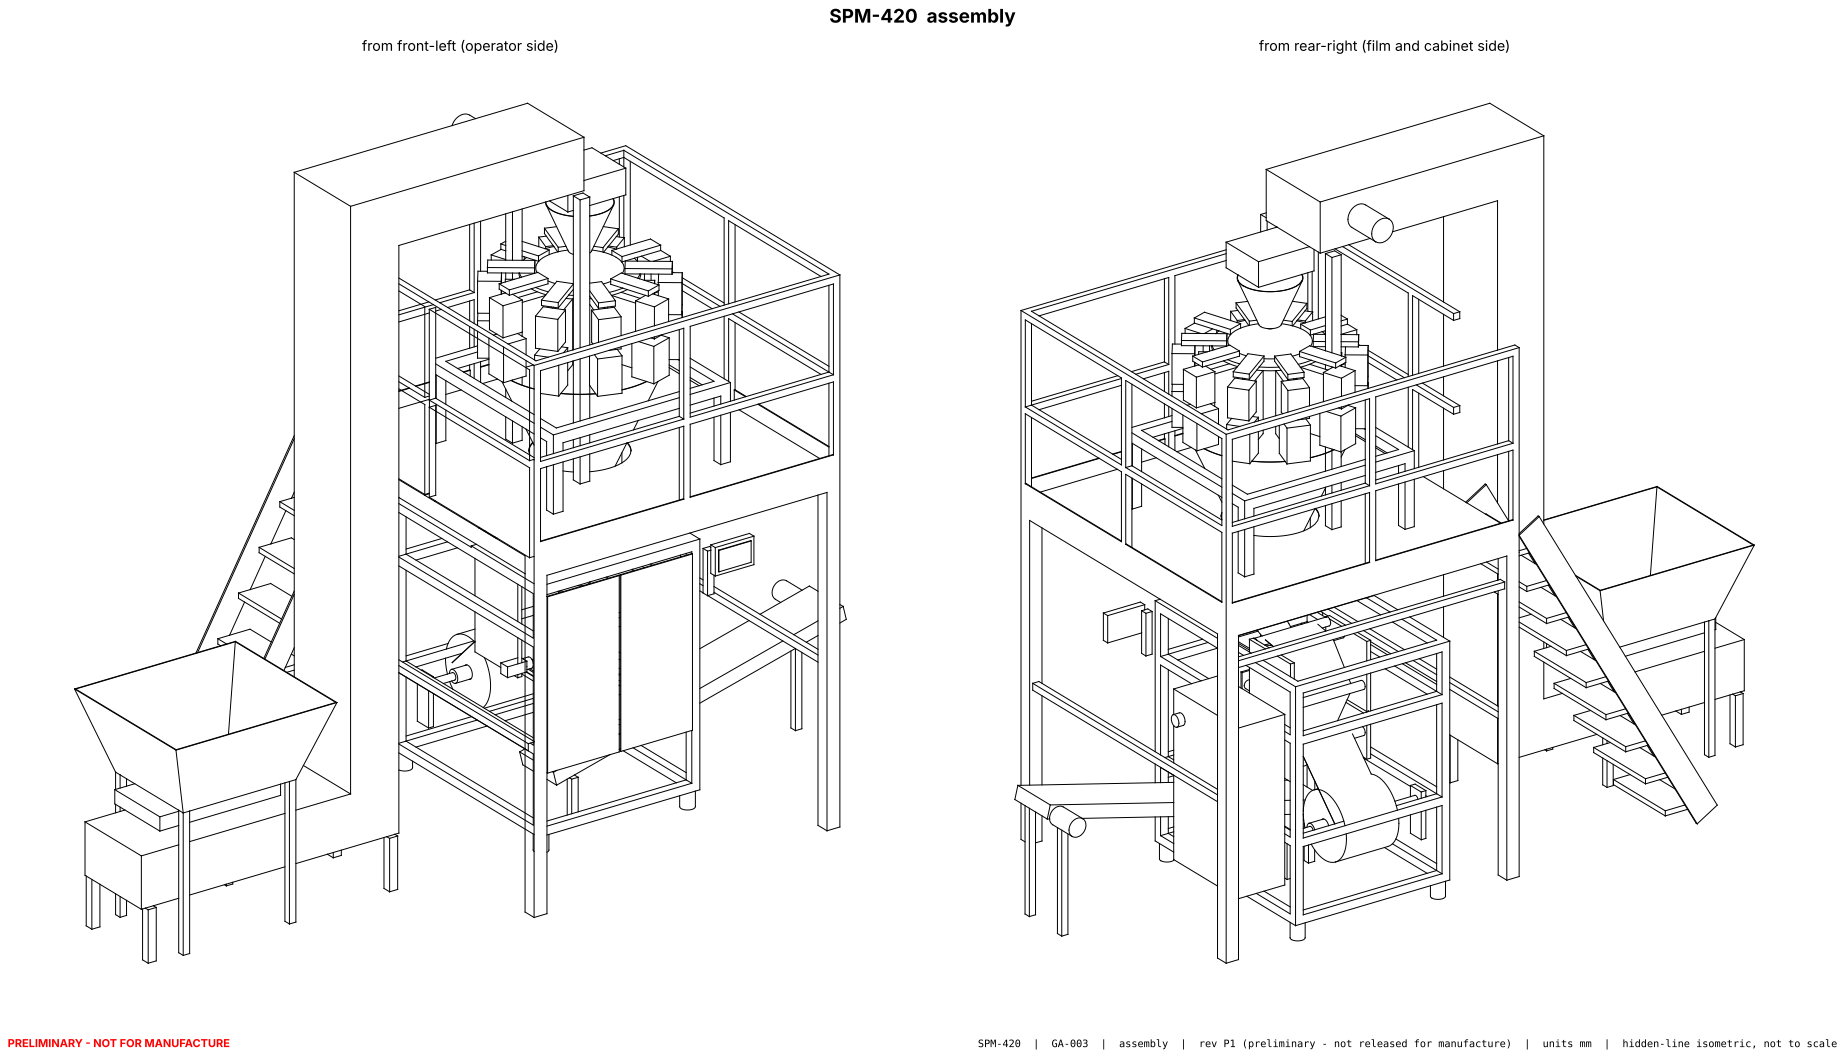
[picture p85: page 1]
PRELIMINARY - NOT FOR MANUFACTURE; SPM-420 | GA-003 | assembly | rev P1 (preliminary - not released for manufacture) | units mm | hidden-line isometric, not to scale
