qaessafty-arch/Plc/CAD/DRAWINGS/GA-001_general_arrangement.pdf

## TOP VIEW

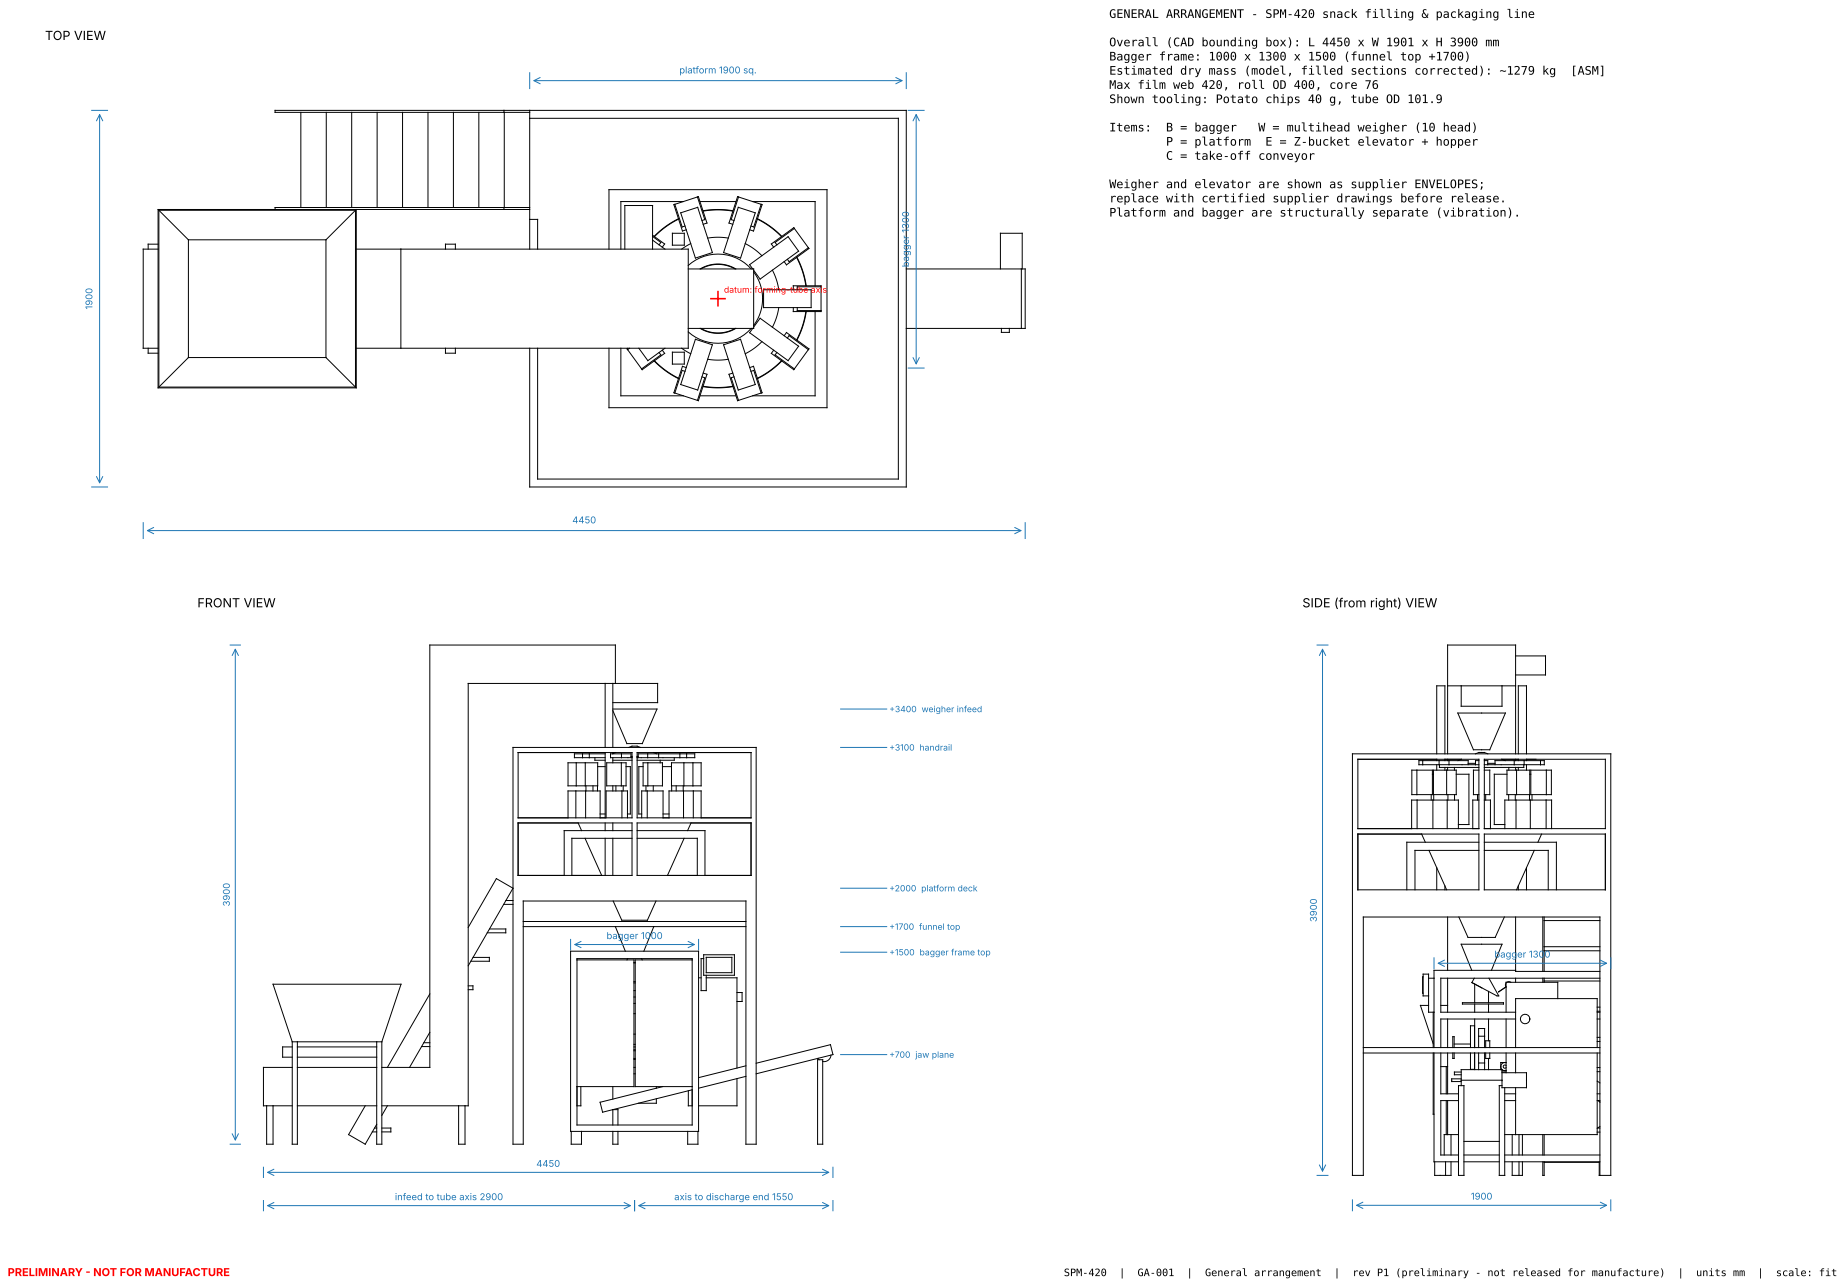
[picture p86: page 1]
platform 1900 sq.; bagger 1300; +700 jaw plane; +1700 funnel top; +2000 platform deck; +3100 handrail; +3400 weigher infeed; bagger 1000; infeed to tube axis 2900; axis to discharge end 1550; FRONT VIEW; Estimated dry mass (model, filled sections corrected): ~1279 kg; [ASM]; Items:; B = bagger; W = multihead weigher (10 head); P = platform; E = Z-bucket elevator + hopper; PRELIMINARY - NOT FOR MANUFACTURE; SPM-420; | General arrangement; | rev P1 (preliminary - not released for manufacture)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

GENERAL ARRANGEMENT - SPM-420 snack filling & packaging line

Overall (CAD bounding box): L 4450 x W 1901 x H 3900 mm
Bagger frame: 1000 x 1300 x 1500 (funnel top +1700)
Max film web 420, roll OD 400, core 76
Shown tooling: Potato chips 40 g, tube OD 101.9

C = take-off conveyor

Weigher and elevator are shown as supplier ENVELOPES;
replace with certified supplier drawings before release.
Platform and bagger are structurally separate (vibration).

datum: forming-tube axis

SIDE (from right) VIEW

+1500 bagger frame top
