qaessafty-arch/Plc/CAD/EXPLODED/SPM-420_exploded.pdf

from front-left (operator side) | from rear-right (film and cabinet side)

# SPM-420 exploded view

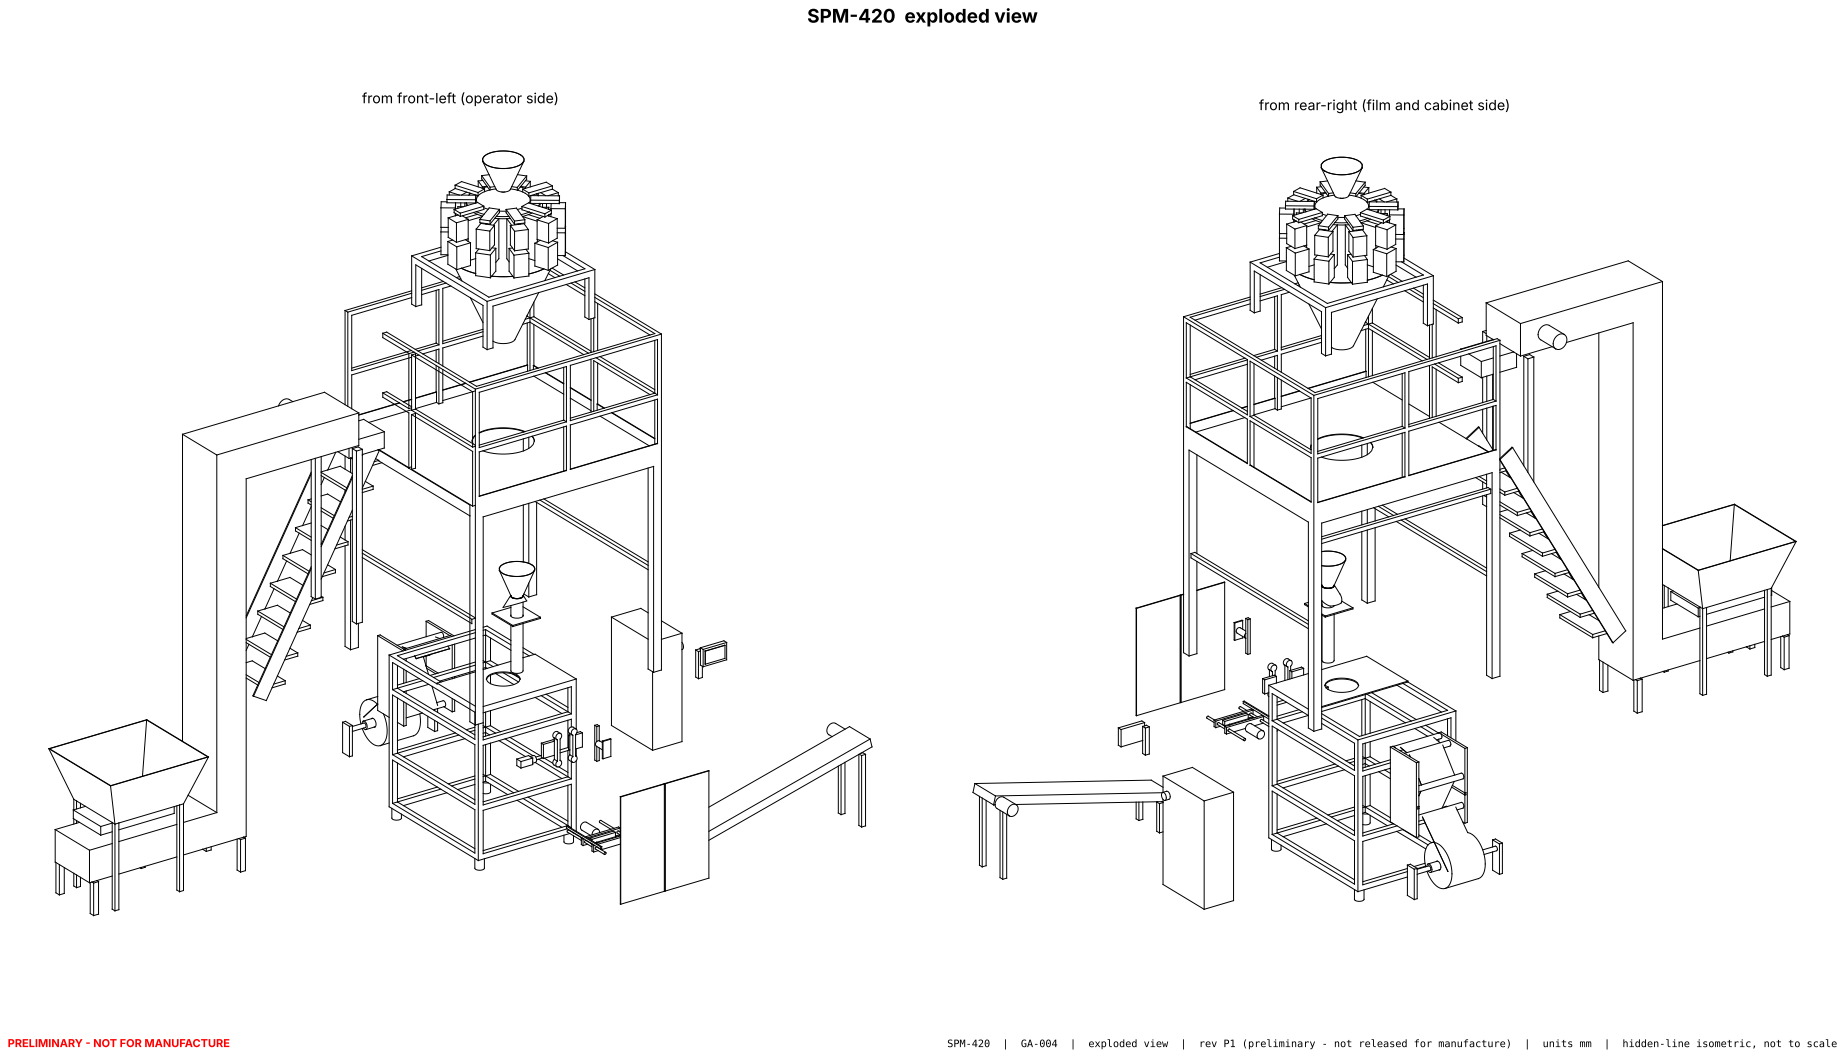
[picture p87: page 1]
PRELIMINARY - NOT FOR MANUFACTURE; SPM-420 | GA-004 | exploded view | rev P1 (preliminary - not released for manufacture) | units mm | hidden-line isometric, not to scale
