qaessafty-arch/Plc/DOCUMENTATION/ENGINEERING/engineering_calcs.py

#!/usr/bin/env python3
"""Engineering calculations for the SPM-420 line.

Run:  python3 DOCUMENTATION/ENGINEERING/engineering_calcs.py
Writes 03_ENGINEERING_CALCULATIONS.md (next to this file) and calc_results.json.
All results are THEORETICAL. Nothing here has been validated on hardware.
"""
import json, math, os, sys
from math import pi, sqrt, comb

HERE = os.path.dirname(os.path.abspath(__file__))
sys.path.insert(0, os.path.join(HERE, "..", ".."))
import machine_params as P

out, R = [], {}


def h(t): out.append(f"\n## {t}\n")
def p(t=""): out.append(t)
def table(head, rows):
    out.append("| " + " | ".join(head) + " |")
    out.append("|" + "---|" * len(head))
    for r in rows:
        out.append("| " + " | ".join(str(c) for c in r) + " |")
    out.append("")


out.append(f"# 03 - Engineering calculations ({P.MACHINE_NAME}, rev {P.REVISION})\n")
p("> Generated by `engineering_calcs.py` from `machine_params.py`. Do not edit by hand.")
p("> **Every number below is a theoretical design value.** Inputs marked [ASM] in "
  "`machine_params.py` are assumptions that must be replaced by measurements "
  "before the design is released.\n")

# 1 ---------------------------------------------------------------- bag geometry
h("1. Bag, film and forming-tube geometry")
p("Tube circumference = 2 x flat bag width, so `D = 2W/pi`. Film width = `2W + overlap`. "
  "Maximum pillow volume uses Robin's paper-bag approximation with the unsealed length "
  "`L - 2 x seal land`. Fill ratio = product bulk volume / maximum pillow volume; "
  f"the design limit is {P.MAX_FILL_RATIO:.2f} so the jaws never close on product.")
rows = []
R["products"] = {}
for k, (label, g, rho, w, L, frag) in P.PRODUCTS.items():
    d = P.tube_diameter(w)
    fw = P.film_width(w)
    vmax = P.pillow_volume_l(w, L - 2 * P.END_SEAL_WIDTH)
    vprod = g / rho
    ratio = vprod / vmax
    ok = "OK" if ratio <= P.MAX_FILL_RATIO and fw <= P.FILM_WIDTH_MAX else "REVISE"
    rows.append([label, g, rho, f"{w} x {L}", f"{d:.1f}", f"{fw:.0f}", f"{vprod:.2f}",
                 f"{vmax:.2f}", f"{ratio:.2f}", ok])
    R["products"][k] = dict(tube_d=round(d, 1), film_w=fw, v_prod=round(vprod, 3),
                            v_max=round(vmax, 3), fill=round(ratio, 3), ok=ok)
table(["Product", "Target g", "Bulk density g/L [ASM]", "Bag W x L mm", "Tube OD mm",
       "Film width mm", "Product L", "Max pillow L", "Fill ratio", "Check"], rows)
wmax = (P.FILM_WIDTH_MAX - P.LAP_OVERLAP) / 2
p(f"Maximum bag width from the {P.FILM_WIDTH_MAX} mm web: ({P.FILM_WIDTH_MAX} - {P.LAP_OVERLAP})/2 "
  f"= **{wmax:.0f} mm**; largest forming tube OD = {P.tube_diameter(wmax):.1f} mm. "
  "Each bag width needs its own forming set (collar + tube): they are format parts.")

ref = P.PRODUCTS[P.REFERENCE_PRODUCT]
W, L, G = ref[3], ref[4], ref[1]

# 2 ---------------------------------------------------------------- cycle
h("2. Machine cycle and theoretical speed (intermittent motion)")
a, v = P.PULL_ACCEL, P.PULL_VMAX
def pull_time(length_mm):
    s = length_mm / 1000
    d_acc = v * v / (2 * a)
    if 2 * d_acc >= s:                      # triangular profile
        return 2 * sqrt(s / a), sqrt(s * a)
    return 2 * v / a + (s - 2 * d_acc) / v, v
rows = []
for LL in (100, 150, 200, L, 300):
    tp, vp = pull_time(LL)
    cyc = P.JAW_STROKE_TIME + P.SEAL_DWELL + P.JAW_STROKE_TIME + tp + P.SETTLE_TIME
    rows.append([LL, f"{tp:.3f}", f"{vp:.2f}", f"{cyc:.3f}", f"{60 / cyc:.1f}"])
    if LL == L:
        R["pull_time"], R["mech_cycle"], R["mech_bpm"] = round(tp, 3), round(cyc, 3), round(60 / cyc, 1)
table(["Bag length mm", "Pull time s", "Peak film speed m/s", "Mechanical cycle s",
       "Mechanical limit bags/min"], rows)
p(f"Cycle = jaw close {P.JAW_STROKE_TIME} + seal dwell {P.SEAL_DWELL} + jaw open "
  f"{P.JAW_STROKE_TIME} + film pull + settle {P.SETTLE_TIME} s. Pull uses a trapezoidal "
  f"profile, a = {a} m/s2, vmax = {v} m/s [ASM: limited by belt/film friction].")
drop_h = (P.WEIGHER_BASE_Z + 450 - P.JAW_Z) / 1000
t_lead = sqrt(2 * drop_h / 9.81)
string = 0.35
R["drop_h"], R["t_lead"] = round(drop_h, 2), round(t_lead, 2)
p(f"\n**Product transfer.** Drop from weigh-hopper gate to jaw plane = {drop_h:.2f} m. "
  f"Leading-edge free-fall time = sqrt(2h/g) = {t_lead:.2f} s (air drag ignored, so the "
  f"real value is longer). Chips arrive as a string; string duration is assumed "
  f"{string:.2f} s [ASM - measure with high-speed video]. Tail arrival = "
  f"{t_lead + string:.2f} s after the dump command. The dump is commanded when the jaws "
  f"start closing, so the tail must arrive before the *next* jaw-close starts, i.e. "
  f"within one cycle minus jaw-close time: {R['mech_cycle'] - P.JAW_STROKE_TIME:.2f} s "
  f"at the mechanical limit -> {'OK' if t_lead + string < R['mech_cycle'] - P.JAW_STROKE_TIME else 'NOT OK'}.")
limit = min(R["mech_bpm"], P.WEIGHER_MAX_WPM, 60 / (t_lead + string + P.JAW_STROKE_TIME))
R["theoretical_bpm"] = round(limit, 1)
p(f"\nTheoretical limit for the reference bag = min(mechanical {R['mech_bpm']}, weigher "
  f"{P.WEIGHER_MAX_WPM}, product string {60 / (t_lead + string + P.JAW_STROKE_TIME):.1f}) = "
  f"**{limit:.1f} bags/min**. Rated design point: **{P.RATED_BPM} bags/min** "
  f"({100 * (1 - P.RATED_BPM / limit):.0f} % margin). Validated speed: *none yet*.")
T = 60 / P.RATED_BPM
R["cycle_rated"] = T

# 3 ---------------------------------------------------------------- film pull servo
h("3. Film-pull servo sizing")
r = P.PULL_PULLEY_DIA / 2000
film_mass_moving = 1.5 * (P.film_width(W) / 1000) * (P.FILM_THICKNESS_UM * 1e-6) * P.FILM_DENSITY
m_equiv = film_mass_moving + 0.6          # 2 belts ~0.3 kg each [ASM]
F_acc = m_equiv * a
F_tot = P.PULL_FILM_DRAG_N + F_acc
T_pulley = F_tot * r
J_pulleys = 4 * 0.5 * 0.25 * r * r        # 4 aluminium pulleys ~0.25 kg each [ASM]
alpha_m = a / r * P.PULL_GEAR_RATIO
J_load_ref = (m_equiv * r * r + J_pulleys) / P.PULL_GEAR_RATIO ** 2
T_motor_peak = T_pulley / (P.PULL_GEAR_RATIO * 0.9) + J_load_ref * alpha_m
rpm_peak = v / (2 * pi * r) * 60 * P.PULL_GEAR_RATIO
tp = R["pull_time"]
T_rms = T_motor_peak * sqrt(tp / T)
rows = [
    ["Film drag (collar + unwind) [ASM]", f"{P.PULL_FILM_DRAG_N:.0f} N"],
    ["Accelerated mass (film + 2 belts)", f"{m_equiv:.2f} kg"],
    ["Peak belt force", f"{F_tot:.1f} N"],
    ["Torque at drive pulleys", f"{T_pulley:.2f} N.m"],
    ["Load inertia reflected to motor", f"{J_load_ref * 1e4:.3f} kg.cm2"],
    ["Peak motor torque (gearbox eff. 0.9)", f"{T_motor_peak:.2f} N.m"],
    ["RMS motor torque at rated speed", f"{T_rms:.2f} N.m"],
    ["Peak motor speed", f"{rpm_peak:.0f} rpm"],
    ["Selected motor rated torque / speed [VER]", f"{P.SERVO_RATED_NM} N.m / {P.SERVO_RATED_RPM} rpm"],
    ["Torque utilisation (peak / rated)", f"{100 * T_motor_peak / P.SERVO_RATED_NM:.0f} %"],
    ["Speed utilisation", f"{100 * rpm_peak / P.SERVO_RATED_RPM:.0f} %"],
]
table(["Quantity", "Value"], rows)
R["servo"] = dict(T_peak=round(T_motor_peak, 3), T_rms=round(T_rms, 3), rpm=round(rpm_peak),
                  J_load_kgcm2=round(J_load_ref * 1e4, 3))
p("One 0.4 kW servo drives both pull belts through a 5:1 planetary gearbox and a "
  "cross shaft with two bevel/timing stages, so the belts cannot run at different "
  "speeds. The 0.4 kW frame is the smallest V90 PROFINET size and is deliberately "
  "oversized: the unknown is film drag, and margin costs little. Inertia ratio must be "
  "checked against the motor rotor inertia in the Siemens data sheet (not transcribed here).")
res_mm = pi * P.PULL_PULLEY_DIA / (P.PULL_GEAR_RATIO * 2500 * 4)
p(f"\nLength resolution with the 2500 ppr TTL encoder (x4): {res_mm * 1000:.1f} um of film "
  "per count - three orders finer than the +/-1 mm bag-length target, so accuracy is "
  "governed by belt slip and registration, not by the drive.")

# 4 ---------------------------------------------------------------- sealing forces / pneumatics
h("4. Sealing forces and pneumatic sizing")
def cyl(bore):
    A = pi * bore ** 2 / 4
    Ar = A - pi * P.ROD_DIA[bore] ** 2 / 4
    return A, Ar
rows, air = [], 0.0
ratio = (P.AIR_PRESSURE_MPA + 0.1013) / 0.1013
for name, (bore, stroke), need in (
    ("Horizontal jaws", P.CYL_JAW, P.JAW_LENGTH * P.END_SEAL_WIDTH * 2 * P.SEAL_PRESSURE_MPA),
    ("Vertical seal bar", P.CYL_VSEAL, P.VSEAL_LENGTH * P.VSEAL_LAND * P.VSEAL_PRESSURE_MPA),
    ("Knife", P.CYL_KNIFE, 150.0)):
    A, Ar = cyl(bore)
    F = A * P.AIR_PRESSURE_MPA * 0.9
    nl = (A + Ar) * stroke / 1e6 * ratio
    air += nl * P.RATED_BPM
    rows.append([name, f"{need:.0f}", f"dia {bore} x {stroke}", f"{F:.0f}", f"{F / need:.2f}",
                 f"{nl:.2f}", f"{nl * P.RATED_BPM:.0f}"])
table(["Actuator", "Required force N", "ISO cylinder", "Force at 0.6 MPa, eff. 0.9 N",
       "Safety factor", "Free air per cycle NL", f"NL/min at {P.RATED_BPM} bpm"], rows)
air_total = air * 1.3 + 30
R["air_nl_min"] = round(air_total)
p(f"Jaw seal area counts both transverse seals (top of the finished bag and bottom of the "
  f"next) = {P.JAW_LENGTH} x {2 * P.END_SEAL_WIDTH} mm. Knife force 150 N is an assumption for "
  f"50 um laminate with a serrated blade. Actuators total {air:.0f} NL/min; adding 30 % for "
  f"leakage/tubing and 30 NL/min for the optional bag-deflate/air-blast gives "
  f"**{air_total:.0f} NL/min ({air_total / 1000:.2f} m3/min) at 0.6 MPa**. Specify a compressor "
  f"of at least {air_total * 1.5 / 1000:.2f} m3/min FAD with dryer and 0.01 um oil-removal "
  "filtration (ISO 8573-1 class 1.4.1 where air can contact product or film inside).")
p(f"\nMaximum jaw closing force {cyl(63)[0] * P.AIR_PRESSURE_MPA:.0f} N is a crushing hazard: "
  "see the safety file - guard interlock, not force limitation, is the protective measure.")

# 5 ---------------------------------------------------------------- thermal
h("5. Heating")
jw, jh = P.JAW_SECTION
m_jaw = jw * jh * P.JAW_LENGTH / 1e9 * 7850
m_v = 25 * 30 * P.VSEAL_LENGTH / 1e9 * 2700
dT = P.SEAL_TEMP_DEFAULT - P.AMBIENT
rows = []
for name, w, m, c in (("Z1 front jaw (steel)", 500, m_jaw, 490), ("Z2 rear jaw (steel)", 500, m_jaw, 490),
                      ("Z3 vertical bar (aluminium)", 300, m_v, 900)):
    E = m * c * dT
    t = E / (w * 0.8)
    rows.append([name, f"{m:.2f}", w, f"{E / 1000:.0f}", f"{t / 60:.1f}"])
table(["Zone", "Mass kg", "Heater W", f"Energy to {P.SEAL_TEMP_DEFAULT} C kJ", "Warm-up min (80 % to metal)"], rows)
film_g_bag = P.film_width(W) / 1000 * L / 1000 * P.FILM_THICKNESS_UM * 1e-6 * P.FILM_DENSITY * 1000
seal_mass = (P.JAW_LENGTH * 2 * P.END_SEAL_WIDTH + L * P.VSEAL_LAND) / 1e6 * 2 * P.FILM_THICKNESS_UM * 1e-6 * P.FILM_DENSITY
q_film = seal_mass * 1900 * dT * P.RATED_BPM / 60
loss = 3 * 0.035 * 10 * dT * 1.0
R["heater_total_w"] = sum(P.HEATERS_W.values())
p(f"Steady state: heat carried away by the film in the seal lands = {q_film:.0f} W at "
  f"{P.RATED_BPM} bpm (c = 1900 J/kg.K); convective/radiative loss estimated at ~{loss:.0f} W "
  f"(3 bars, h = 10 W/m2K, ~0.035 m2 each [ASM]). Installed {R['heater_total_w']} W gives a "
  f"duty cycle of roughly {100 * (q_film + loss) / R['heater_total_w']:.0f} %, which leaves PID "
  "authority for recovery after a stop. Each zone has a type-K thermocouple in the jaw, "
  "time-proportioned SSR control from the PLC, and an independent bimetal cut-out "
  f"(manual reset, {P.SEAL_TEMP_MAX + 30} C) in series with the heater contactor coil.")

# 6 ---------------------------------------------------------------- elevator / throughput
h("6. Throughput, elevator and weigher capacity")
kg_h = G * P.RATED_BPM * 60 / 1000
l_h = kg_h * 1000 / ref[2]
cap_l_h = P.ELEV_BUCKET_L * P.ELEV_FILL / (P.ELEV_BUCKET_PITCH / 1000) * P.ELEV_SPEED * 3600
R.update(kg_h=round(kg_h, 1), l_h=round(l_h), elev_l_h=round(cap_l_h))
rows = []
for k, (label, g, rho, w_, l_, fr) in P.PRODUCTS.items():
    kh = g * P.RATED_BPM * 60 / 1000
    rows.append([label, f"{kh:.0f}", f"{kh * 1000 / rho:.0f}", f"{100 * kh * 1000 / rho / cap_l_h:.0f} %"])
table(["Product", f"kg/h at {P.RATED_BPM} bpm", "L/h", "Elevator utilisation"], rows)
p(f"Z-bucket elevator: {P.ELEV_BUCKET_L} L buckets at {P.ELEV_BUCKET_PITCH} mm pitch, filled to "
  f"{P.ELEV_FILL:.0%} (fragile product must not be heaped), chain speed {P.ELEV_SPEED} m/s -> "
  f"**{cap_l_h:.0f} L/h**. The elevator runs on demand from the weigher infeed level sensor, "
  "so utilisation above ~70 % means the speed (VFD) must be raised for that product.")
p(f"\nCombination count for a {P.WEIGHER_HEADS}-head weigher: "
  + ", ".join(f"C({P.WEIGHER_HEADS},{k}) = {comb(P.WEIGHER_HEADS, k)}" for k in (3, 4, 5))
  + f"; all subsets = {2 ** P.WEIGHER_HEADS - 1}. Accuracy is evaluated by Monte-Carlo in "
  "`SIMULATION/weigher_sim.py`, not asserted here.")
head_fill = G / 3.5
p(f"\nPer-head target charge for {G:.0f} g = target / 3.5 = {head_fill:.1f} g = "
  f"{head_fill / ref[2]:.2f} L -> {100 * head_fill / ref[2] / P.WEIGHER_HOPPER_L:.0f} % of the "
  f"{P.WEIGHER_HOPPER_L} L hopper (must stay below ~70 % for chips so gates close cleanly).")

# 7 ---------------------------------------------------------------- electrical
h("7. Electrical load, protection and cable sizing")
loads = [  # name, kW, phases, supply line, pf, note
    ("Multihead weigher (OEM cabinet)", P.WEIGHER_KW, 1, "L1", 0.9, "own internal protection"),
    ("Heaters Z1+Z2+Z3", R["heater_total_w"] / 1000, 1, "L2", 1.0, "3 SSR zones"),
    ("24 V DC power supply 240 W", 0.24 / 0.9, 1, "L2", 0.95, "PLC, HMI, valves, sensors"),
    ("Film servo drive 0.4 kW", 0.4 / 0.85, 1, "L3", 0.7, "peak 3x for <0.3 s"),
    ("Elevator VFD 0.37 kW", P.ELEV_KW / 0.75, 1, "L3", 0.7, "1AC in / 3AC 230 V out"),
    ("Take-off VFD 0.18 kW", P.TAKEOFF_KW / 0.7, 1, "L3", 0.7, ""),
    ("Infeed vibratory feeder", P.FEEDER_KW, 1, "L1", 0.6, "thyristor controller"),
    ("Date coder / service socket allowance", 0.30, 1, "L1", 0.9, ""),
]
rows, phase = [], {"L1": 0.0, "L2": 0.0, "L3": 0.0}
tot = 0.0
for n, kw, ph, line, pf, note in loads:
    i = kw * 1000 / (P.V_LN * pf)
    phase[line] += i
    tot += kw
    rows.append([n, f"{kw:.2f}", line, pf, f"{i:.1f}", note])
table(["Load", "Input kW", "Phase", "PF [ASM]", "Current A", "Note"], rows)
imax = max(phase.values())
R["phase_A"] = {k: round(v_, 1) for k, v_ in phase.items()}
R["connected_kw"] = round(tot, 2)
demand = tot * 0.7
R["demand_kw"] = round(demand, 2)
p(f"Connected load **{tot:.2f} kW**; phase currents L1 {phase['L1']:.1f} A, L2 {phase['L2']:.1f} A, "
  f"L3 {phase['L3']:.1f} A (arithmetic sum, conservative). Estimated running demand at 0.7 "
  f"diversity: {demand:.1f} kW.")
main = next(s for s in (10, 16, 20, 25, 32) if s >= imax * 1.25)
R["main_breaker_A"] = main
p(f"\n* Main protective device: {main} A 4-pole C-curve MCB (>= 1.25 x {imax:.1f} A), 10 kA; "
  "upstream short-circuit level must be confirmed on site.")
p(f"* Supply disconnector: 4-pole, lockable in OFF, AC-23 >= {max(main, 25)} A, red/yellow handle (IEC 60204-1 5.3).")
p(f"* Supply cable: 5G4 mm2 Cu (PVC, 30 C, method B2 ~ 27 A) for a {main} A device; voltage drop at "
  f"30 m = {sqrt(3) * imax * 30 * 0.0225 / 4:.1f} V ({100 * sqrt(3) * imax * 30 * 0.0225 / 4 / 400:.2f} %).")
p("* Residual-current protection: servo drive and VFDs produce DC-component leakage; if an RCD "
  "is required by the installation use type B, 300 mA, and keep the 30 mA type A device for the service socket only.")
dc = [("CPU 1215C + SM 1223 + SM 1231 logic", 0.75), ("KTP700 HMI [VER 0.23 A]", 0.23),
      ("Sensors, 16 x 25 mA", 0.40), ("Solenoid valves, 6 x 2.5 W simultaneous", 0.63),
      ("SSR inputs 3 x 15 mA", 0.05), ("Safety relays 2 x 2.5 W", 0.21),
      ("Stack light + buzzer", 0.20), ("Interface relays 8 x 0.4 W", 0.14),
      ("Ethernet switch", 0.25), ("Servo/VFD control 24 V", 1.0)]
idc = sum(x[1] for x in dc)
table(["24 V DC consumer", "A"], [[a_, f"{b:.2f}"] for a_, b in dc] + [["**Total**", f"**{idc:.2f}**"]])
R["dc_A"] = round(idc, 2)
p(f"Selected supply 24 V / 10 A (load {100 * idc / 10:.0f} %). Split into fused branches: "
  "F10 PLC/HMI 4 A, F11 sensors 2 A, F12 outputs via safety relay 4 A, F13 drives control 2 A.")

# 8 ---------------------------------------------------------------- consumption
h("8. Consumables and operating cost (theoretical)")
bags_h = P.RATED_BPM * 60 * 0.85
film_m2 = P.film_width(W) / 1000 * L / 1000
film_kg_h = film_g_bag * bags_h / 1000
roll_len = pi * ((P.FILM_ROLL_OD_MAX / 2000) ** 2 - (0.043) ** 2) / (P.FILM_THICKNESS_UM * 1e-6)
roll_min = roll_len / (L / 1000 * P.RATED_BPM)
kwh = demand + air_total / 1000 * 6.5 * 0.9   # ~6.5 kW per m3/min compressor specific power [ASM]
cost_h = kwh * P.TARIFF_USD_KWH + film_kg_h * P.FILM_USD_KG
R.update(film_g_bag=round(film_g_bag, 2), film_kg_h=round(film_kg_h, 2), roll_m=round(roll_len),
         roll_min=round(roll_min), kwh=round(kwh, 2), cost_h=round(cost_h, 2))
table(["Item", "Value"], [
    ["Net output at 85 % efficiency [ASM]", f"{bags_h:.0f} bags/h = {bags_h * G / 1000:.0f} kg/h"],
    ["Film per bag", f"{film_m2 * 1e4:.0f} cm2 = {film_g_bag:.2f} g"],
    ["Film per hour", f"{film_kg_h:.2f} kg"],
    [f"Length on a full {P.FILM_ROLL_OD_MAX} mm roll", f"{roll_len:.0f} m"],
    ["Running time per roll", f"{roll_min:.0f} min"],
    ["Electrical energy incl. compressor share", f"{kwh:.1f} kWh/h"],
    ["Energy + film cost", f"{cost_h:.2f} USD/h = {cost_h * P.USD_TO_IQD:,.0f} IQD/h"],
    ["Energy + film per 1000 bags", f"{1000 * cost_h / bags_h:.2f} USD = {1000 * cost_h / bags_h * P.USD_TO_IQD:,.0f} IQD"],
])
p(f"Tariff {P.TARIFF_USD_KWH} USD/kWh and film {P.FILM_USD_KG} USD/kg are placeholders [ASM]. "
  "Labour, product give-away, maintenance and depreciation are in `DOCUMENTATION/REPORTS/budget.md`.")

# 9 ---------------------------------------------------------------- footprint
h("9. Footprint derivation")
core = P.FILM_WIDTH_MAX + 30
bw = core + 20 + 2 * 45 + 2 * P.FRAME_TUBE + 140 + 200
bd = 350 + 200 + 250 + P.FILM_ROLL_OD_MAX + 100
table(["Bagger dimension", "Build-up", "Result mm", "Adopted mm"], [
    ["Width (X)", f"roller face {core} + side plates/bearings 110 + frame tubes {2 * P.FRAME_TUBE} + drive bay 140 + pneumatic/cable bay 200", bw, P.BAGGER_W],
    ["Depth (Y)", f"front guard-to-tube 350 + pull-belt carriage 200 + dancer/festoon 250 + roll {P.FILM_ROLL_OD_MAX} + 100", bd, P.BAGGER_D],
    ["Height (Z)", f"jaw plane {P.JAW_Z} (take-off conveyor 350 + max bag 300 + 50) ; belts {P.BELT_Z0}-{P.BELT_Z0 + P.PULL_BELT_LEN} ; collar top {P.TUBE_TOP_Z} ; frame top", P.BAGGER_H, P.BAGGER_H],
])
x_min = P.ELEV_INFEED_X
x_max = P.TAKEOFF_LEN - 250
y_min, y_max = -P.PLATFORM_SIZE / 2, P.PLATFORM_SIZE / 2
z_max = P.WEIGHER_BASE_Z + P.WEIGHER_HEIGHT + 500
Lx, Wy = x_max - x_min, y_max - y_min
front, side, rear = 1200, 800, 1000
FL, FW = Lx + 2 * side, Wy + front + rear
R["envelope"] = dict(L=Lx, W=Wy, H=z_max, floor_L=FL, floor_W=FW, area=round(FL * FW / 1e6, 1),
                     ceiling=z_max + 500)
table(["Line envelope", "mm", "Governed by"], [
    ["Length (X)", f"{Lx:.0f}", "elevator infeed hopper to end of take-off conveyor"],
    ["Width (Y)", f"{Wy:.0f}", "weigher access platform"],
    ["Height (Z)", f"{z_max:.0f}", "weigher base + weigher + elevator discharge head"],
    ["Bagger only", f"{P.BAGGER_W} x {P.BAGGER_D} x {P.FUNNEL_TOP_Z}", "frame + infeed funnel"],
])
table(["Clearance", "mm", "Reason"], [
    ["Front (operator, HMI, jaw doors)", front, "operator zone, door swing 600 + 600 standing"],
    ["Rear (film roll change)", rear, "roll trolley / lift access"],
    ["Left and right ends", side, "product loading at elevator hopper, bag collection"],
    ["Cabinet door", 800, "IEC 60204-1 access, door 600 wide opens >= 95 deg"],
    ["Overhead", 500, "weigher hopper removal for cleaning"],
])
p(f"**Required floor area: {FL:.0f} x {FW:.0f} mm = {FL * FW / 1e6:.1f} m2; minimum clear ceiling "
  f"{z_max + 500:.0f} mm.** These are PRELIMINARY dimensions derived from the selected "
  "components; none is a validated manufacturing dimension until the weigher and elevator "
  "supplier drawings are frozen.")

# 10 --------------------------------------------------------------- structure
h("10. Structural checks (first order)")
load = (P.WEIGHER_MASS + 150 + 2 * 100) * 9.81      # weigher + deck/chute + 2 persons
leg_A = (50 * 50 - 46 * 46) * 2 if False else (80 * 80 - 74 * 74)
I = (80 ** 4 - 74 ** 4) / 12
rg = sqrt(I / leg_A)
slender = 2000 * 1.0 / rg
sigma = load * 1.5 / 4 / leg_A
Pcr = pi ** 2 * 193000 * I / (2000 * 2.0) ** 2
table(["Check", "Value"], [
    ["Platform design load (weigher + deck + 2 persons)", f"{load:.0f} N"],
    ["Leg section", "SHS 80 x 80 x 3, 1.4301 (304)"],
    ["Axial stress per leg, load factor 1.5", f"{sigma:.1f} MPa (yield 210 MPa)"],
    ["Slenderness (K=1)", f"{slender:.0f}"],
    ["Euler buckling load per leg, K=2 (unbraced cantilever)", f"{Pcr / 1000:.0f} kN vs demand {load * 1.5 / 4 / 1000:.1f} kN"],
])
p("Stress is not the governing criterion; **stiffness is**. A multihead weigher needs a "
  "platform whose first natural frequency is well above the feeder excitation and the "
  "weigh-cell filter band (suppliers typically ask for > 15 Hz and floor vibration "
  "< 0.1 g). The platform therefore gets diagonal bracing on three sides and floor "
  "anchors, and the bagger is NOT bolted to it - the jaw impact must not reach the load "
  "cells. A modal FEA of the welded platform is an open action before release.")

with open(os.path.join(HERE, "03_ENGINEERING_CALCULATIONS.md"), "w") as f:
    f.write("\n".join(out) + "\n")
with open(os.path.join(HERE, "calc_results.json"), "w") as f:
    json.dump(R, f, indent=2)
print(json.dumps(R, indent=1))
