qaessafty-arch/Plc/(commit log)

2026-11-11 Add SPM-420 snack filling and packaging machine design package
    Preliminary engineering package for a multihead-weigher + vertical
    form-fill-seal snack line: reference analysis, specification,
    calculations, parametric CAD (STEP/STL/DXF/PDF), electrical design,
    S7-1200 Structured Text program, HMI specification and prototype,
    closed-loop simulation with fault scenarios, FastAPI/React monitoring
    software, BOM with three budget configurations, manufacturing, safety
    and test documentation.
    Nothing is validated on hardware; all figures are calculated or
    simulated and labelled accordingly.
    Claude-Session: https://claude.ai/code/session_01Hh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
    [B01_main_frame.dxf, B01_main_frame.step, B01_main_frame.stl, B02_film_roll.dxf, B02_film_roll.step, B02_film_roll.stl, B03_unwind_shaft.dxf, B03_unwind_shaft.step]
2026-11-11 Replace unusable isometric SVG export with rendered assembly and exploded views
    Claude-Session: https://claude.ai/code/session_01Hhh9uKDzXmJAP7xri2d8G6
    [build_cad.py]
2026-11-11 Send the weigher dump before the film pull so the charge lands on closed jaws
    The dump request was issued when the jaws started to close. With a ~0.70 s
    fall, the charge reached the jaw plane 8 ms after the jaws had reopened and
    landed on a hot seal held only by the film.
    FB_BagCycle now sends the dump request in step 10, Recipe.DumpLead_ms
    (default 55 ms) before the film pull, and starts the pull at the pacing time
    or DumpLead after a late dump. In the model the whole charge now lands on
    the closed jaws (0.646-0.996 s, 52 ms margin each side) for any lead from
    about 10 to 100 ms. Replaces DumpAdvance_ms in the UDT, HMI tags and
    prototype.
    Also fixes the reported speed: CycleTime_ms was ta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
    [hmi_tags.csv]
2026-11-11 Add NULL-TECH 3D web viewer and brand the client PDF
    WEB3D/ is a static site for Vercel: interactive three.js viewer of the
    assembly (view presets, explode, part list with show/hide and isolate,
    click-to-inspect, see-through guards), key figures, cycle timing,
    drawings, status and downloads. three.js 0.160.0 is bundled so the site
    does not depend on a CDN. CAD/SCRIPTS/export_web.py exports the named-part
    GLB and part data from the parametric model.
    The client overview PDF now carries NULL-TECH Engineering Studio branding.
    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
    [SPM-420_assembly.step]
2026-11-11 Add process simulation to the 3D web viewer
    Run/Pause/Reset and speed control on the model: elevator buckets carry
    product up, weigher heads light up and drop a charge, chips fall through
    the forming tube, the jaws and vertical seal bar move, bags grow below
    the jaws, are cut, drop and ride the take-off conveyor. Jaw, seal-bar
    and film motion replay model/cycle.json, one cycle of the PLC-logic
    simulation; a readout shows the PLC step, cycle time, jaw state, bag
    count and rate. Labelled as simulated, not measured.
    The jaw assembly is split into fixed, front and rear pieces in the web
    export so the jaws can move; the CAD assembly itself is unchanged.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
    [B01_main_frame.step, B02_film_roll.step, B03_unwind_shaft.step, B04_guide_rollers.step, B05_dancer_arm.step, B06_forming_tube.step, B07_forming_collar.step, B08_infeed_funnel.step]
2026-11-11 Add the 3D simulation to the client overview PDF
    New page with the site link, an overview frame and a four-step storyboard
    captured from the web simulator, a table of what the page offers, and a
    note on what the simulation is and is not. Site download updated.
    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
